Stratolink-hq/Stratolink/analysis/v1_1_release_20261012/uv_followup/README.md

# UV replacement decision for the three-board v1.1 pilot

2026-10-13. **Separate UVA and UVB measurements would materially improve the ozone experiment. AS7331 is the strongest compact integrated candidate identified, including after the expanded direct-LCSC search.** It requires a local PCB and firmware change. LCSC does list multiband UV parts, but the inspected AS7331 entries are unavailable; catalog existence and assembly inventory are different facts. An available detector with one combined UV output does not provide the missing second measurement.

My recommendation is **pursue AS7331 for the multiband pilot, with supplier allocation and a local ECO resolved before assembly release**. The observed DigiKey bare-chip arrival estimate is November 9, not a guaranteed delivery. No UV population change, DNP choice, or order has been made by this review. A successful electrical prototype does not require completed ozone-retrieval validation before fabrication; it does require raw data, characterized optics and honest experimental labeling. If obtaining the assembled boards immediately is the overriding requirement, the UV population/sourcing trade-off needs an explicit decision rather than silently omitting the sensor.

## What is actually available

Stock observations are from October 13, not reservations. Public distributor inventory does not establish JLC consignment acceptance or feeder allowance.

| Candidate | Measurement / current sourcing | Decision |
|---|---|---|
| LTR-390UV-01, C492374 | Present one UV channel plus separate visible ALS mode. JLC draft requires three and shows three short. | Retains the old capability only; does not meet the new multiband objective. |
| AS7331-AQFM / AQFT | Three separate UVA/B/C channels. Root's live JLC search: all seven entries have zero stock. Direct LCSC search: three listed bare-chip entries all zero; additional aliases below. DigiKey AQFM: zero, $9.16 at quantity one, 1,000 expected November 9; AQFT: zero, 4,949 expected November 9. Mouser AQFM: zero, 9,090 expected November 23. | Preferred compact **research** IC, not a presently allocated assembly part. Dates are estimates. |
| VEML6075 | UVA/UVB and compensation outputs, but Vishay terminated it in 2019. Root's live JLC C75329 and SB listings both zero. Canonical LCSC C75329 says Not available now. | A legacy comparison option if traceable old stock appears; weak basis for the next production batch. |
| ZOPT2202 | A third true integrated UVA/B part discovered in the broader search; Renesas marks it Obsolete. Direct LCSC exact-name search returns zero results; no authorized available bare stock found. | Interesting historical compact alternative, not a verified sourcing solution. |
| **GUVA-C22SD + GUVB-C21SD** | Smaller **2.4 × 1.8 mm** packages. Opened DigiKey pages show **2,717 / 5,863** respectively, **$4.13 / $4.64**, or **$8.77 per detector pair** at quantity one. | Practical stocked discrete ground-prototype alternative; add analog acquisition and cold qualification. LCSC's complete 39-part Genicom catalog shows zero stock. Not a same-footprint substitute. |
| GUVA-S12SD + GUVB-S11SD | Larger **3.5 × 2.8 mm** packages. Live DigiKey pages show **2,970 / 1,654** respectively, **$6.59 / $4.64**, or **$11.23 per detector pair**. | Retained comparison; the smaller C22SD/C21SD pair is preferable for initial space/cost evaluation. |

Evidence: [JLC AS7331 capture](../sourcing_followup/as7331-jlc-search.txt), [JLC VEML6075 capture](../sourcing_followup/veml6075-jlc-search.txt), [DigiKey AS7331 AQFM](https://www.digikey.com/en/products/detail/ams-osram-ag/AS7331-AQFM-OLGA16-LF-T-R/16983757), [AQFT](https://www.digikey.com/en/products/detail/ams-osram-ag/AS7331-T-OLGA16-LF-T-RDP/16983752), [Mouser AS7331](https://www.mouser.com/en/c/semiconductors/sensor-ics/ambient-light-sensors/?m=ams+OSRAM&series=AS7331), [Vishay termination notice](https://mm.digikey.com/Volume0/opasdata/d220001/medias/docus/320/PTN-OSI-01059-2019-Rev-0.pdf), [GUVA stock](https://www.digikey.com/en/products/detail/genicom-co-ltd/GUVA-S12SD/9960951), [GUVB stock](https://www.digikey.com/en/products/detail/genicom-co-ltd/GUVB-S11SD/9960952).

The smaller-pair stock, all 39 LCSC catalog entries, low-power amplifiers and signal calculations are documented in [the discrete-detector review](discrete-lcsc.md). JLC Global Sourcing and consignment are valid future routes, but require received inventory, exact MOQ/spare confirmation and separate procurement. No AS7331 allocation was obtained; current official overseas-consignment fee pages also conflict. [Procurement review](procurement.md).

The AS7331 manufacturer page still labels its orderables Pre-production, while DigiKey says Active. The page and v4-00 datasheet specify −40…85 °C; some distributor metadata says +105 °C. Use the primary −40…85 °C limit pending written exact-grade clarification. A listed 2025 substrate-supplier PCN is not an end-of-life notice. No sustainable-stock assurance was obtained. [Manufacturer product page](https://ams-osram.com/products/sensor-solutions/ambient-light-color-spectral-proximity-sensors/ams-as7331-spectral-uv-sensor), [manufacturer PCN](https://mm.digikey.com/Volume0/opasdata/d220001/medias/docus/6689/C_Prel-PCN_AO-PCN-2025-026-N_ext.pdf).

Root's live Browser resolved the conflicting public extraction for SparkFun SEN-23517: its actual product UI shows **$27.50, Backorder**, with the Backorder control disabled. Adafruit 6476 shows **$22.50, Out of stock**. Both corresponding DigiKey listings also show zero. These do not establish an immediately obtainable small reference board. [SparkFun live capture](../sourcing_followup/sparkfun-as7331-actual-ui.txt), [Adafruit live capture](../sourcing_followup/adafruit-as7331-actual-ui.txt), [SparkFun product](https://www.sparkfun.com/sparkfun-spectral-uv-sensor-as7331-qwiic.html), [DigiKey SEN-23517](https://www.digikey.com/en/products/detail/sparkfun-electronics/23517/22321024), [Adafruit product](https://www.adafruit.com/product/6476).

**One verified official bench-evaluation route exists:** DigiKey's AS7331 EVALKIT 0V2 page shows **three kits in stock, $321.07 each**. The manufacturer's EVK includes an optical adapter and USB interface. It can start optical/firmware research while bare devices are sourced; it does not supply three economical assembly parts and is not an ozone reference standard. The manual explicitly calls its supplied adapter a design example that is not fully UV-opaque; accurate angle control requires suitable opaque material, such as metal. Nothing was added to a cart. [DigiKey official EVK](https://www.digikey.com/en/products/detail/ams-osram-ag/AS7331-EVALKIT-0V2/16983753), [manufacturer EVK guide, §6](https://docs.rs-online.com/a3b1/A700000010106066.pdf).

## Expanded LCSC and supplier coverage

The following separates live Browser evidence supplied by the root agent from public-page extraction. Missing stock text is recorded as unknown, not zero. This is a bounded catalog review, not proof that every possible Chinese-market UV detector has been exhausted.

| Exact catalog evidence | Result on October 13 | Consequence |
|---|---|---|
| Direct LCSC AS7331 search; C17474749, C20484730, C20482877 | All three displayed entries zero; C17474749's own page explicitly Out of Stock. | Direct LCSC adds an alias missing from the original JLC search but no confirmed supply. |
| JLC AS7331 search; C5793699, C7529330, C22457702, C19189439, C20598550, C20482877, C20484730 | Seven entries, all zero in JLC/idle/my stock. | Do not conflate seven SKUs with seven different sensors. |
| LCSC VEML6075 C75329 | Canonical page Not available now; JLC C75329 and C19278419 VEML6075-SB zero. | A search result on `fat.lcsc.com` advertising 100 pieces was not accepted as production-site stock evidence. |
| LCSC Si1133-AA00-GMR C965911 / AA00-GM C3678545 | Root's direct pages explicitly Not available now. | Not an immediate fallback; spectral limitations below also apply. |
| LCSC Genicom photodiodes category | **All 39 results across both pages individually show zero stock**: 25 on page one, 14 on page two. | Covers the full displayed category, including several UVA and UVB packages. |
| Direct LCSC GUVA-S12SD C7200747; GUVB-S11SD C6954997; GUVB-C21SD C6565190; GUVB-S11SM-LA C5756514 | Each inspected public page Out of Stock. | The two analog responses exist in LCSC's catalog but were not available through these inspected listings. |
| Direct LCSC exact-name ZOPT2202 search | Zero results. | Confirms this query found no catalog entry; does not exclude every alias. |
| Indexed exact-name queries for sGlux and Hamamatsu S1226 | No confirmed appropriate available LCSC listing obtained. | Search absence is not a supplier-wide impossibility claim. |

Live captures: [LCSC AS7331 search](../sourcing_followup/lcsc-as7331-search.txt), [AS7331_M detail](../sourcing_followup/lcsc-as7331-C17474749.txt), [Si1133 GMR](../sourcing_followup/lcsc-si1133-C965911.txt), [Si1133 GM](../sourcing_followup/lcsc-si1133-C3678545.txt), [Genicom page one](../sourcing_followup/lcsc-genicom-page1.txt), [page two](../sourcing_followup/lcsc-genicom-page2.txt), [ZOPT2202 query](../sourcing_followup/lcsc-zopt2202-search.txt). Public pages: [VEML6075 C75329](https://www.lcsc.com/product-detail/C75329.html), [Genicom category](https://www.lcsc.com/brand/1263-13647.html), [GUVA-S12SD](https://www.lcsc.com/product-detail/C7200747.html), [GUVB-S11SD](https://www.lcsc.com/product-detail/C6954997.html), [GUVB-C21SD](https://www.lcsc.com/product-detail/C6565190.html), [GUVB-S11SM-LA](https://www.lcsc.com/product-detail/C5756514.html).

Additional bare-AS7331 coverage found Future Electronics global/factory/on-order inventories all zero (minimum reel 1,000, quoted 16 weeks). Avnet's indexed listing also showed zero; its fresh open failed. Arrow's indexed page said NRND and did not verify available stock; a fresh open failed. Rutronik's listing said on request/50 weeks. Farnell's distributor lifecycle label conflicts with ams' own page, so it is not treated as a manufacturer EOL declaration. These results do not justify trusting an unverified broker's large-stock claim. [Future Electronics](https://www.futureelectronics.com/p/semiconductors--analog--sensors--light/as7331-aqfm-ams-osram-3169993), [Avnet](https://www.avnet.com/americas/manufacturers/m/c/ams-osram/sensors-and-transducers-optical-sensors/), [Arrow](https://www.arrow.com/en/products/as7331-aqft/ams-osram.html), [Rutronik](https://www.rutronik24.com/pg/other-sensors/icinot/), [Farnell](https://de.farnell.com/ams-osram-group/as7331-aqfm/umgebungslicht-n-herungssensor/dp/4158736).

The SparkFun mini SEN-23518's public extraction has a conflicting stock-header/backorder presentation; DigiKey's opened mini page is zero. The standard SEN-23517 board's actual UI was separately resolved as backorder above. MikroE's own UV 5 Click page explicitly says it is no longer in stock. Micro Robotics' generic AS7331-MOD search result claimed local South African stock, but a stable detailed stock retrieval, chip provenance and US delivery were not established; it remains an unverified lead rather than the recommended supplier. [Mini DigiKey page](https://www.digikey.com/en/products/detail/sparkfun-electronics/23518/22321098), [MikroE](https://www.mikroe.com/uv-5-click), [generic-module lead](https://www.robotics.org.za/AS7331-MOD).

## Why the other integrated parts are not equivalent

**ZOPT2202** measures separate UVA/UVB with compensation channels. Its 1.7–3.6 V, −40…90 °C, 2.0 × 2.2 × 0.7 mm LGA6 is attractive electrically and mechanically, but it is obsolete and its pins differ from U6: 1 SCL, 2 SDA, 3 VDD, 4 INT, 5 GND, 6 NC. Its raw mode requires a specific initialization and application compensation; the datasheet calls for another application note for digital trimming. It would need a new footprint, wiring and driver, not just a BOM substitution. [Renesas product status](https://www.renesas.com/en/products/zopt2202), [datasheet §§3.3–3.4](https://www.renesas.com/en/document/dst/zopt2202-datasheet).

**VEML6075** has separate outputs, but the primary datasheet puts the nominal “UVB” peak at 330 nm, in UVA, with a short-wavelength tail. A channel label does not establish an optimal ozone-sensitive UVB response. Its 4-pad 2 × 1.25 mm land pattern also differs from U6. [Vishay datasheet](https://mm.digikey.com/Volume0/opasdata/d220001/medias/docus/1256/VEML6075.pdf).

**Si1133** actually measures UV, unlike a visible/IR-only UV-index estimate. Its ADC mux exposes UV and UV-Deep selections, but the inspected datasheet specifies one UV sensitivity point at 310 nm, not a characterized independent UVA/UVB pair; its dual ADCs also serve dark-reference cancellation. Establishing usable independent band responses would need spectral characterization rather than assuming “Deep” means a second desired band. The manufacturer-authored Rev 0.91 is marked Not Recommended for New Design. [Si1133 datasheet §§3.1–3.2, 7.2.1, 8](https://www.mouser.com/datasheet/2/368/Si1133-1397754.pdf).

**sGlux filtered UVA and UVB photodiodes** are a legitimate alternative family, but they are separate analog detectors requiring front-end circuitry and optical qualification. **Hamamatsu broad UV-enhanced photodiodes** need suitable filters and strong visible rejection to form a ratio instrument. Neither yields a verified in-stock, same-footprint LCSC digital substitute from this search. [sGlux primary catalog](https://sglux.de/en/product-category/sic-uv-photodiodes/).

## AS7331 integration scope

The native audit was rerun after the R4/U2 metadata promotion on canonical `hardware/pcb/stratolink.kicad_pcb`, SHA-256 `8e2f83797dd68195aa71b73fc252fe57e53ccd3683ef5f74739dc4d25d6ce8d5`. U6 is front-side at (69.098, 40.606) mm. Its six pins are +3.3 V, NC, GND, SCL, grounded INT, SDA, and still match the freshly exported schematic netlist. **The release has already corrected the old schematic/footprint identity mismatch.** The unused older `hardware/v1.1` tree is not the current release. [Promotion evidence](../sourcing_followup/promotion.json).

AS7331 uses a 2.60 × 3.65 × 1.09 mm OLGA16 body, 2.7–3.6 V supplies and I²C. At 3.3 V its specified active current is 1.42 mA typical / 2 mA maximum, standby 970 µA maximum, power-down 1 µA maximum at the electrical table's conditions. It needs a 3.3 MΩ ±1%, ≤50 ppm/K reference and local supply decoupling. The newly opened manufacturer-hosted PDF is the same v4-00 revision as the locally cached copy. [Manufacturer v4-00 datasheet](https://look.ams-osram.com/m/1856fd2c69c35605/original/AS7331-Spectral-UVA-B-C-Sensor.pdf).

Proposed net mapping for a future ECO:

| AS7331 pins | Proposed connection |
|---|---|
| 1, 2, 5, 6, 15, 16 VSSA; 11 VSSD | Ground; implement short analog/digital return connection near the chip |
| 3 VDDA; 10 VDDD | Existing 3.3 V, locally decoupled |
| 4 REXT | Specified reference to VSSA, same PCB side |
| 7 A1; 14 A0 | GND, selecting 0x74; existing MS5611 uses 0x76 |
| 12 SDA; 13 SCL | Existing I²C bus; verify combined pull-ups and rise time |
| 8 SYN; 9 READY | Optional test provisions; polled command mode needs no extra MCU pins. Give unused SYN a defined level; do not ground the READY output. |

The replacement needs all-new lands and escapes; the present six pads cannot be reused. The reviewed U7 routing immediately north of U6 includes a specific 0.128 mm passage next to U6 pad 6. Reopening this area requires a fresh U7 keepout, clearance, decoupling, placement, paste and optical-obstruction review; remove obsolete U6-specific rule exceptions if their geometry disappears. No replacement placement, routing or mass measurement has been done here. [Current local assembly review](../identities/README.md), [native audit](audit.json).

The modest measurement power is not the main obstacle. Calculated module-only costs are 6.6 mJ for one second at the table maximum, 110 µW measurement average at one second/minute, or 1.406 J for five minutes at typical active current. These exclude MCU, converter and bus overhead and do not select an exposure. Use explicit power-down after daylight windows; standby would consume 3.20 mW. Verify leakage and restart at the actual component temperature. A −40 °C rating does not establish operation in colder air or at low pressure.

Firmware requires a new driver and explicit hardware population selection, not an address change. Preserve bounded I²C timeouts, reset recovery, conversion-complete checks and the existing optical quiescence fault policy. AS7331 command mode can wake for one conversion and return to power-down. Log all raw channels, gain, integration time, divider, flags and die temperature with fresh UTC/position. Its shared exposure settings mean bright UVA and weak UVB may require bracketed exposures; retain simultaneous samples within each exposure.

The current telemetry only carries integer UVI and visible lux. **AS7331 does not replace visible ALS.** Mark legacy `ambient_lux` unavailable; do not manufacture lux from UV or leave stale values. Version the science payload and decoder to retain multiband counts and configuration. Search found no `ambient_lux` input to current firmware power decisions; power gating uses the ADC policy. The present LTR driver already treats a never-enabled absent sensor as quiescent, which supports a deliberate DNP build, but pilot firmware should explicitly select that population to avoid pointless retries. Sources: `firmware/src/sensor_ltr390.cpp`, `main.cpp`, `telemetry.cpp`, `include/telemetry.h`, `stratolink_pins.h`; hashes in the audit.

## What this adds to ozone measurement

A second UV band adds ozone-sensitive information. In a simplified calibrated direct-beam model,

`ln(B/A) = known spectral baseline − m × ozone_column × (effective_absorption_B − effective_absorption_A) + differential_nuisance`.

The ratio can cancel a common illumination factor. If differential cloud/aerosol transmission, angular filter shift, stray light or relative gain are unknown, ozone and those effects still cannot be separated from that ratio alone. Broad-band effective absorption also depends on the transmitted spectrum. This is a structural limitation, not something more ADC bits removes. A third UVC channel can be valuable diagnostically but may have very little solar signal below most of the ozone layer.

**Newly verified optical detail:** ams' design guide explicitly recommends detector incidence within ±10° because oblique rays shift/deform its interference filters. It places a diffuser **in front of angle-limiting optics**, not directly on the detector. The guide also confirms that gain/time settings are shared across channels and calls for dark, gain, temperature and spectral-response corrections. This resolves the older report's uncertainty about the incidence specification. [AS7331 Design Guidelines, §§2, 4, 7](https://look.ams-osram.com/m/45d5dfb4a22ecb04/original/AS7331_Design_Guidelines_PD001048_2-00.pdf).

An ozone prototype therefore needs an unobstructed, characterized optical collector; dark/linearity/saturation checks; angular and temperature sweeps; and a spectral forward model fitted and evaluated on independent data. Start fixed on the ground against a calibrated spectral reference, then add the real enclosure and motion. Published spectral double-ratio methods support that validation path, not a promised accuracy for this chip. [Egli et al., 2023](https://amt.copernicus.org/articles/16/2889/2023/).

The attainable product is initially raw/calibrated UV measurements and an experimental **ozone column above the balloon**. It is not local ozone concentration or automatically a vertical profile. The historical LTR390 note's numerical precision promises remain unsupported. Nothing here establishes a percentage ozone accuracy.

## Stocked analog alternative: useful, but a larger experiment

The practical discrete candidate is **GUVA-C22SD + GUVB-C21SD**, costing **$8.77 in detectors** at the observed single-unit prices, each in a 2.4 × 1.8 mm package. GUVA-C22SD responds over 240–370 nm; the DigiKey-linked 2018 GUVB-C21SD sheet gives 240–320 nm. These are overlapping responses, not isolated rectangular bands. Both are specified only to −30 °C. A newer GUVB sheet changes the stated responsivity and lower band edge, so the purchased lot needs a controlled specification and calibration. [GUVA-C22SD source](https://www.digikey.com/en/products/detail/genicom-co-ltd/GUVA-C22SD/9960950), [GUVB-C21SD source](https://www.digikey.com/en/products/detail/genicom-co-ltd/GUVB-C21SD/10474936), [detailed comparison](discrete-lcsc.md).

Each produces photocurrent, so add two low-leakage transimpedance paths, feedback/compensation components and ADC acquisition, or an I²C ADC on a reference daughterboard. Two LCSC-stocked TSU111ICT amplifiers add **$3.662**, bringing detectors/amplifiers to **$12.432** before passives, ADC, optics and assembly. Their calculated amplifier-only idle consumption is **5.94 µW typical**, or **9.77 µW maximum at the specified full-temperature conditions**, at 3.3 V. ADC/reference power and actual PCB leakage remain to be designed. This supports a concrete ground experiment without promising a ready replacement for U6. [AFE sources and reproducible model](discrete-lcsc.md).

The older **GUVA-S12SD + GUVB-S11SD** comparison costs **$11.23 for detectors alone** and uses larger 3.5 × 2.8 mm packages. It has similar overlapping broad UV responses and the same −30 °C operating limit. Its higher price is for a different package pair, not a second quote for the smaller candidate. [GUVA-S12SD datasheet](https://mm.digikey.com/Volume0/opasdata/d220001/medias/docus/6128/GUVA-S12SD%20%282%29.pdf), [GUVB-S11SD datasheet](https://mm.digikey.com/Volume0/opasdata/d220001/medias/docus/5786/GUVB-S11SD_Rev1.0_2018.pdf).

For scale only, GUVB's typical sunlight example gives 1.4 nA at UVI 1. A hypothetical 10 MΩ transimpedance gives 14 mV: about 17 counts on an ideal 12-bit, 3.3 V ADC. That illustrates why analog leakage, noise and offsets need attention; it is not a universal UVI conversion, selected amplifier design or ozone precision estimate. The detector itself needs no supply in photovoltaic mode. The amplifier budget above is only part of the complete acquisition budget.

ML8511A's one analog output is sensitive to both UVA and UVB together; replacing LTR390 with it would not produce a ratio. AS7341/AS7343/TCS3448 visible/NIR spectral parts similarly do not supply the needed short-UV channel. “Multispectral” alone is not the requirement. [ROHM ML8511A datasheet](https://www.rohm.com/documents/11303/4214223/FEDL8511A-02-e.pdf), [ams AS7343/TCS3448 product information](https://ams-osram.com/de/products/sensor-solutions/ambient-light-color-spectral-proximity-sensors/ams-as7343-spectral-sensor).

This review performed no CAD or firmware edits, supplier selections or purchases. Reproduce the pin and arithmetic evidence with KiCad's bundled Python and `audit.py`. Research used cached primary datasheets plus public web fallback explicitly authorized by the parent after this subagent's documented in-app Browser discovery returned no backends. Root supplied the live JLC and direct LCSC evidence. [Source ledger and retrieval limits](SOURCES.md).
