Stratolink-hq/Stratolink/analysis/v1_1_suspension_20261012/sources/README.md

# Source scope

Read 2026-10-12 in the Codex in-app browser.

- [JLCPCB capabilities](https://jlcpcb.com/capabilities/pcb-capabilities): current thin-board, dimensional, drilling, copper plating and mask capabilities. Saved visible table text accompanies this record. A 2 mm ordinary plated hole does not invoke the thicker-board requirement for plated board edges/castellations. The 18 µm barrel figure is an **average**, not a minimum or guaranteed mechanical reinforcement. Finished hole tolerance is +0.13/−0.08 mm; position ±0.075 mm; actual fabrication compensation is not measured here.
- [Shengyi S1141](https://www.syst.com.cn/en/product/info_122.aspx?itemid=1176): manufacturer typical material data. Reported flexural data use **1.6 mm specimens** and are not qualified allowables for the unknown laminate and 0.31 mm core in this payload. No strength safety factor or failure load is derived from them.

The strongest geometry evidence is the actual frozen KiCad board at `a9d6ed5`. The line topology comes from Teddy's description of stretchy string threaded through both holes and tied into a triangular suspension at the top. Diameter, material, friction, creep, knots, preload and apex height remain unmeasured.
