Stratolink-hq/Stratolink/analysis/v1_1_solar_attachments_20261012/qualification/sources/README.md

# Primary photo source

The in-app browser captured the first photo on [ZachTek SKU1044](https://www.zachtek.com/product-page/copy-of-solar-cell-for-pico-balloons-polymer-4-8v-50ma) on 2026-10-12. The photo contains a printed metric grid used for the panel dimension calibration. The source is preserved as `zachtek-metric-photo-browser.png`; its hash is recorded and verified by `../metrology/measure.py`.

The rendered product image's DOM supplied this [Wix-hosted image URL](https://static.wixstatic.com/media/859ef0_be8b73c86bbd4d29b8d6aa655b6c03f7~mv2.jpg/v1/fill/w_962,h_1102,al_c,q_85,usm_0.66_1.00_0.01,enc_avif,quality_auto/859ef0_be8b73c86bbd4d29b8d6aa655b6c03f7~mv2.jpg). It was viewed directly in the browser and captured there. Use pixel coordinates from the saved capture; its image region does not occupy the full 1280 × 1102 screenshot.

The product listing supplies nominal 4.8 V, 50 mA and 1.76 g but no mechanical drawing, prepared terminal thickness or joint strength. Existing vendor-text and assembly-guidance captures are in the parent study's `sources/` directory. Similar PowerFilm products were investigated but no positive manufacturer/part match was established, so none of their dimensions or material specifications are assigned to this panel.
