Stratolink-hq/Stratolink/web/ASSETS.md

# Assets

## Launch scene

The source is Teddy Warner's launch photograph, supplied as `/Users/twarn/Downloads/IMG_3466.jpeg` (2560 × 1440). The unchanged source photo is served locally as `public/assets/launch/source.jpg`.

| Asset | Dimensions | Use |
| --- | --- | --- |
| `public/assets/launch/source.jpg` | 2560 × 1440 | Source photograph for the layer compiler and placeholder |
| `public/assets/launch/sky.webp` | 2560 × 1440, RGB | Served sky plate: `sky.png`'s colour with the original photograph's detail in clear sky (`scripts/prepare-launch-sky.py`) |
| `public/assets/launch/social-card.jpg` | 1200 × 630 | Still link-preview card: graded crop of the original photograph with the wordmark; frame 0 of the loop |
| `public/assets/launch/social-card-loop.gif` | 1200 × 630, 223 frames | Link-preview image (`og:image`, `twitter:image`): the balloon rises out of frame, then the next rises from the clouds into place (8.9 s loop) |
| `public/assets/launch/social-card-loop.mp4` | 1200 × 630, H.264 | The same loop as `og:video`; iMessage autoplays it muted and looped |
| `public/assets/launch/sky.png` | 1672 × 941, RGB | Clear sky plate inpainted with the built-in image generator; fills behind the moving city, clouds and balloon |
| `public/assets/launch/city-clouds.png` | 1672 × 941, RGBA | Generated alpha mask for the original skyline, clouds and foreground palm |
| `public/assets/launch/balloon.png` | 1672 × 941, RGBA | Generated alpha mask for the original balloon, tether and payload |
| `public/assets/launch/city-desktop.webp` | 2560 × 1440, RGBA | Compiled desktop foreground |
| `public/assets/launch/city-mobile.webp` | 2560 × 1440, RGBA | Compiled mobile foreground with sky residue removed |
| `public/assets/launch/balloon-cutout.webp` | 205 × 403, RGBA | Compiled balloon, tether and payload |
| `public/assets/stratolink-wordmark.svg` | 7581 × 1510 viewBox | Lowercase Stratolink wordmark, Helvetica Regular converted to outlines; header and footer |

The original extraction files supply alpha only; their generated RGB pixels are not displayed. `scripts/prepare-launch-layers.mjs` compiles the original photograph through those masks using the same SVG filters. It writes `city-desktop.webp`, `city-mobile.webp` and the tightly cropped `balloon-cutout.webp`. The mobile version retains the alpha transfer that removes faint sky residue. The balloon keeps its dilated, feathered tether and restricted mask bounds. Runtime layers are transparent images, so phones do not need to rasterize the SVG filters. Regeneration requires `rsvg-convert` and `cwebp`; the compiled files are committed and deployment has no extra tool dependency.

The city layers retain the photograph's 2560 × 1440 framing. The balloon is a 205 × 403 crop at (1228, 432), positioned within that same frame. Encoding uses WebP quality 90 and alpha quality 100. The sky plate remains an inpainted approximation of the original clear-sky gradient, including areas originally hidden by foreground objects.

The served sky is rebuilt at the full 2560 × 1440 with `python3 scripts/prepare-launch-sky.py /path/to/IMG_3466.jpg` (numpy, Pillow, `cwebp`). The full-quality original is needed: `source.jpg` is a heavily compressed copy whose sky shows block artefacts when phones scale it up. The script keeps `sky.png`'s colour and gradient everywhere, adds the photograph's own grain where the sky is clear, and matching synthetic grain where the city, clouds and balloon hide it.

The homepage also carries a 32 × 18 blurred placeholder of `source.jpg` inlined as a base64 WebP in `index.html` (between the `home-placeholder` markers). It paints behind the hero while the full layers download. Regenerate it with `node scripts/prepare-launch-placeholder.mjs` (requires ImageMagick `magick`) after changing the source photograph.

Exact built-in image generation prompts, output provenance and known extraction limits are recorded in [reference/launch-layer-prompts.md](reference/launch-layer-prompts.md). Page text uses Helvetica with Arial as a fallback.

An unused white-cloud experiment is archived at `reference/experiments/footer-cloud.png`, outside the production build. Its exact prompts and native output provenance are recorded in [reference/footer-cloud-prompt.md](reference/footer-cloud-prompt.md).

## Inline payload

`public/assets/launch/payload-cutout.png` is a 384 × 256 transparent extraction generated from Teddy's `DSCF0471.JPG`. It appears inline in the homepage's fourth paragraph. The original photograph is unchanged. [Prompt and provenance](reference/payload-cutout-prompt.md) record the built-in imagegen edit and its limits.

## Dashboard

The dashboard's logo and TTN gateway files are unchanged copies from [`Stratolink-hq/Stratolink` at `b95c4f4`](https://github.com/Stratolink-hq/Stratolink/tree/b95c4f4dee684e73fbfdb2d5af2df13a3dd87949/web/public), imported October 5, 2026. Their original public paths are preserved.

| Runtime file | Bytes | Use |
| --- | ---: | --- |
| `public/stratolink-header-logo.png` | 109,433 | Dashboard header wordmark |
| `public/ttnmapper-gateways.json` | 577,506 | Gateway coordinates |
| `public/ttnmapper-coverage.json` | 788,268 | Inner coverage polygons |
| `public/ttnmapper-coverage-outer.json` | 490,552 | Outer coverage polygons |
| `public/assets/dashboard/fonts/*.woff2` | 285,052 total | 13 unchanged Inter and JetBrains Mono files served by the live site's Next font stylesheet |

Font faces, Unicode ranges and fallback metrics are preserved in `src/dashboard/fonts.css`. The telemetry theme retains its upstream Google Fonts import for Space Grotesk, Inter and JetBrains Mono. Mapbox supplies map styles, tiles and night-light imagery at runtime; these are not copied into the repository. Public telemetry and forecasts remain live data rather than bundled snapshots.

The imported dashboard assets total 2,250,811 bytes. [Dashboard import provenance](reference/dashboard-import.md) records their SHA-256 hashes, font source URLs and runtime dependencies.

## Archived Opal reference assets

The Opal visual assets and fonts were retrieved from [Opal Electronics](https://op.al/) on October 5, 2026 for the initial local reference recreation. They are preserved under `reference/opal-assets/`, outside `public/`, and are not shipped by the current page.

| Local file | Original source | Details |
| --- | --- | --- |
| `reference/opal-assets/DieGrotesk-C-Regular.woff2` | [Regular font](https://op.al/fonts/DieGrotesk-C-Regular.woff2) | Die Grotesk C, weight 400 |
| `reference/opal-assets/DieGrotesk-C-Bold.woff2` | [Bold font](https://op.al/fonts/DieGrotesk-C-Bold.woff2) | Die Grotesk C, weight 700 |
| `reference/opal-assets/desktop-first-frame-long-may6.avif` | [Desktop poster](https://op.al/images/desktop-first-frame-long-may6.avif) | 2160 × 3840, original desktop first frame |
| `reference/opal-assets/mobile-first-frame-may6.avif` | [Mobile poster](https://op.al/images/mobile-first-frame-may6.avif) | 1440 × 7300, original mobile first frame |
| `reference/opal-assets/noise.avif` | [Noise texture](https://op.al/images/noise.avif) | 400 × 400, original grain tile |
| `reference/opal-assets/footer-canvas-logo.svg` | [Footer logo](https://op.al/svg/footer-canvas-logo.svg) | 1561 × 743 viewBox, canvas dot mask |
| `reference/opal-assets/opal-electronics.svg` | [Homepage](https://op.al/) | Header SVG extracted from the public HTML, 130 × 40 viewBox |
| `reference/opal-assets/share-1200x630.jpg` | [Share image](https://op.al/images/share-1200x630.jpg) | Original social preview image |
| `reference/opal-assets/table-desktop.mp4` | [Desktop video stream](https://stream.mux.com/YB6EvIvPQIBZ02XNCo4FyikxpaamDsTp4OSgtSxVJlIM.m3u8) | 2160 × 3840, 118.3 seconds; H.264 CRF 24, original resolution, fast start |
| `reference/opal-assets/table-mobile.mp4` | [Mobile video stream](https://stream.mux.com/i00IsRNG1QFKYPOWSEDqo4eTloV2E2heEd2wzXMMbNgo.m3u8) | 758 × 3840, 49.43 seconds; original H.264 stream remuxed with fast start |

The reference footage, fonts, logos and copy remain their respective owners' work. `reference/opal-essay.html` preserves the original page reference. Original media has been moved, not deleted.

- `public/assets/icons/`: Font Awesome Free 7.3.1 solid chevron, bars, and close icons from the installed package. Icons by Fonticons, Inc., licensed under [CC BY 4.0](https://fontawesome.com/license/free).

## Globe favicon

`public/assets/favicon/` and `public/favicon.ico` are generated by `python3 scripts/favicon.py` (Pillow required). The orthographic globe uses the footer map's pale land and blue-gray ocean palette, with 96 small rotation frames. The geometry is Natural Earth land data from [world-atlas 2.0.2](https://cdn.jsdelivr.net/npm/world-atlas@2.0.2/land-110m.json). Source data and the world-atlas ISC license are preserved in `reference/favicon/`. These icons are locally rendered, not Mapbox tile captures.
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
