Stratolink-hq/Stratolink/analysis/v1_1_resubmit_20261108/REPRODUCING.md

# Reproducing the November 8 review

Run from the repository root. Use KiCad 10.0.0 CLI and its bundled Python (`pcbnew`, `wx`), plus a separate Python environment with Shapely 2.1.2. The recorded analysis environment is `analysis/.venv/bin/python`. Matplotlib 3.10.9 is needed only for the optional comparison plots. Existing helpers under the October analysis directories are tracked dependencies; no CAD snapshots or browser/email records need to be committed again.

## Restore captured inputs without overwriting files

This restores only local analysis inputs, never canonical hardware. The original PCB, schematic, rules/tables and footprint libraries come from `46264ef`. The captured project file comes from `320fc08`, which includes the preserved editor settings. The R1 pre-substitution source also comes from `320fc08`.

Every Git blob must match the recorded SHA-256. Existing files must already match; the script refuses to overwrite a differing file. New files use exclusive creation.

```sh
python3 - <<'PY'
from pathlib import Path
import hashlib, json, subprocess
root = Path(subprocess.check_output(['git', 'rev-parse', '--show-toplevel'], text=True).strip())
review = root / 'analysis/v1_1_resubmit_20261108'
def restore(commit, name, destination, expected):
    data = subprocess.check_output(['git', 'show', f'{commit}:hardware/pcb/{name}'], cwd=root)
    assert hashlib.sha256(data).hexdigest() == expected, (commit, name, 'Git blob mismatch')
    if destination.exists():
        assert destination.read_bytes() == data, (destination, 'existing file differs; left untouched')
    else:
        destination.parent.mkdir(parents=True, exist_ok=True)
        with destination.open('xb') as handle:
            handle.write(data)
    print('verified', destination.relative_to(root))
for name, digest in json.loads((review / 'layout/input-hashes.json').read_text()).items():
    commit = '320fc08' if name == 'stratolink.kicad_pro' else '46264ef'
    restore(commit, name, review / 'layout/before' / name, digest)
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
