Stratolink-hq/Stratolink/analysis/v1_1_bare_finish_20261012/canonical-open.png

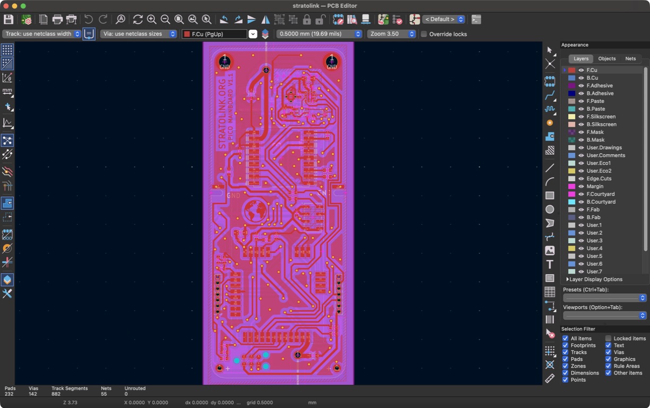
analysis/v1_1_bare_finish_20261012/canonical-open.png
