Stratolink-hq/Stratolink/analysis/v1_1_bare_finish_20261012/mask/native-bare-back.png

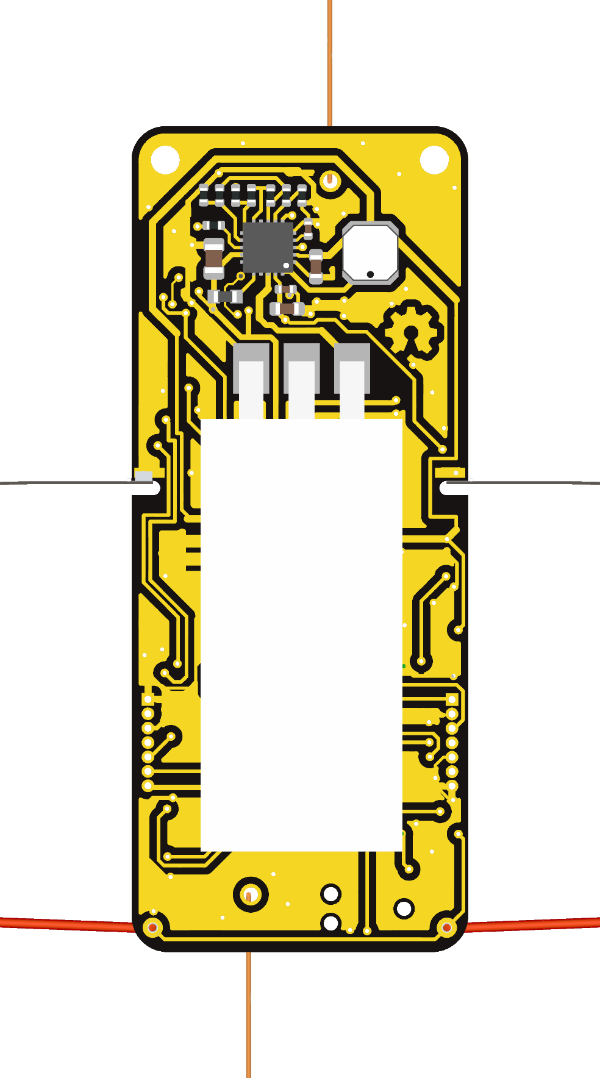
analysis/v1_1_bare_finish_20261012/mask/native-bare-back.png
