Stratolink-hq/Stratolink/analysis/v1_1_edges_20261012/review/remote-refill-corner-r1.png

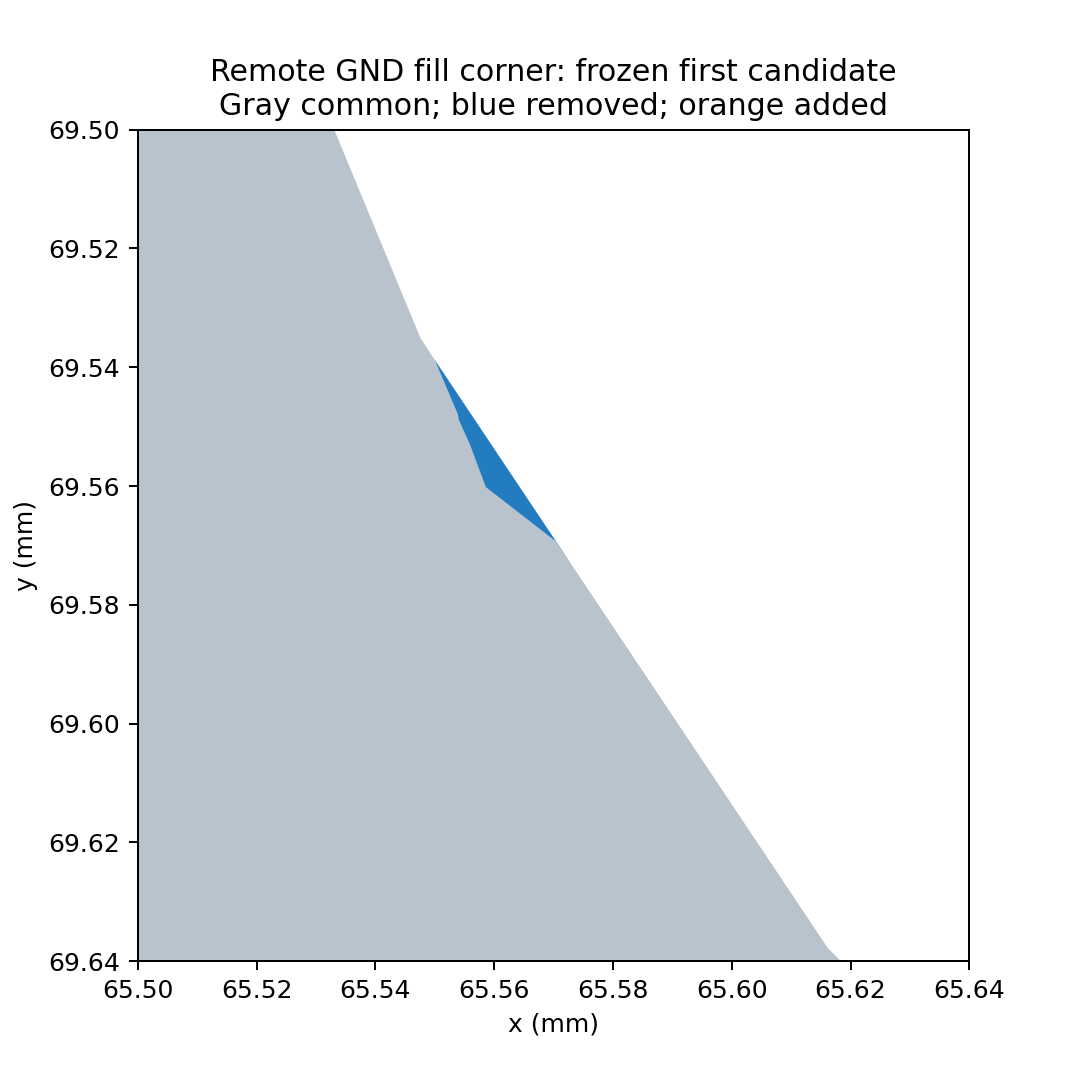
analysis/v1_1_edges_20261012/review/remote-refill-corner-r1.png
