Stratolink-hq/Stratolink/analysis/v1_1_engineer_review_20261015/rf-power/rf-launch.png

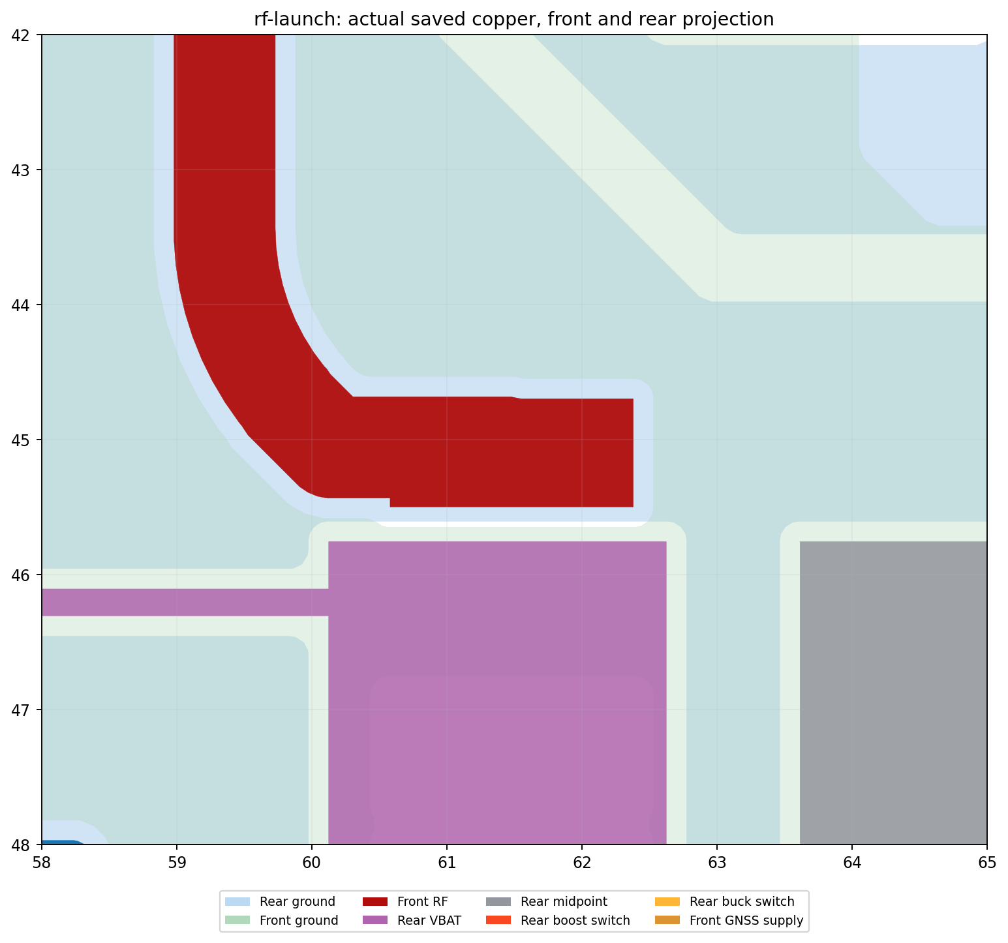
analysis/v1_1_engineer_review_20261015/rf-power/rf-launch.png
