Stratolink-hq/Stratolink/analysis/v1_1_engineer_review_20261015/rf-power/upper.png

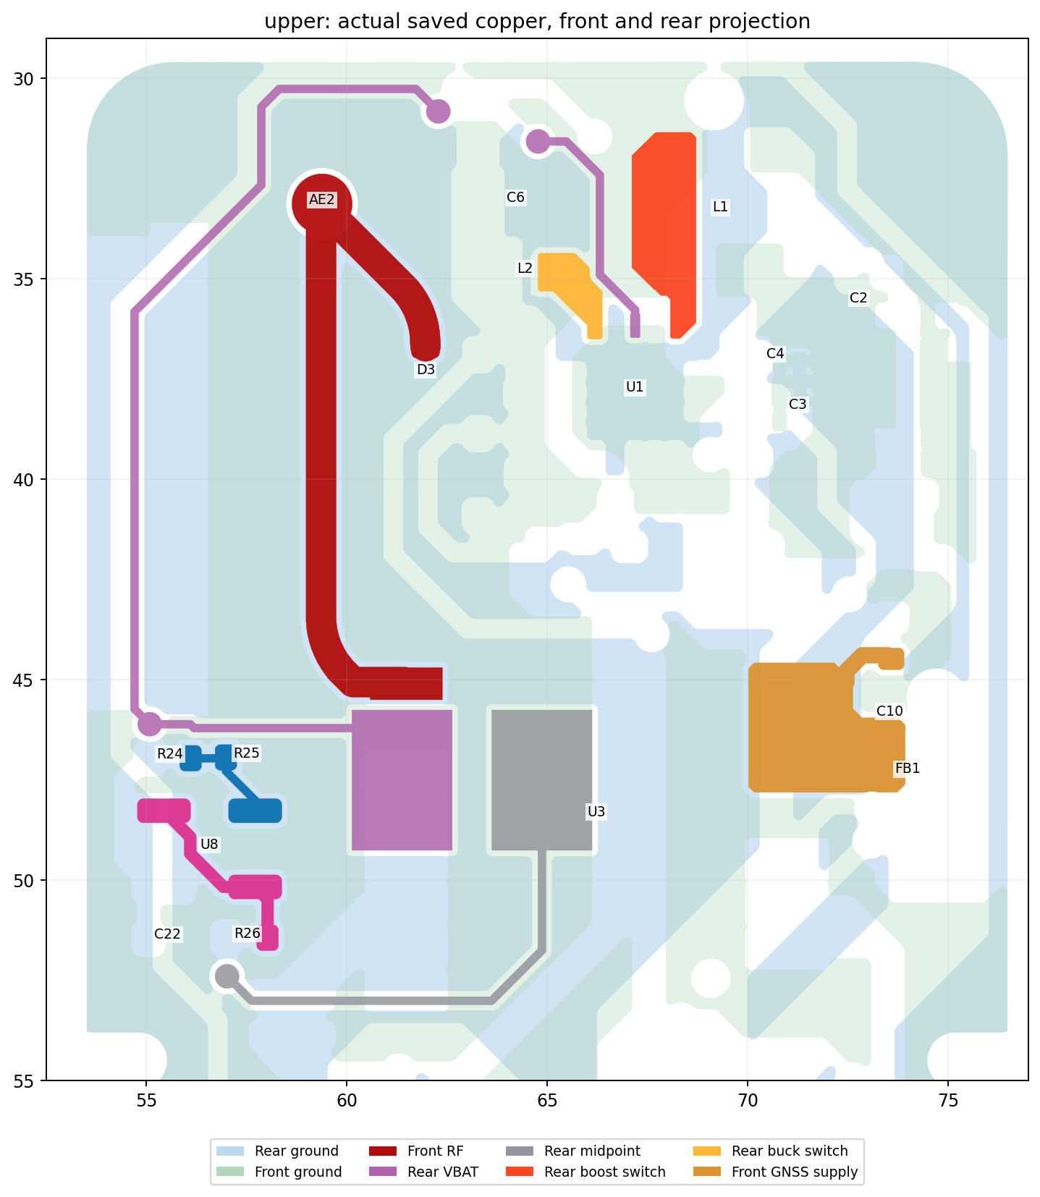
analysis/v1_1_engineer_review_20261015/rf-power/upper.png
