Stratolink-hq/Stratolink/analysis/v1_1_final_sweep_20261016/jlc/placement-bottom-final.png

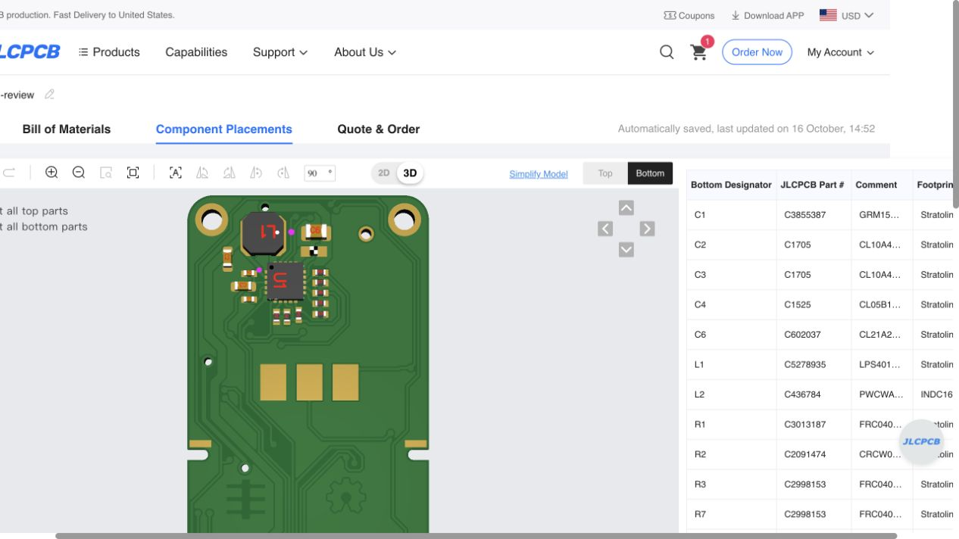
analysis/v1_1_final_sweep_20261016/jlc/placement-bottom-final.png
