Stratolink-hq/Stratolink/analysis/v1_1_final_sweep_20261016/mechanical/visual/bottom.png

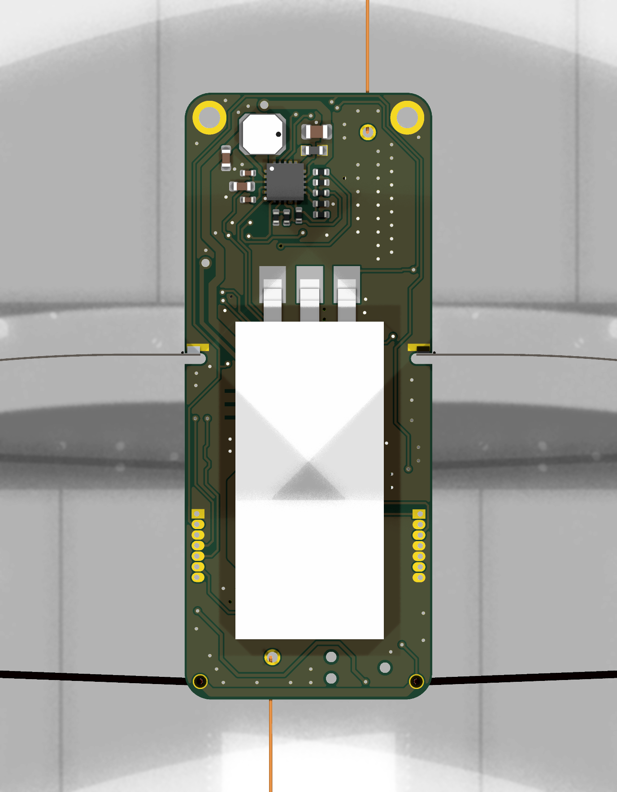
analysis/v1_1_final_sweep_20261016/mechanical/visual/bottom.png
