Stratolink-hq/Stratolink/analysis/v1_1_peer_review_20261014/digital/sources/max-m10s-mechanical.png

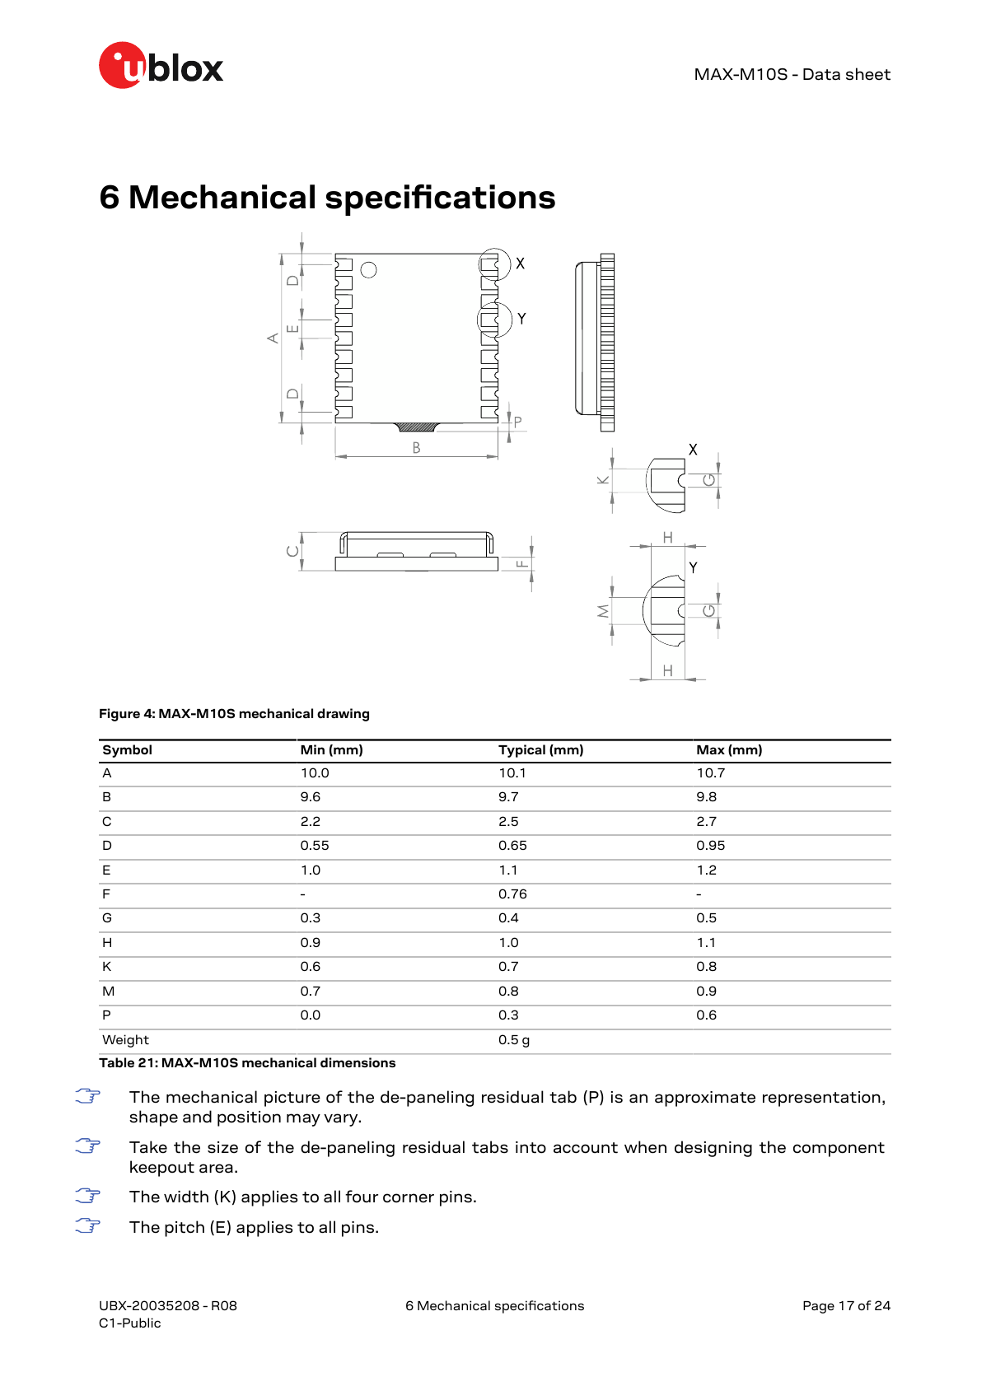
analysis/v1_1_peer_review_20261014/digital/sources/max-m10s-mechanical.png
