Stratolink-hq/Stratolink/analysis/v1_1_peer_review_20261014/rf/route-grid.png

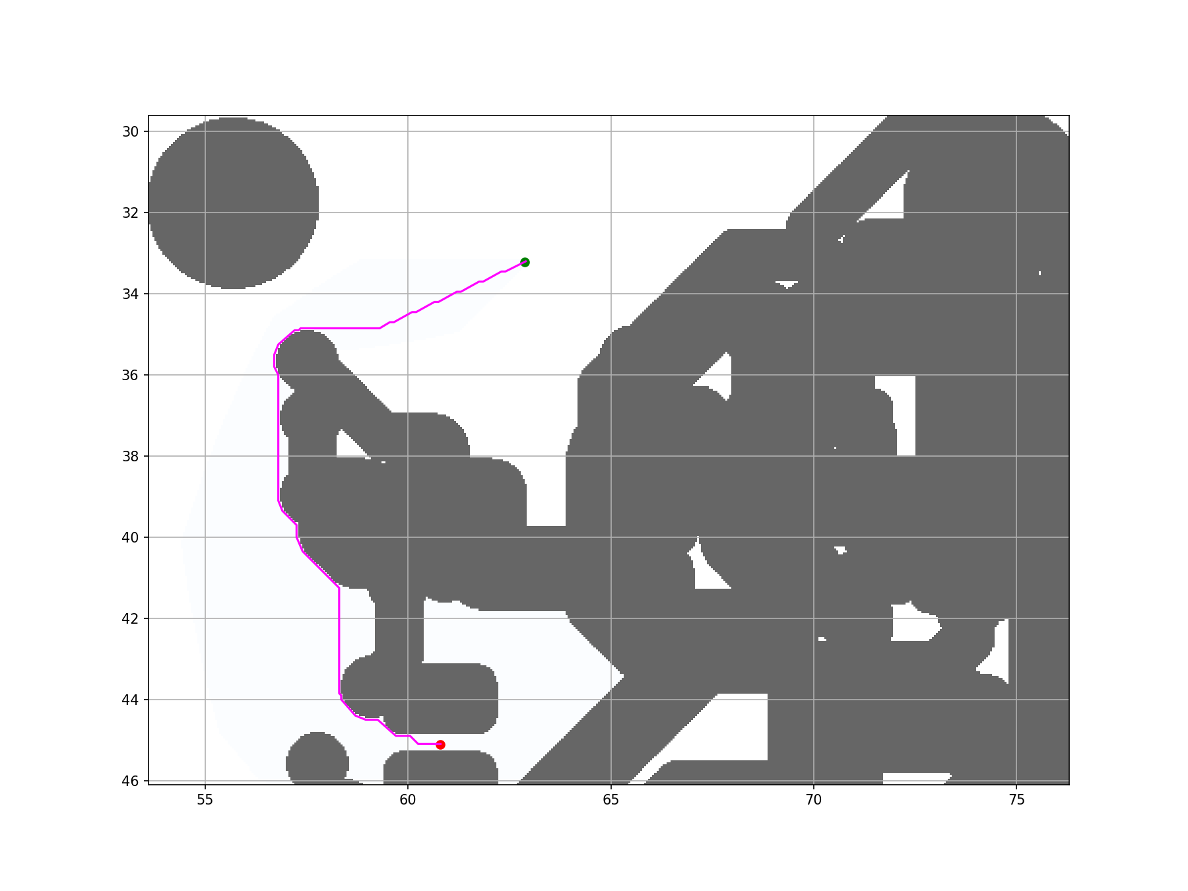
analysis/v1_1_peer_review_20261014/rf/route-grid.png
