Stratolink-hq/Stratolink/analysis/v1_1_release_20261012/as7331/cad/blocked-powergood-back-east1.png

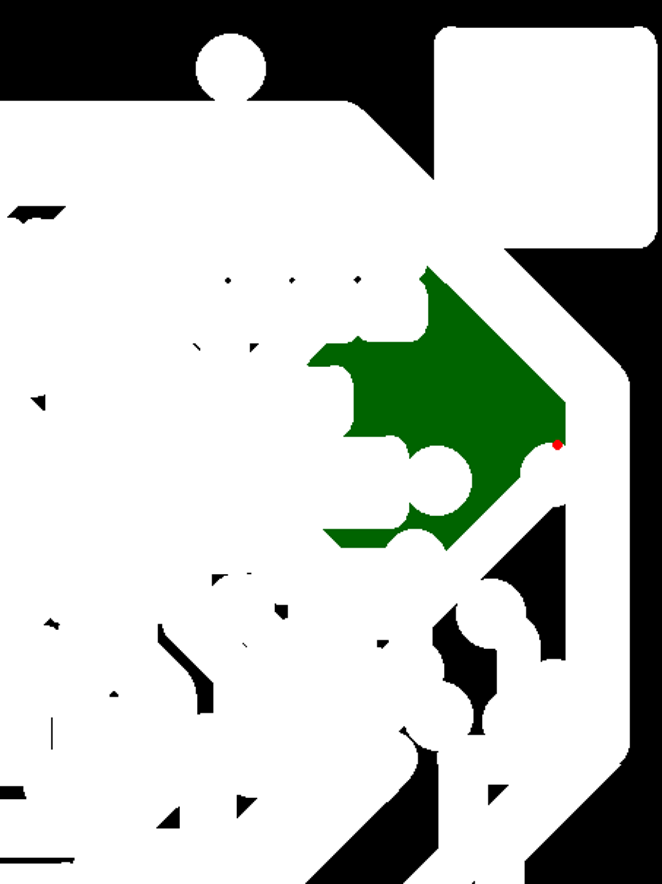
analysis/v1_1_release_20261012/as7331/cad/blocked-powergood-back-east1.png
