Stratolink-hq/Stratolink/analysis/v1_1_release_20261012/as7331/cad/blocked-vstor-detour0.png

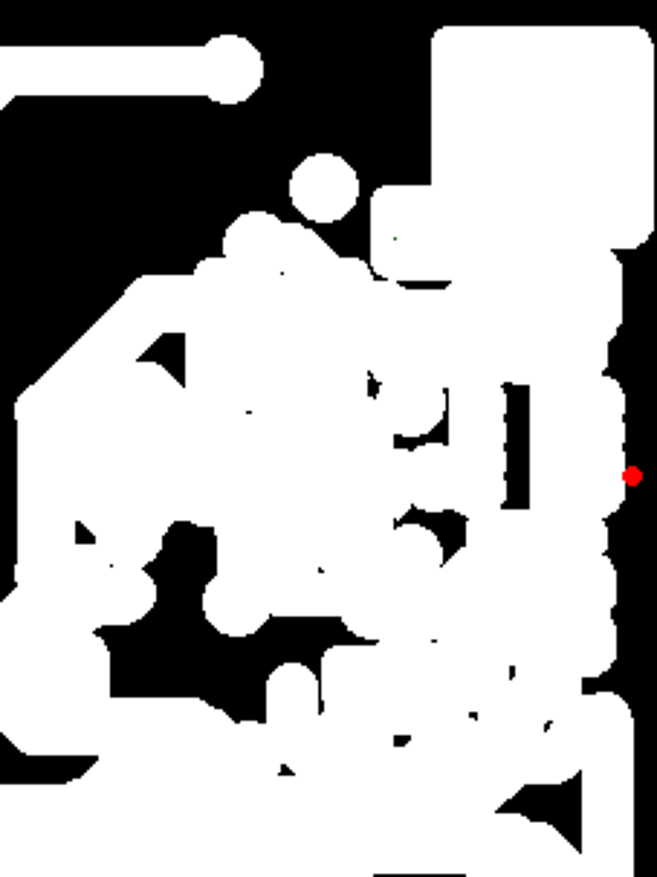
analysis/v1_1_release_20261012/as7331/cad/blocked-vstor-detour0.png
