Stratolink-hq/Stratolink/analysis/v1_1_release_20261012/as7331/jlc/placement-bottom.png

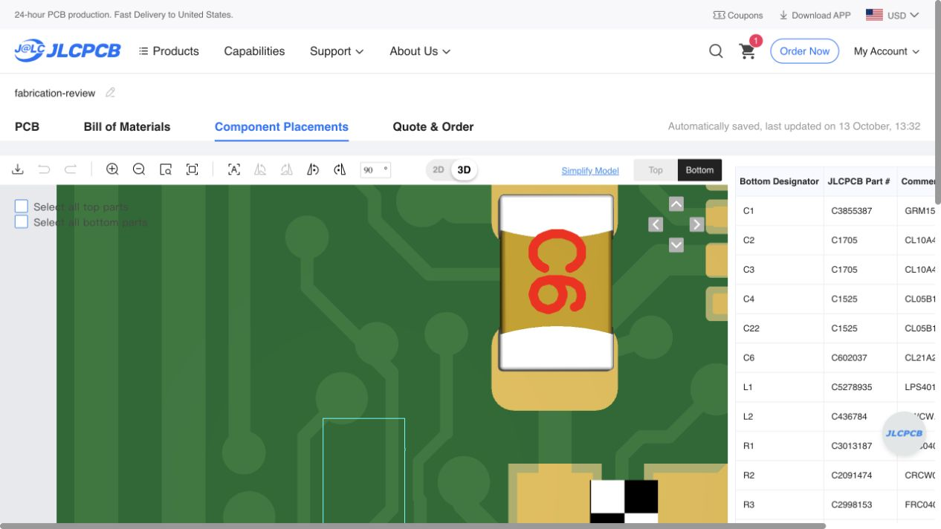
analysis/v1_1_release_20261012/as7331/jlc/placement-bottom.png
