Stratolink-hq/Stratolink/analysis/v1_1_release_20261012/as7331/review/candidate-uv-schematic.png

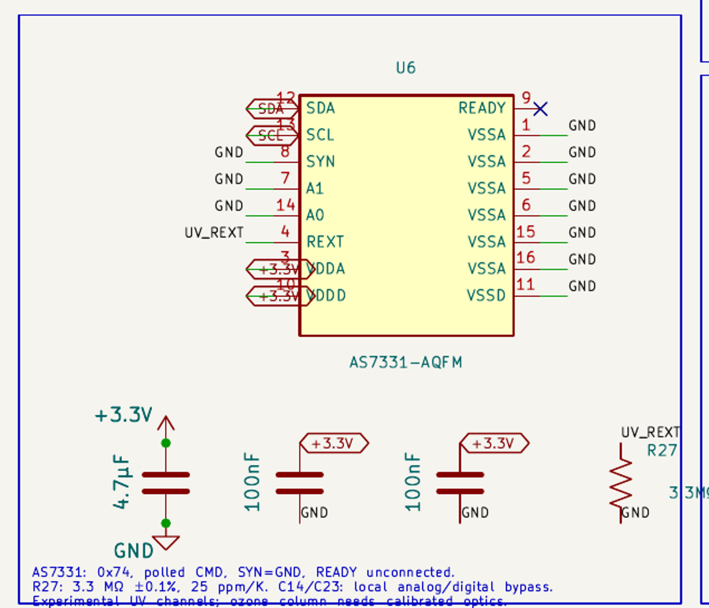
analysis/v1_1_release_20261012/as7331/review/candidate-uv-schematic.png
