Stratolink-hq/Stratolink/analysis/v1_1_release_20261012/canonical-native-3d.jpg

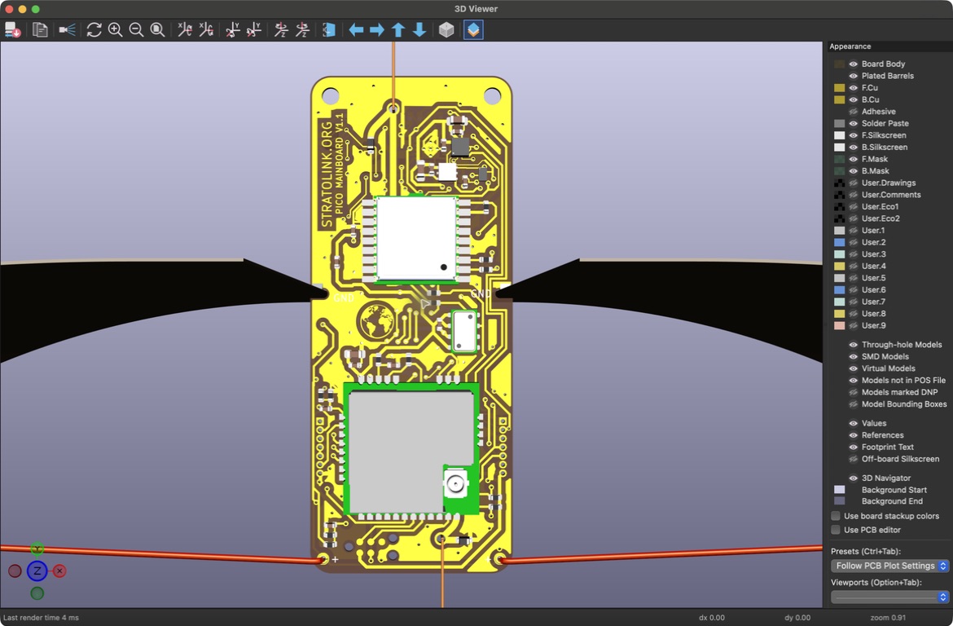
analysis/v1_1_release_20261012/canonical-native-3d.jpg
