Stratolink-hq/Stratolink/analysis/v1_1_release_20261012/headers/header-back-before-after.png

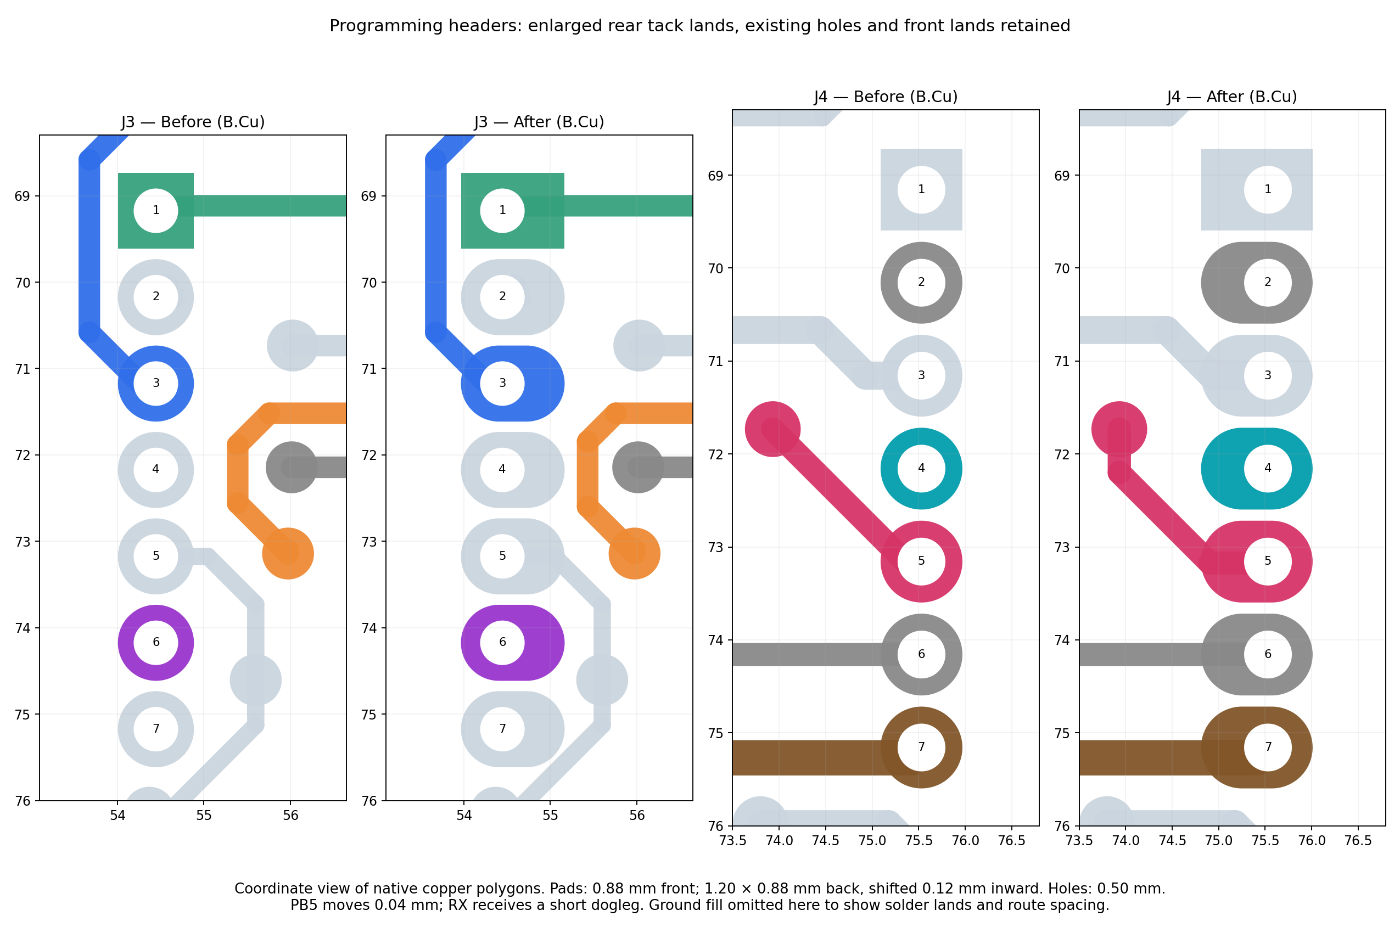
analysis/v1_1_release_20261012/headers/header-back-before-after.png
