Stratolink-hq/Stratolink/analysis/v1_1_release_20261012/identities/balance-placement-model-review.png

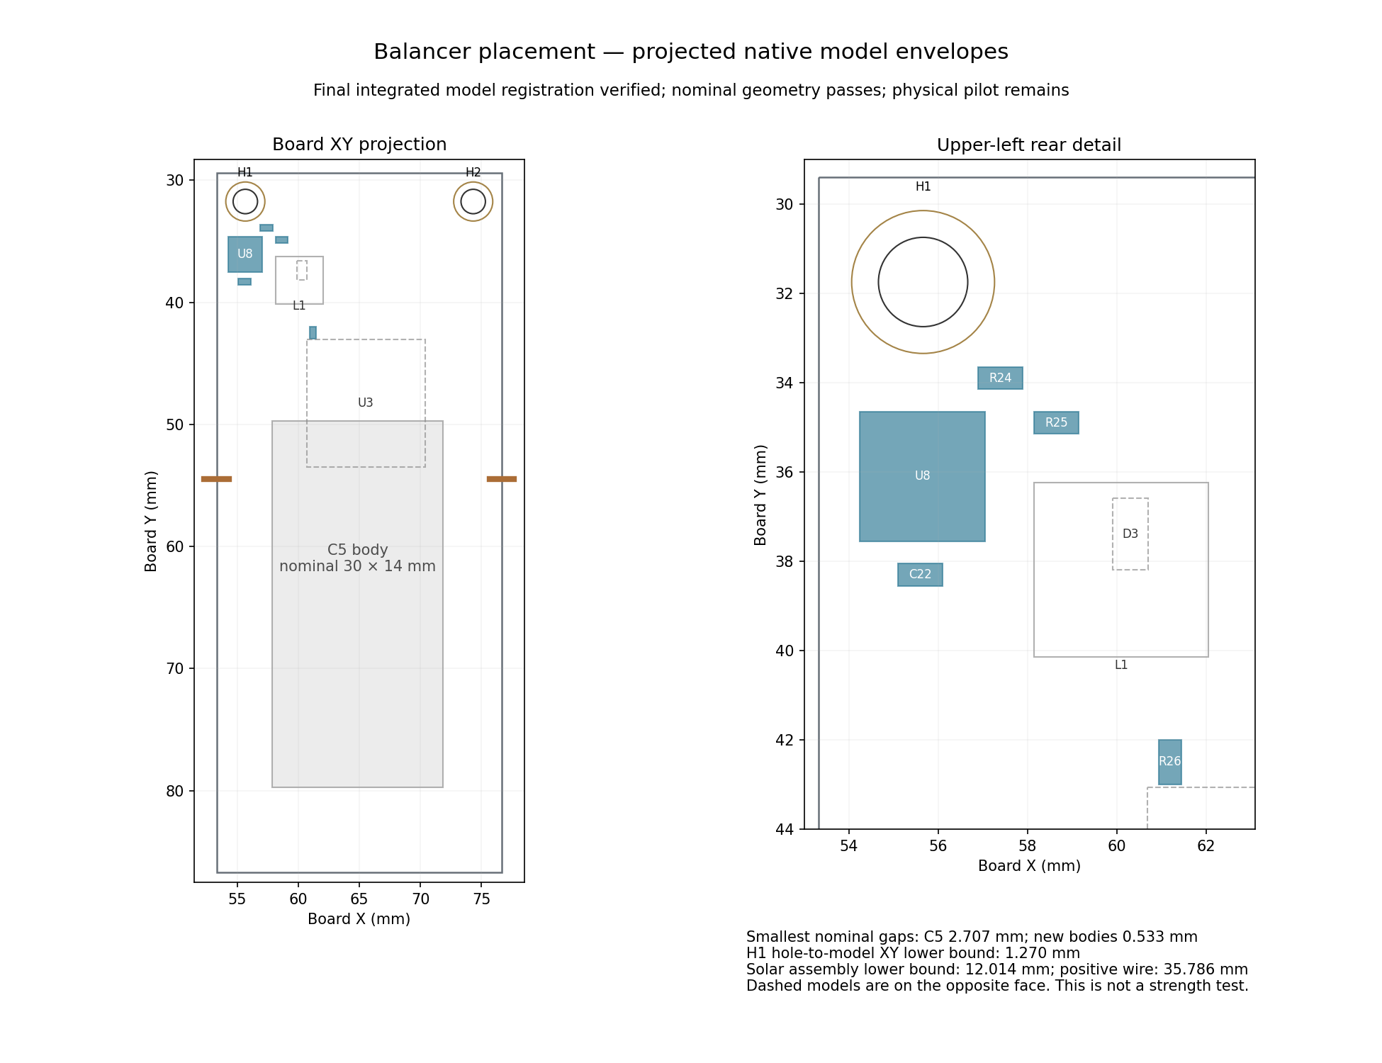
analysis/v1_1_release_20261012/identities/balance-placement-model-review.png
