Stratolink-hq/Stratolink/analysis/v1_1_release_20261012/identities/u7-before-after.png

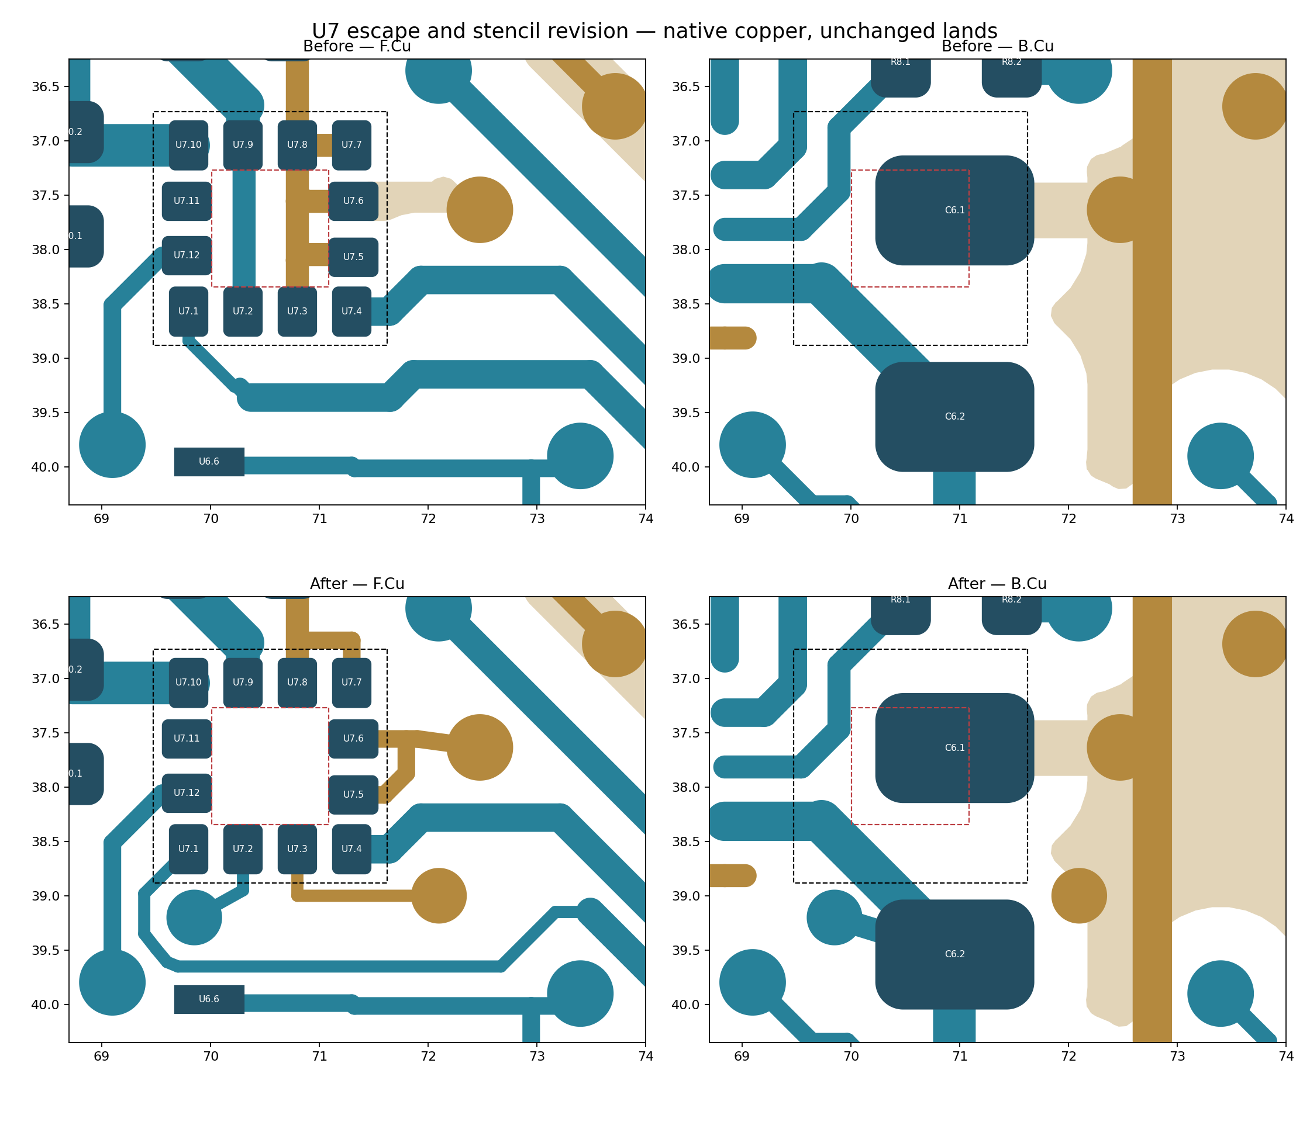
analysis/v1_1_release_20261012/identities/u7-before-after.png
