Stratolink-hq/Stratolink/analysis/v1_1_release_20261012/jlc/final-u3-180-full.png

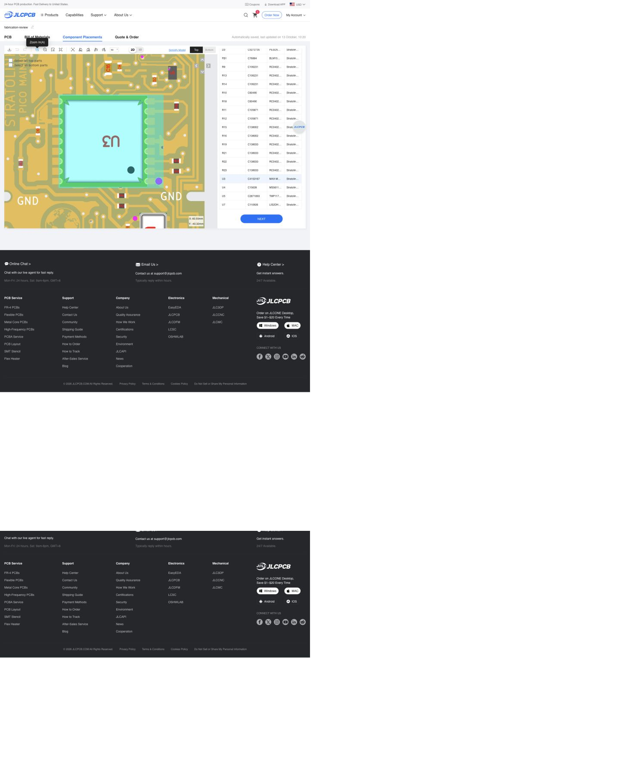
analysis/v1_1_release_20261012/jlc/final-u3-180-full.png
