Stratolink-hq/Stratolink/analysis/v1_1_release_20261012/jlc/placement-u1-crop.png

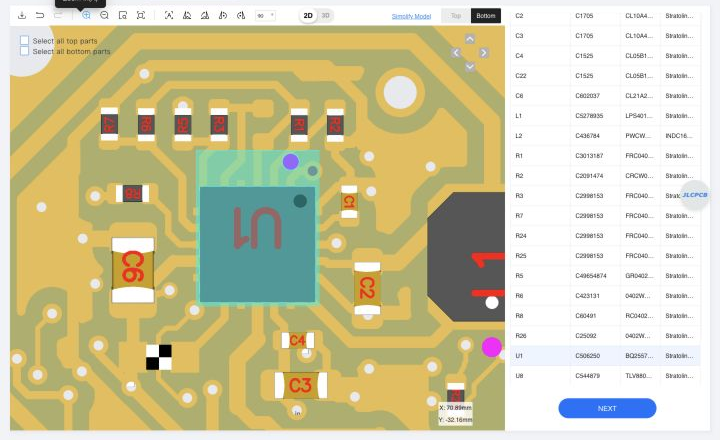
analysis/v1_1_release_20261012/jlc/placement-u1-crop.png
