Stratolink-hq/Stratolink/analysis/v1_1_release_20261012/jlc/placement-u7.png

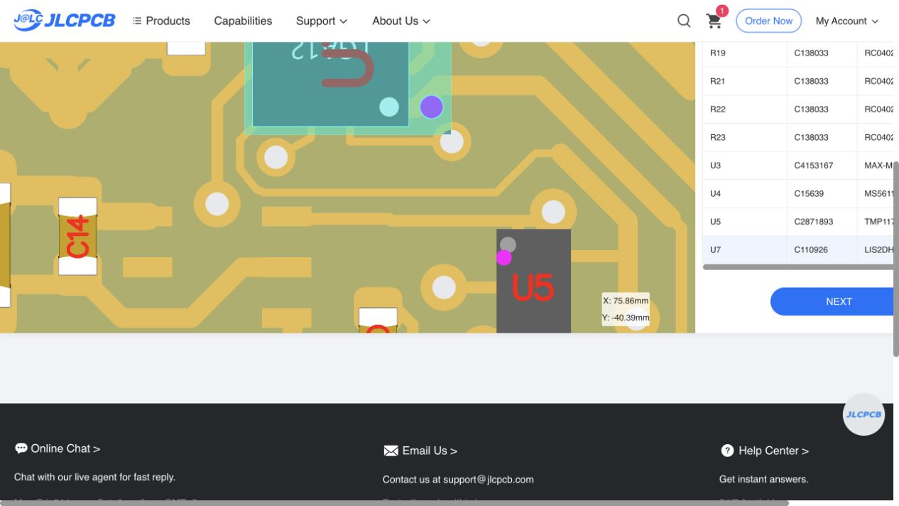
analysis/v1_1_release_20261012/jlc/placement-u7.png
