Stratolink-hq/Stratolink/analysis/v1_1_release_20261012/jlc/probe-u8-90-crop.png

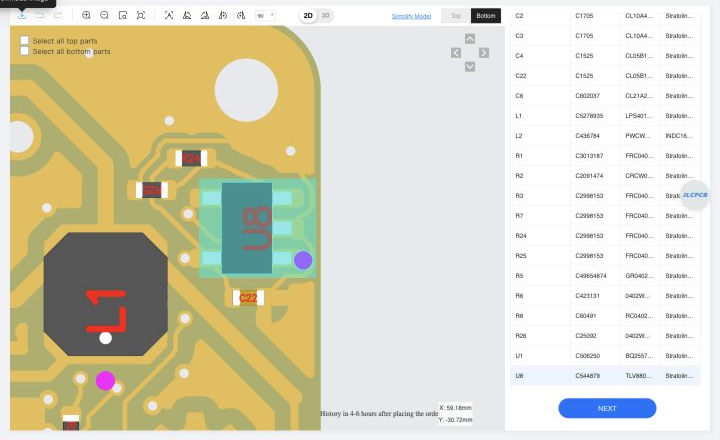
analysis/v1_1_release_20261012/jlc/probe-u8-90-crop.png
