Stratolink-hq/Stratolink/analysis/v1_1_resubmit_20261108/layout/r11-before-after.png

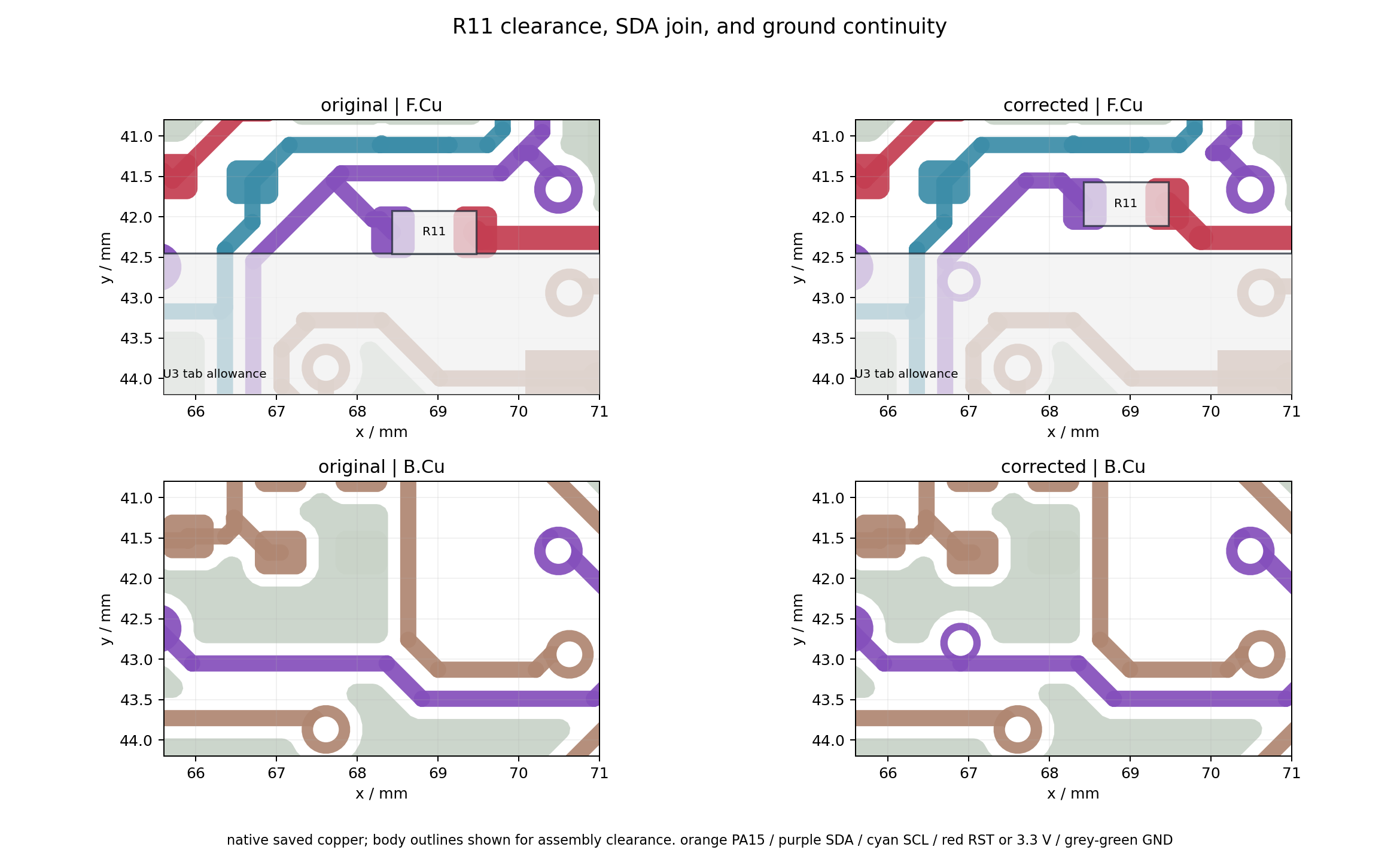
analysis/v1_1_resubmit_20261108/layout/r11-before-after.png
