Stratolink-hq/Stratolink/analysis/v1_1_resubmit_20261108/layout/u2-before-after.png

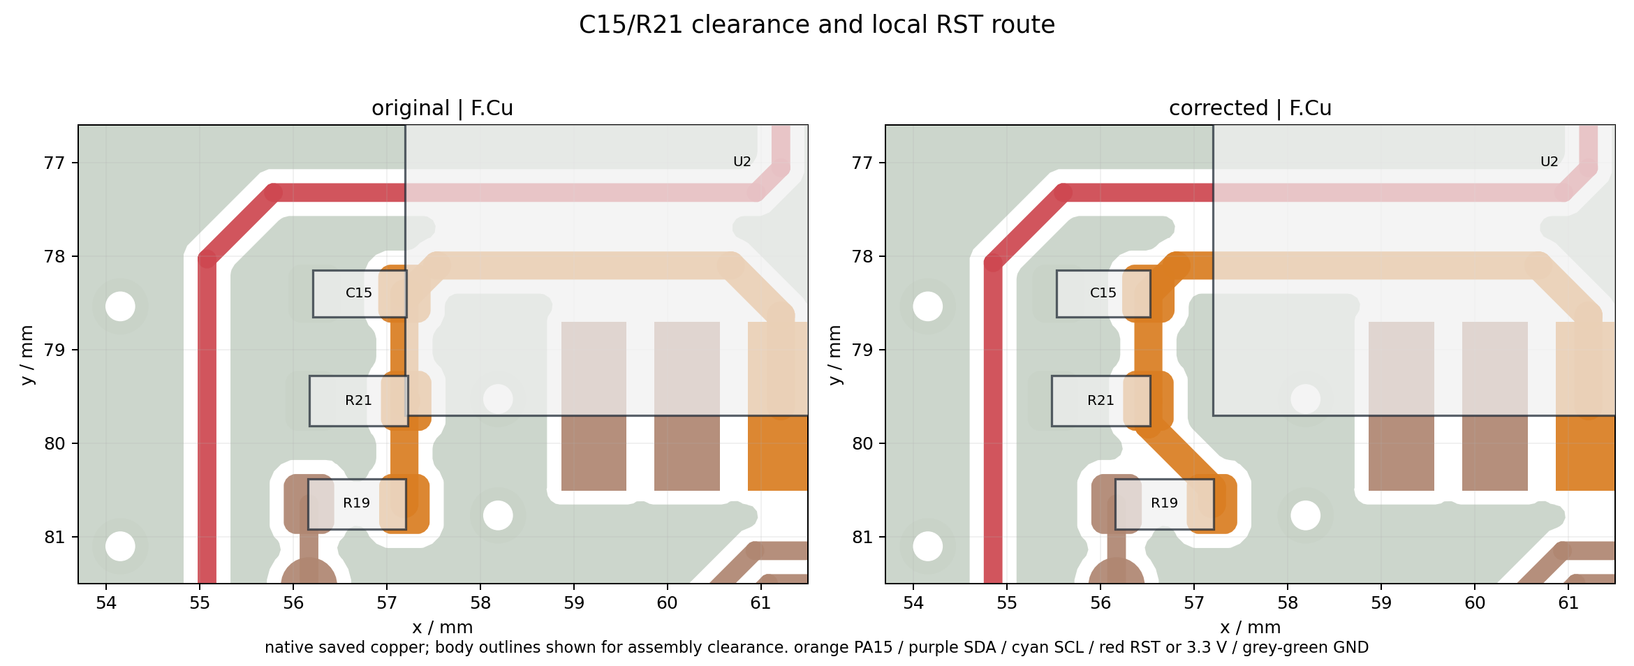
analysis/v1_1_resubmit_20261108/layout/u2-before-after.png
