Stratolink-hq/Stratolink/analysis/v1_1_solar_attachments_20261012/front-3d.png

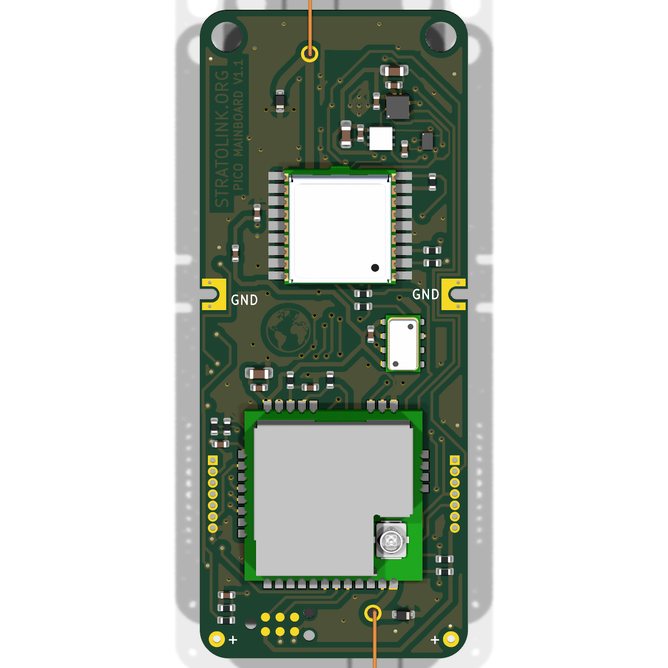
analysis/v1_1_solar_attachments_20261012/front-3d.png
