Stratolink-hq/Stratolink/analysis/v1_1_solar_attachments_20261012/layout/candidate_layout.png

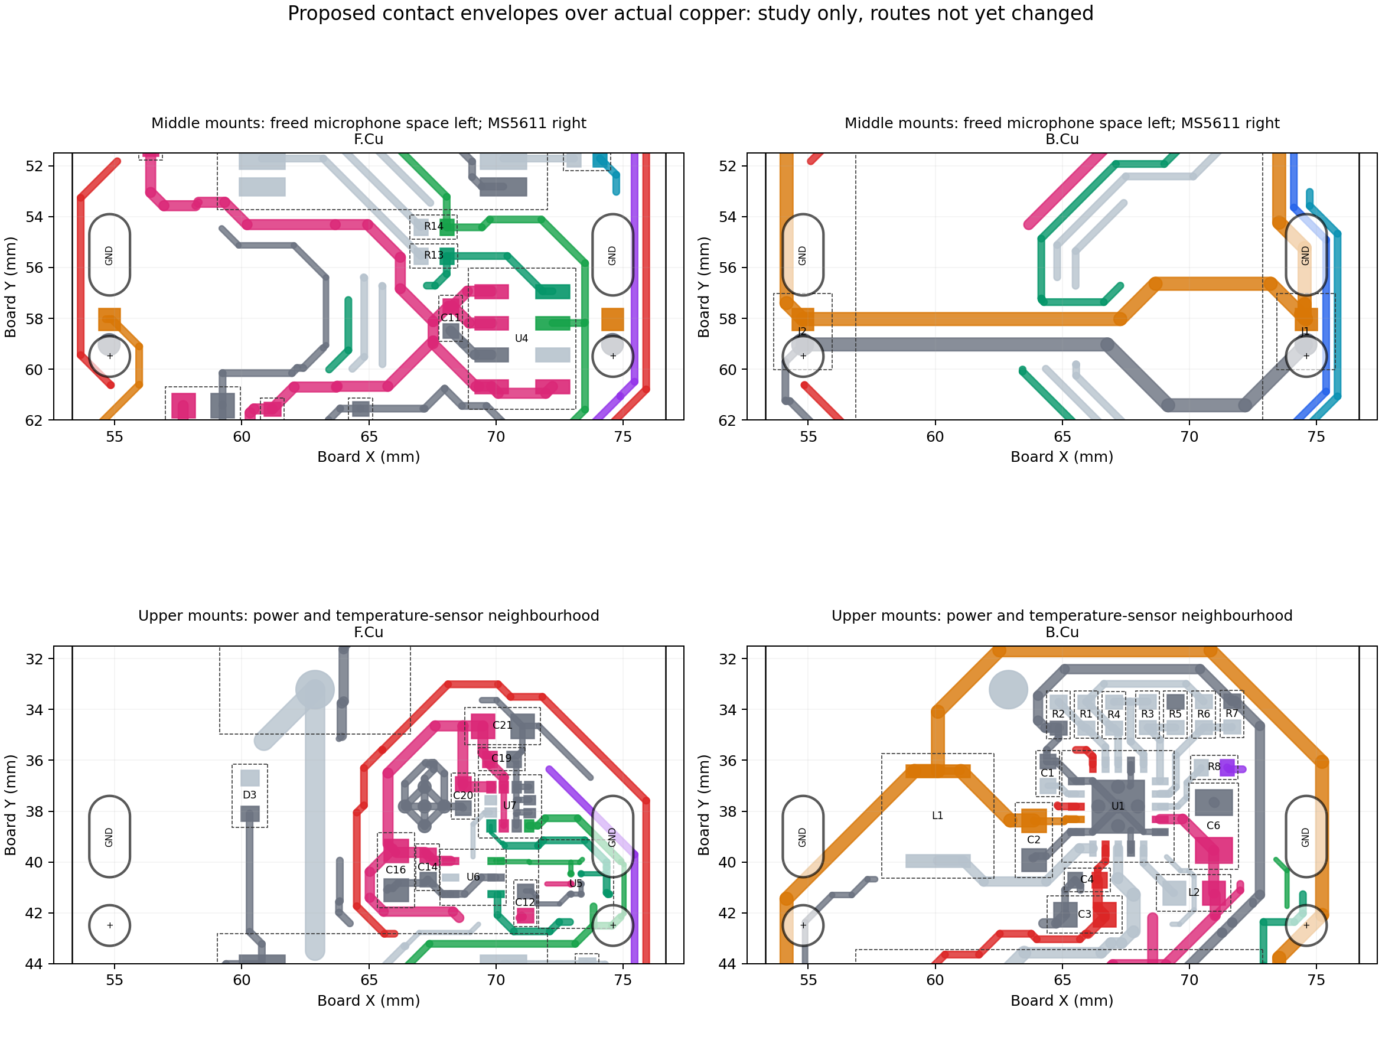
analysis/v1_1_solar_attachments_20261012/layout/candidate_layout.png
