Stratolink-hq/Stratolink/analysis/v1_1_solar_attachments_20261012/layout/open_notch_layout.png

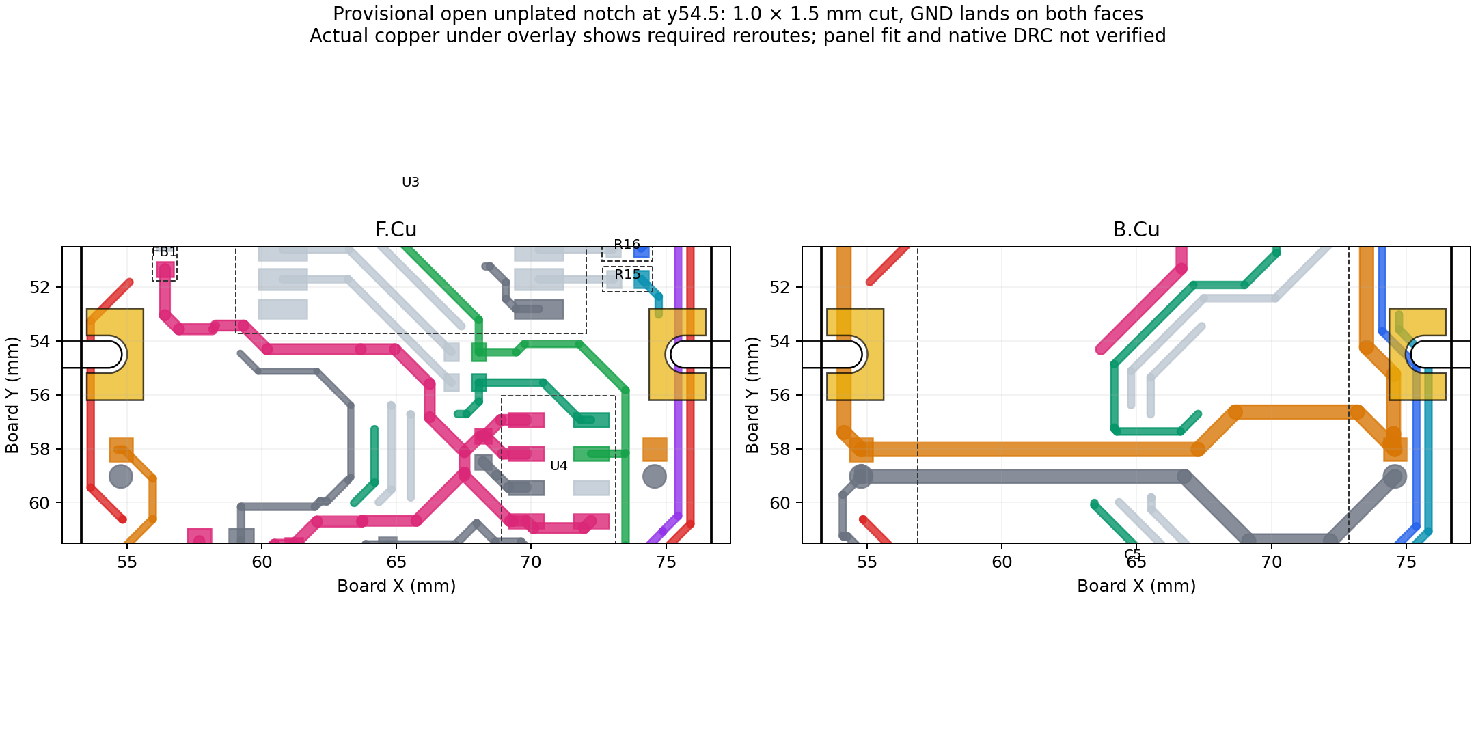
analysis/v1_1_solar_attachments_20261012/layout/open_notch_layout.png
