Stratolink-hq/Stratolink/analysis/v1_1_solar_attachments_20261012/qualification/layout/deeper_notches.png

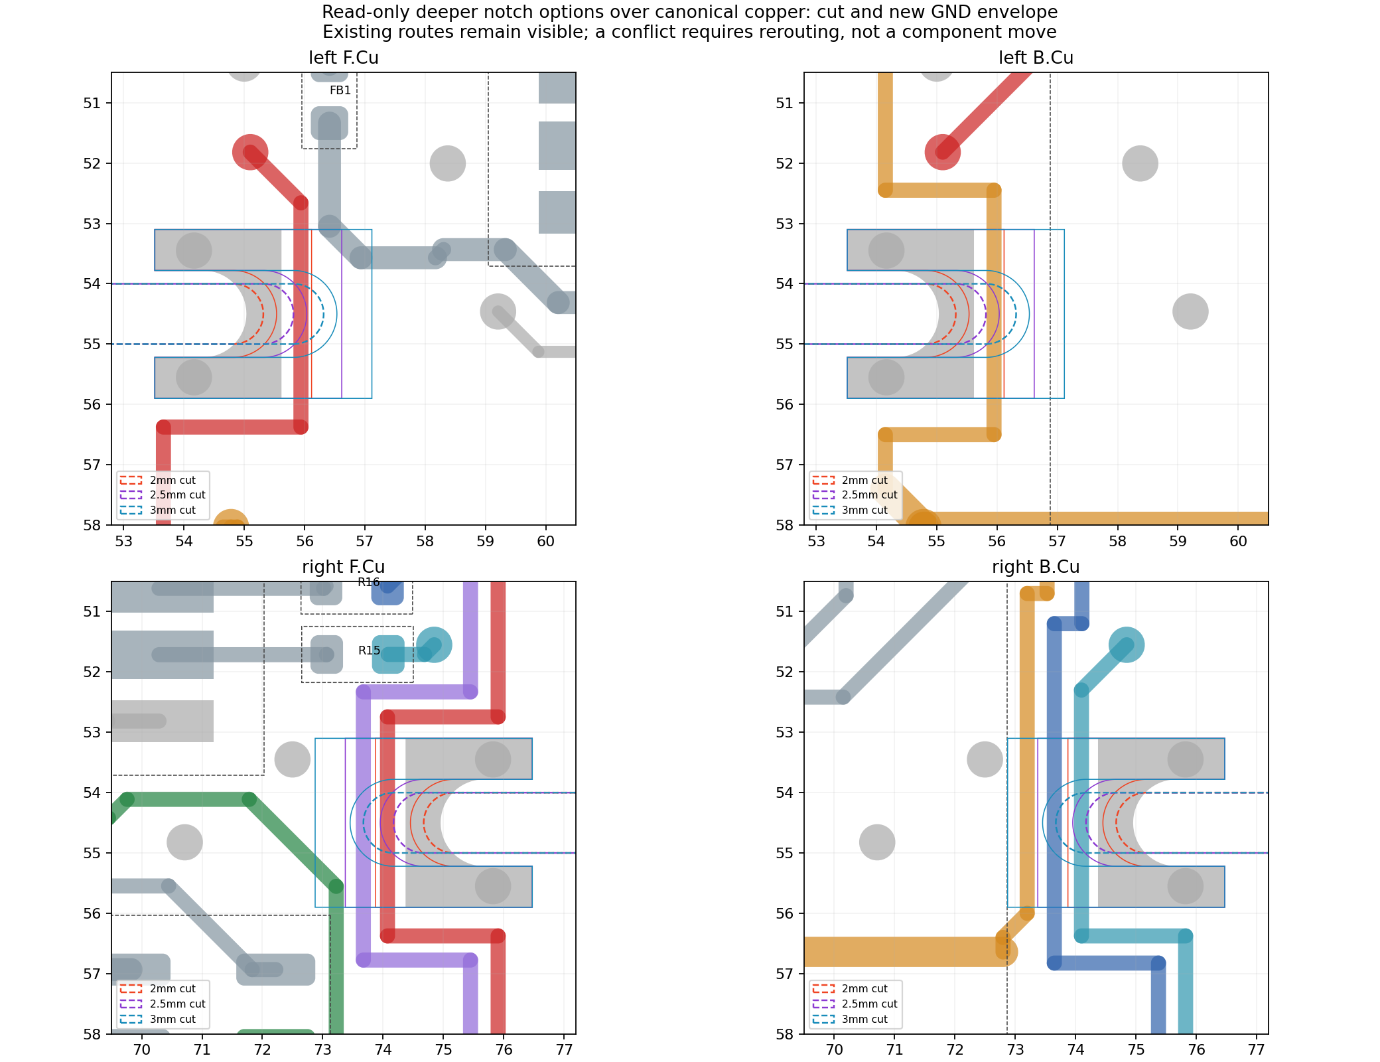
analysis/v1_1_solar_attachments_20261012/qualification/layout/deeper_notches.png
