Stratolink-hq/Stratolink/analysis/v1_1_solar_attachments_20261012/qualification/metrology/bottom_detail.png

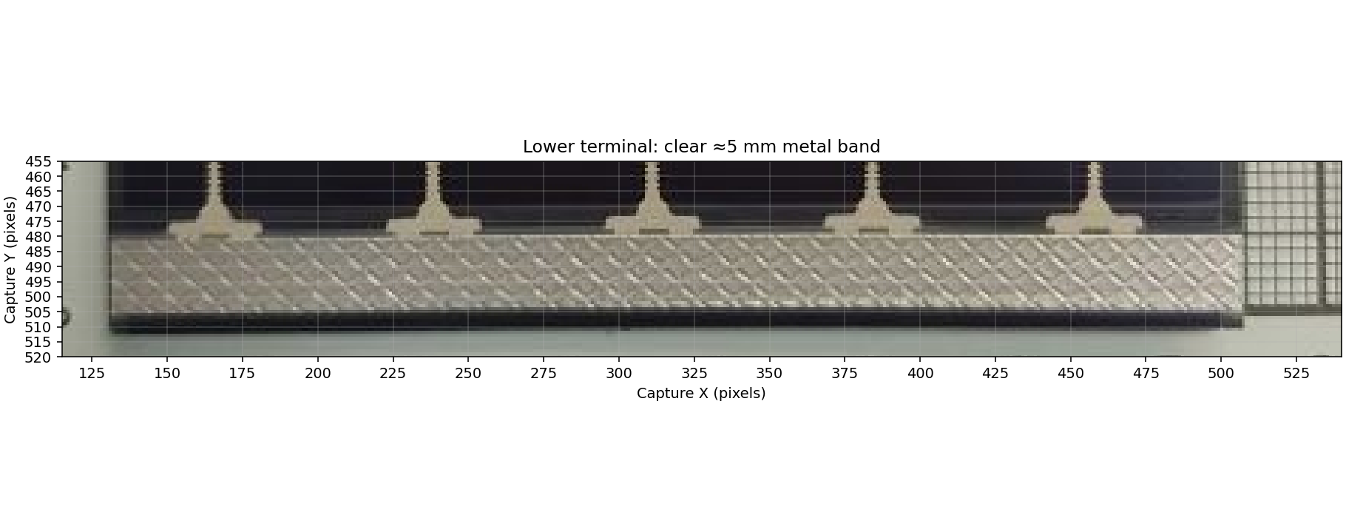
analysis/v1_1_solar_attachments_20261012/qualification/metrology/bottom_detail.png
