Stratolink-hq/Stratolink/analysis/v1_1_solar_attachments_20261012/qualification/sources/zachtek-metric-photo-browser.png

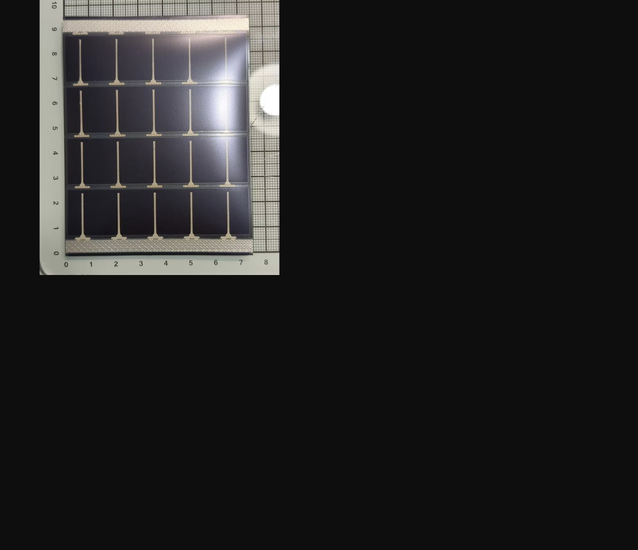
analysis/v1_1_solar_attachments_20261012/qualification/sources/zachtek-metric-photo-browser.png
