Stratolink-hq/Stratolink/analysis/v1_1_solar_attachments_20261012/qualification/views/ground-joint-detail.png

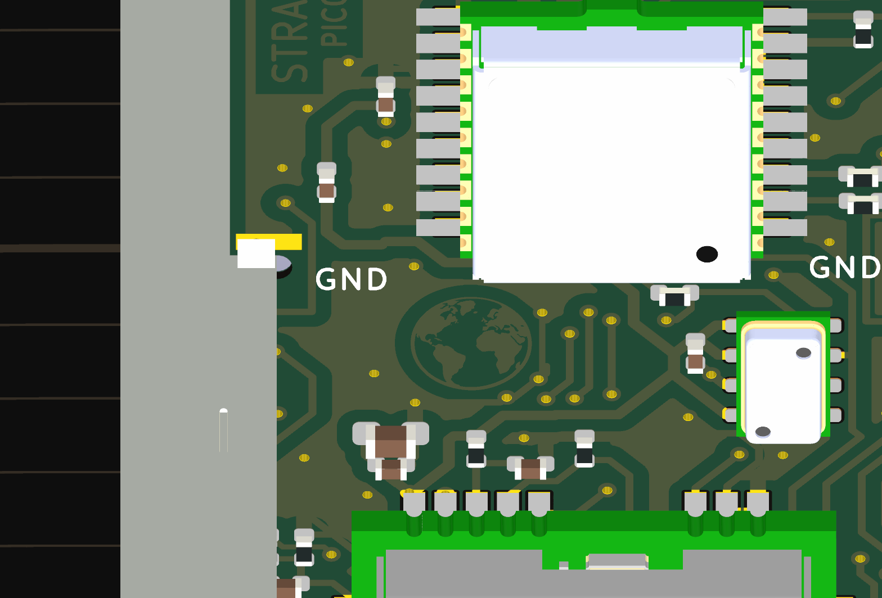
analysis/v1_1_solar_attachments_20261012/qualification/views/ground-joint-detail.png
