Stratolink-hq/Stratolink/analysis/v1_1_release_20261012/as7331/sourcing/README.md

# AS7331 circuit sourcing — 2026-10-13

U6 is AS7331-AQFM, catalog C20482877 (vendor title `AS7331-AQFM OLGA16 LF T&R`). The [live LCSC listing](https://www.lcsc.com/product-detail/C20482877.html) remained out of stock; its $13.3535 one-piece price is a reference, not an available allocation. The primary sensor datasheet's −40…85 °C operating range supersedes the listing's inconsistent +105 °C metadata. Prior direct LCSC/JLC alias coverage is recorded in [the UV review](../../uv_followup/README.md).

R27 is **Vishay MCU0805MD3304BP500, C4313228**: 3.3 MΩ, ±0.1%, ±25 ppm/K, 0805 thin film. [LCSC global](https://www.lcsc.com/product-detail/C4313228.html) showed **30 in stock**, $0.5135 at one and $0.3987 at ten. [LCSC China](https://item.szlcsc.com/4883673.html) independently showed 30 and a link labeled 95 JLC inventory. The actual JLC component-search dialog independently confirmed **95 units** of exact C4313228, with $0.3964 at ten; this is search stock, not a reserved allocation. [JLC exact part](https://jlcpcb.com/partdetail/VishayIntertech-MCU0805MD3304BP500/C4313228). [DigiKey](https://www.digikey.com/en/products/detail/vishay/MCU0805MD3304BP500/15792276) showed 8,311 in stock and $0.31 at one. These are observed stocks/prices, not reserved parts or delivery promises.

The independent reviewer checked [Vishay doc 28952](https://www.vishay.com/docs/28952/mcr0201at-mca1206at.pdf), Rev. 28-May-2026: the order code explicitly decodes D=25 ppm/K, B=0.1%, 3304=3.3 MΩ, and the MCU0805 precision range extends to 7.5 MΩ. A 0603 substitution is not justified by this table (2 MΩ limit). The primary dimensions-and-mass table lists **4.6 mg** for the MCU0805 body (solder excluded), so this reference adds about 0.0046 g before its solder and routing. No inspected primary AS7331 package mass is available; do not present a total new-circuit mass as measured. This meets AS7331's 3.3 MΩ ±1%, at most 50 ppm/K requirement. An ordinary 100 ppm/K thick-film substitution does not. Captures and primary review are retained alongside this file and under `../review/`.

C14 and new C23 use the existing **Samsung CL05B104KO5NNNC C1525**, 100 nF, X7R, 16 V, 0402. Supply qualification and local bypass geometry are part of the circuit review.

User decision: keep the complete AS7331 circuit in canonical CAD. For the initial pilot, intentionally omit **U6 only** if still unavailable, populate its support resistor and bypass capacitors if available, and use firmware environment `stratolink_v1_1_uv_dnp`. That pilot produces no UV or ozone measurements. Later fitting U6 requires its own validated driver, power-down behavior, optical calibration and reviewed assembly orientation. No component purchase was performed during this sourcing pass.
