Stratolink-hq/Stratolink/analysis/v1_1_uv_sourcing_20261016/jlc-inquiry-draft.md

# Draft JLC sourcing inquiry

Not sent. No purchase or shipment authorization is included.

Subject: AS7331 sourcing and assembly quote for three boards

We would like to fit one ams OSRAM AS7331 UV sensor on each of three boards using your Standard PCBA service. Our PCB already has the OLGA16 footprint and supporting circuit. The current draft omits U6 while we resolve sourcing.

Preferred part: AS7331-AQFM, manufacturer ordering code Q65114A3064. AS7331-AQFT, Q65114A3065, is an acceptable alternative subject to confirming the exact orderable and assembly identity. Both use the manufacturer's OLGA16 package. We need genuine bare ICs in suitable tape and moisture-sensitive packaging, not evaluation boards.

On October 16, DigiKey listed both parts with zero stock and expected replenishment on November 9, 2026:

- https://www.digikey.com/en/products/detail/ams-osram-ag/AS7331-AQFM-OLGA16-LF-T-R/16983757
- https://www.digikey.com/en/products/detail/ams-osram-ag/AS7331-T-OLGA16-LF-T-RDP/16983752

Your Global Sourcing portal returned no exact bare-part offer for either code. Could you quote procurement through an authorized supplier and confirm:

1. Quantity required for three placements, including attrition, minimum assembly quantity and purchasing minimum. Five pieces is our initial budgeting example; please specify if more are needed.
2. Component subtotal, sourcing/import/handling fees, any deposits, inbound freight and incremental PCBA charges. Please distinguish refundable deposits from final costs.
3. Actual availability and estimated arrival at JLC, including whether the November 9 distributor replenishment can be allocated. Please identify the supplier and exact part number.
4. Accepted cut-tape or reel format, any leader requirement, moisture handling and optical-package assembly requirements. AS7331 is MSL3; its datasheet specifies a 50°C, 12-hour rebake if required.
5. If direct Global Sourcing is unavailable, the approved consignment procedure and applicable fees. Your overseas guide lists 2% handling with a $10 minimum, while the consignment terms list $70 plus $15. Which schedule applies to one AS7331 part type shipped from outside mainland China?

We will provide an updated populated BOM, placement file and stencil package after sourcing is confirmed. Please treat this as a quotation request only, with no order, payment or shipment authorized.
