Stratolink-hq/Stratolink/analysis/v1_1_final_sweep_20261016/jlc/bom-saved-cart.txt

24
SMT
24-hour PCB production. Fast Delivery to United States.
 Coupons
 Download APP
USD 
JLCPCB
Products
Capabilities
Support 
About Us 
1
Order Now
My Account 
SHOPPING CART
All (1)
JLCPCB (1)
JLC3DP (0)
JLCCNC (0)
JLCMC (0)
Flex Heater (0)
Item
Qty
Build Time
Price
JLCPCB (PCB/PCBA/Stencil)
fabrication-review_Y25
PCB prototype:Y25-2680969A
Green, 0.4 Thickness, ENIG
Customer #: 
Product Details  Edit Order
5
24 hours

$70.63
 
fabrication-review_Y25
Standard PCBA: SMT026101663307-2680969A
Assemble Both Sides
Customer #: 
Product Details  
3

3 - 4 days

$262.00
Recommended Deals For You
Refresh
Hex Socket Screw - Full/Partial Thread, Standard Type (DIN 912/GB/T 70.1)
From $0.0103
Order Now
Split Aluminum Box - Flange, W190 x H72 x L150mm
From $8.3875
Order Now
SMT Stencil Printer
Order Now
SUMMARY
Merchandise Total
$0.00
Shipping Estimated
--
Subtotal
$0.00
Est. shipping date 
--
Order won't be shipped until all items are ready.
Weight
0kg
Order on JLCONE Desktop: Save $1–$20 Per Order
Secure Checkout
Add new item
Payment method may vary by country.
SSL ENCRYPTED PAYMENT
Online Chat >
Chat with our live agent for fast reply.
Mon-Fri: 24 hours, Sat: 9am-6pm, GMT+8
Email Us >
Contact us at supportjlcpcb.com
Typically reply within hours.
Help Center >
Get instant answers.
24/7 Available.
PCB Service
FR-4 PCBs
Flexible PCBs
Metal Core PCBs
High-Frequency PCBs
PCBA Service
PCB Layout
SMT Stencil
Flex Heater
Support
Help Center
Contact Us
Community
Shipping Guide
Payment Methods
How to Order
How to Track
After-Sales Service
Blog
Company
About Us
Quality Assurance
How We Work
Certifications
Security
Environment
JLCAPI
News
Cooperation
Electronics
EasyEDA
JLCPCB
JLCDFM
LCSC
OSHWLAB
Mechanical
JLC3DP
JLCCNC
JLCMC
Order on JLCONE Desktop, Save $1–$20 Every Time
Windows
MAC
Android
IOS
CONNECT WITH US
© 2026 JLCPCB.COM All Rights Reserved.
Privacy Policy
Terms & Conditions
Cookies Policy
Do Not Sell or Share My Personal Information
Product Detail
PCBA Parameters
Bill of Material
Part Placement
Selected Parts(30 items) 
Download Selected Parts List
Part Detail	Selected by	Top Designator	Bottom Designator	Qty	Source	Ext. Price

RC0402FR-07100KL
Extended C60491
	System	
	
R8
	20	
JLCPCB
$0.0460 

RAK3172-8-SM-NI
Extended C5452091
	System	
U2
	
	3	
JLCPCB
$23.7372

BLM15AG601SN1D
Extended C76884
	System	
FB1
	
	20	
JLCPCB
$0.1800 

RC0402FR-073M65L
Extended C477700
	System	
	
R4
	20	
JLCPCB
$0.0440 

PESD5V0U1BB
Extended C5272735
	System	
D3,D1,D3,D1
	
	10	
JLCPCB
$0.4120

LPS4018-223MRC
Extended C5278935
	System	
	
L1
	3	
JLCPCB
$3.5826

PWCWAQ1608F-100KTT
Extended C436784
	System	
	
L2
	7	
JLCPCB
$0.3920

RC0402FR-0710KL
Extended C60490
	System	
R18,R10,R18,R10
	
	20	
JLCPCB
$0.0460 

RC0402FR-0733RL
Extended C138002
	System	
R16,R15,R16,R15
	
	20	
JLCPCB
$0.0680 

GRM1555C1E103JE01D
Extended C3855387
	System	
	
C1
	7	
JLCPCB
$0.5383

CL21A226MAYNNNE
Extended C602037
	System	
	
C6
	20	
JLCPCB
$3.1260 

CL10A106KP8NNNC
Basic C19702
	System	
C8,C21,C8,C21
	
	20	
JLCPCB
$0.5680 

FRC0402F7504TS
Extended C3013187
	System	
	
R1
	20	
JLCPCB
$0.0200 

TLV8801DBVT
Extended C544879
	System	
U8
	
	3	
JLCPCB
$1.0524

LIS2DH12TR
Extended C110926
	System	
U7
	
	3	
JLCPCB
$2.7900

CRCW04024M22FKED
Extended C2091474
	System	
	
R2
	20	
JLCPCB
$0.5000 

0402WGF8254TCE
Extended C423131
	System	
	
R6
	20	
JLCPCB
$0.0120 

RC0402FR-074K7L
Extended C105871
	System	
R11,R12,R11,R12
	
	20	
JLCPCB
$0.0580 

CL10A475KP8NNNC
Extended C1705
	System	
C16
	
C3,C2,C3,C2
	40	
JLCPCB
$0.2640 

MS561101BA03-50
Extended C15639
	System	
U4
	
	3	
JLCPCB
$20.1840

TMP117AIYBGR
Extended C2871893
	System	
U5
	
	3	
JLCPCB
$6.9795

CL05B104KO5NNNC
Basic C1525
	System	
C11,C7,C19,C15,...
	
C4
	66	
JLCPCB
$0.0780 

RC0402FR-071ML
Extended C138033
	System	
R19,R23,R21,R22...
	
	22	
JLCPCB
$0.0660

BQ25570RGRR
Extended C506250
	System	
	
U1
	3	
JLCPCB
$17.5068

0402WGF220JTCE
Basic C25092
	System	
R26
	
	20	
JLCPCB
$0.0300 

FRC0402F4754TS
Extended C2998153
	System	
R24,R25,R24,R25
	
R7,R3,R7,R3
	40	
JLCPCB
$0.0320 

MAX-M10S-00B
Extended C4153167
	System	
U3
	
	3	
JLCPCB
$32.5275

MCU0805MD3304BP500
Extended C4313228
	System	
R27
	
	5	
JLCPCB
$2.5535

GR0402F4M42TAG00
Extended C49654874
	System	
	
R5
	20	
JLCPCB
$0.0180 

RC0402FR-070RL
Extended C106231
	System	
R9,R13,R14,R9,R...
	
	20	
JLCPCB
$0.0360 

Show Less 
Unselected Parts
Designator	Comment	Footprint	Reason	Qty
No data
