Stratolink-hq/Stratolink/analysis/v1_1_release_20261012/as7331/jlc/matched-parts-selection.txt

- text: 
- banner:
  - generic: 24-hour PCB production. Fast Delivery to United States.
  - link " Coupons":
    - /url: https://jlcpcb.com/coupon-center
    - generic: 
    - text: Coupons
  - link " Download APP":
    - /url: https://jlcone.com/download
    - generic: 
    - text: Download APP
  - text:     
  - text: USD
  - generic: 
- navigation:
  - text: 
  - link "JLCPCB logo":
    - /url: https://jlcpcb.com
    - generic: 
    - generic: JLCPCB
  - text: 
  - generic: 
  - text: Products
  - link "Capabilities":
    - /url: https://jlcpcb.com/capabilities/pcb-capabilities
  - text:   
  - text: Support
  - generic: 
  - text: About Us
  - generic: 
  - generic: 
  - link "":
    - /url: https://cart.jlcpcb.com/shopcart/cart
    - generic: 
  - superscript: "1"
  - link "Order Now":
    - /url: https://cart.jlcpcb.com/quote?spm=Jlcpcb.Homepage.1006&spm=Jlcpcb.Homepage.1006
  - text: 
  - text: My Account
  - generic: 
  - text: 
- main:
  - generic: fabrication-review
  - generic: Automatically saved, last updated on 13 October, 13:20
  - tablist:
    - tab "PCB":
      - generic: PCB
    - tab "Bill of Materials" [selected]:
      - generic: Bill of Materials
    - tab "Component Placements":
      - generic: Component Placements
    - tab "Quote & Order":
      - generic: Quote & Order
  - tabpanel "Bill of Materials":
    - navigation:
      - heading "Both Sides" [level=3]
      - list:
        - text: Total
        - generic: "57"
        - text: parts detected
        - generic: "57"
        - text: Parts confirmed
    - text: Complete File
    - generic: 
    - button "Upload BOM/CPL":
      - text: Upload BOM/CPL
    - text: 
    - table:
      - rowgroup:
        - row "Uploaded BOM Data Review Matched Parts":
          - columnheader "Uploaded BOM Data":
            - generic: Uploaded BOM Data
          - columnheader "Review Matched Parts":
            - generic: Review Matched Parts
          - columnheader
        - row "Top Designator Bottom Designator Comment Footprint Matched Part Detail Qty Source Lib Type Total Cost Select ":
          - columnheader "Top Designator":
            - generic: Top Designator
          - columnheader "Bottom Designator":
            - generic: Bottom Designator
          - columnheader "Comment":
            - generic: Comment
          - columnheader "Footprint":
            - generic: Footprint
          - columnheader "Matched Part Detail":
            - generic: Matched Part Detail
          - columnheader "Qty":
            - generic: Qty
          - columnheader "Source":
            - generic: Source
          - columnheader "Lib Type":
            - generic: Lib Type
          - columnheader "Total Cost":
            - generic: Total Cost
          - columnheader "Select ":
            - checkbox [checked] [active]
            - text: Select
            - generic: 
          - columnheader
    - table:
      - rowgroup:
        - row "C1 GRM1555C1E103JE01D Stratolink_v1p1_C1_C_0402_1005Metric GRM1555C1E103JE01D C3855387 10nF 25V C0G ±5% 0402 Multilayer Ceramic Capacitors MLCC - SMD/SMT ROHS 7  JLCPCB Extended $0.5747":
          - cell
          - cell "C1":
            - generic: C1
          - cell "GRM1555C1E103JE01D":
            - generic: GRM1555C1E103JE01D
          - cell "Stratolink_v1p1_C1_C_0402_1005Metric":
            - generic: Stratolink_v1p1_C1_C_0402_1005Metric
          - cell "GRM1555C1E103JE01D C3855387 10nF 25V C0G ±5% 0402 Multilayer Ceramic Capacitors MLCC - SMD/SMT ROHS":
            - generic: GRM1555C1E103JE01D
            - generic: C3855387
            - generic: 10nF 25V C0G ±5% 0402 Multilayer Ceramic Capacitors MLCC - SMD/SMT ROHS
          - cell "7 ":
            - generic: "7"
            - generic: 
          - cell "JLCPCB":
            - generic: JLCPCB
          - cell "Extended":
            - generic: Extended
          - cell "$0.5747":
            - generic: $0.5747
          - cell:
            - checkbox [checked]
        - row "C2 CL10A475KP8NNNC Stratolink_v1p1_C2_C_0603_1608Metric CL10A475KP8NNNC C1705 10V 4.7uF X5R ±10% 0603 Multilayer Ceramic Capacitors MLCC - SMD/SMT ROHS 40  JLCPCB Extended $0.5240 ":
          - cell
          - cell "C2":
            - generic: C2
          - cell "CL10A475KP8NNNC":
            - generic: CL10A475KP8NNNC
          - cell "Stratolink_v1p1_C2_C_0603_1608Metric":
            - generic: Stratolink_v1p1_C2_C_0603_1608Metric
          - cell "CL10A475KP8NNNC C1705 10V 4.7uF X5R ±10% 0603 Multilayer Ceramic Capacitors MLCC - SMD/SMT ROHS":
            - generic: CL10A475KP8NNNC
            - generic: C1705
            - generic: 10V 4.7uF X5R ±10% 0603 Multilayer Ceramic Capacitors MLCC - SMD/SMT ROHS
          - cell "40 ":
            - generic: "40"
            - generic: 
          - cell "JLCPCB":
            - generic: JLCPCB
          - cell "Extended":
            - generic: Extended
          - cell "$0.5240":
            - generic: $0.5240
          - cell "":
            - checkbox [checked]
            - generic: 
        - row "C3 CL10A475KP8NNNC Stratolink_v1p1_C3_C_0603_1608Metric CL10A475KP8NNNC C1705 10V 4.7uF X5R ±10% 0603 Multilayer Ceramic Capacitors MLCC - SMD/SMT ROHS ":
          - cell
          - cell "C3":
            - generic: C3
          - cell "CL10A475KP8NNNC":
            - generic: CL10A475KP8NNNC
          - cell "Stratolink_v1p1_C3_C_0603_1608Metric":
            - generic: Stratolink_v1p1_C3_C_0603_1608Metric
          - cell "CL10A475KP8NNNC C1705 10V 4.7uF X5R ±10% 0603 Multilayer Ceramic Capacitors MLCC - SMD/SMT ROHS":
            - generic: CL10A475KP8NNNC
            - generic: C1705
            - generic: 10V 4.7uF X5R ±10% 0603 Multilayer Ceramic Capacitors MLCC - SMD/SMT ROHS
          - cell "":
            - checkbox [checked]
            - generic: 
        - row "C16 CL10A475KP8NNNC Stratolink_v1p1_C16_C_0603_1608Metric CL10A475KP8NNNC C1705 10V 4.7uF X5R ±10% 0603 Multilayer Ceramic Capacitors MLCC - SMD/SMT ROHS ":
          - cell "C16":
            - generic: C16
          - cell
          - cell "CL10A475KP8NNNC":
            - generic: CL10A475KP8NNNC
          - cell "Stratolink_v1p1_C16_C_0603_1608Metric":
            - generic: Stratolink_v1p1_C16_C_0603_1608Metric
          - cell "CL10A475KP8NNNC C1705 10V 4.7uF X5R ±10% 0603 Multilayer Ceramic Capacitors MLCC - SMD/SMT ROHS":
            - generic: CL10A475KP8NNNC
            - generic: C1705
            - generic: 10V 4.7uF X5R ±10% 0603 Multilayer Ceramic Capacitors MLCC - SMD/SMT ROHS
          - cell "":
            - checkbox [checked]
            - generic: 
        - row "C4 CL05B104KO5NNNC Stratolink_v1p1_C4_C_0402_1005Metric CL05B104KO5NNNC C1525 100nF 16V X7R ±10% 0402 Multilayer Ceramic Capacitors MLCC - SMD/SMT ROHS 63  JLCPCB Basic $0.2898 ":
          - cell
          - cell "C4":
            - generic: C4
          - cell "CL05B104KO5NNNC":
            - generic: CL05B104KO5NNNC
          - cell "Stratolink_v1p1_C4_C_0402_1005Metric":
            - generic: Stratolink_v1p1_C4_C_0402_1005Metric
          - cell "CL05B104KO5NNNC C1525 100nF 16V X7R ±10% 0402 Multilayer Ceramic Capacitors MLCC - SMD/SMT ROHS":
            - generic: CL05B104KO5NNNC
            - generic: C1525
            - generic: 100nF 16V X7R ±10% 0402 Multilayer Ceramic Capacitors MLCC - SMD/SMT ROHS
          - cell "63 ":
            - generic: "63"
            - generic: 
          - cell "JLCPCB":
            - generic: JLCPCB
          - cell "Basic":
            - generic: Basic
          - cell "$0.2898":
            - generic: $0.2898
          - cell "":
            - checkbox [checked]
            - generic: 
        - row "C7 CL05B104KO5NNNC Stratolink_v1p1_C7_C_0402_1005Metric CL05B104KO5NNNC C1525 100nF 16V X7R ±10% 0402 Multilayer Ceramic Capacitors MLCC - SMD/SMT ROHS ":
          - cell "C7":
            - generic: C7
          - cell
          - cell "CL05B104KO5NNNC":
            - generic: CL05B104KO5NNNC
          - cell "Stratolink_v1p1_C7_C_0402_1005Metric":
            - generic: Stratolink_v1p1_C7_C_0402_1005Metric
          - cell "CL05B104KO5NNNC C1525 100nF 16V X7R ±10% 0402 Multilayer Ceramic Capacitors MLCC - SMD/SMT ROHS":
            - generic: CL05B104KO5NNNC
            - generic: C1525
            - generic: 100nF 16V X7R ±10% 0402 Multilayer Ceramic Capacitors MLCC - SMD/SMT ROHS
          - cell "":
            - checkbox [checked]
            - generic: 
        - row "C9 CL05B104KO5NNNC Stratolink_v1p1_C9_C_0402_1005Metric CL05B104KO5NNNC C1525 100nF 16V X7R ±10% 0402 Multilayer Ceramic Capacitors MLCC - SMD/SMT ROHS ":
          - cell "C9":
            - generic: C9
          - cell
          - cell "CL05B104KO5NNNC":
            - generic: CL05B104KO5NNNC
          - cell "Stratolink_v1p1_C9_C_0402_1005Metric":
            - generic: Stratolink_v1p1_C9_C_0402_1005Metric
          - cell "CL05B104KO5NNNC C1525 100nF 16V X7R ±10% 0402 Multilayer Ceramic Capacitors MLCC - SMD/SMT ROHS":
            - generic: CL05B104KO5NNNC
            - generic: C1525
            - generic: 100nF 16V X7R ±10% 0402 Multilayer Ceramic Capacitors MLCC - SMD/SMT ROHS
          - cell "":
            - checkbox [checked]
            - generic: 
        - row "C10 CL05B104KO5NNNC Stratolink_v1p1_C10_C_0402_1005Metric CL05B104KO5NNNC C1525 100nF 16V X7R ±10% 0402 Multilayer Ceramic Capacitors MLCC - SMD/SMT ROHS ":
          - cell "C10":
            - generic: C10
          - cell
          - cell "CL05B104KO5NNNC":
            - generic: CL05B104KO5NNNC
          - cell "Stratolink_v1p1_C10_C_0402_1005Metric":
            - generic: Stratolink_v1p1_C10_C_0402_1005Metric
          - cell "CL05B104KO5NNNC C1525 100nF 16V X7R ±10% 0402 Multilayer Ceramic Capacitors MLCC - SMD/SMT ROHS":
            - generic: CL05B104KO5NNNC
            - generic: C1525
            - generic: 100nF 16V X7R ±10% 0402 Multilayer Ceramic Capacitors MLCC - SMD/SMT ROHS
          - cell "":
            - checkbox [checked]
            - generic: 
        - row "C11 CL05B104KO5NNNC Stratolink_v1p1_C11_C_0402_1005Metric CL05B104KO5NNNC C1525 100nF 16V X7R ±10% 0402 Multilayer Ceramic Capacitors MLCC - SMD/SMT ROHS ":
          - cell "C11":
            - generic: C11
          - cell
          - cell "CL05B104KO5NNNC":
            - generic: CL05B104KO5NNNC
          - cell "Stratolink_v1p1_C11_C_0402_1005Metric":
            - generic: Stratolink_v1p1_C11_C_0402_1005Metric
          - cell "CL05B104KO5NNNC C1525 100nF 16V X7R ±10% 0402 Multilayer Ceramic Capacitors MLCC - SMD/SMT ROHS":
            - generic: CL05B104KO5NNNC
            - generic: C1525
            - generic: 100nF 16V X7R ±10% 0402 Multilayer Ceramic Capacitors MLCC - SMD/SMT ROHS
          - cell "":
            - checkbox [checked]
            - generic: 
        - row "C12 CL05B104KO5NNNC Stratolink_v1p1_C12_C_0402_1005Metric CL05B104KO5NNNC C1525 100nF 16V X7R ±10% 0402 Multilayer Ceramic Capacitors MLCC - SMD/SMT ROHS ":
          - cell "C12":
            - generic: C12
          - cell
          - cell "CL05B104KO5NNNC":
            - generic: CL05B104KO5NNNC
          - cell "Stratolink_v1p1_C12_C_0402_1005Metric":
            - generic: Stratolink_v1p1_C12_C_0402_1005Metric
          - cell "CL05B104KO5NNNC C1525 100nF 16V X7R ±10% 0402 Multilayer Ceramic Capacitors MLCC - SMD/SMT ROHS":
            - generic: CL05B104KO5NNNC
            - generic: C1525
            - generic: 100nF 16V X7R ±10% 0402 Multilayer Ceramic Capacitors MLCC - SMD/SMT ROHS
          - cell "":
            - checkbox [checked]
            - generic: 
        - row "C14 CL05B104KO5NNNC Stratolink_v1p1_C14_C_0402_1005Metric CL05B104KO5NNNC C1525 100nF 16V X7R ±10% 0402 Multilayer Ceramic Capacitors MLCC - SMD/SMT ROHS ":
          - cell "C14":
            - generic: C14
          - cell
          - cell "CL05B104KO5NNNC":
            - generic: CL05B104KO5NNNC
          - cell "Stratolink_v1p1_C14_C_0402_1005Metric":
            - generic: Stratolink_v1p1_C14_C_0402_1005Metric
          - cell "CL05B104KO5NNNC C1525 100nF 16V X7R ±10% 0402 Multilayer Ceramic Capacitors MLCC - SMD/SMT ROHS":
            - generic: CL05B104KO5NNNC
            - generic: C1525
            - generic: 100nF 16V X7R ±10% 0402 Multilayer Ceramic Capacitors MLCC - SMD/SMT ROHS
          - cell "":
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
