Stratolink-hq/Stratolink/analysis/v1_1_release_20261012/as7331/review/vishay-range-ordering-03.png

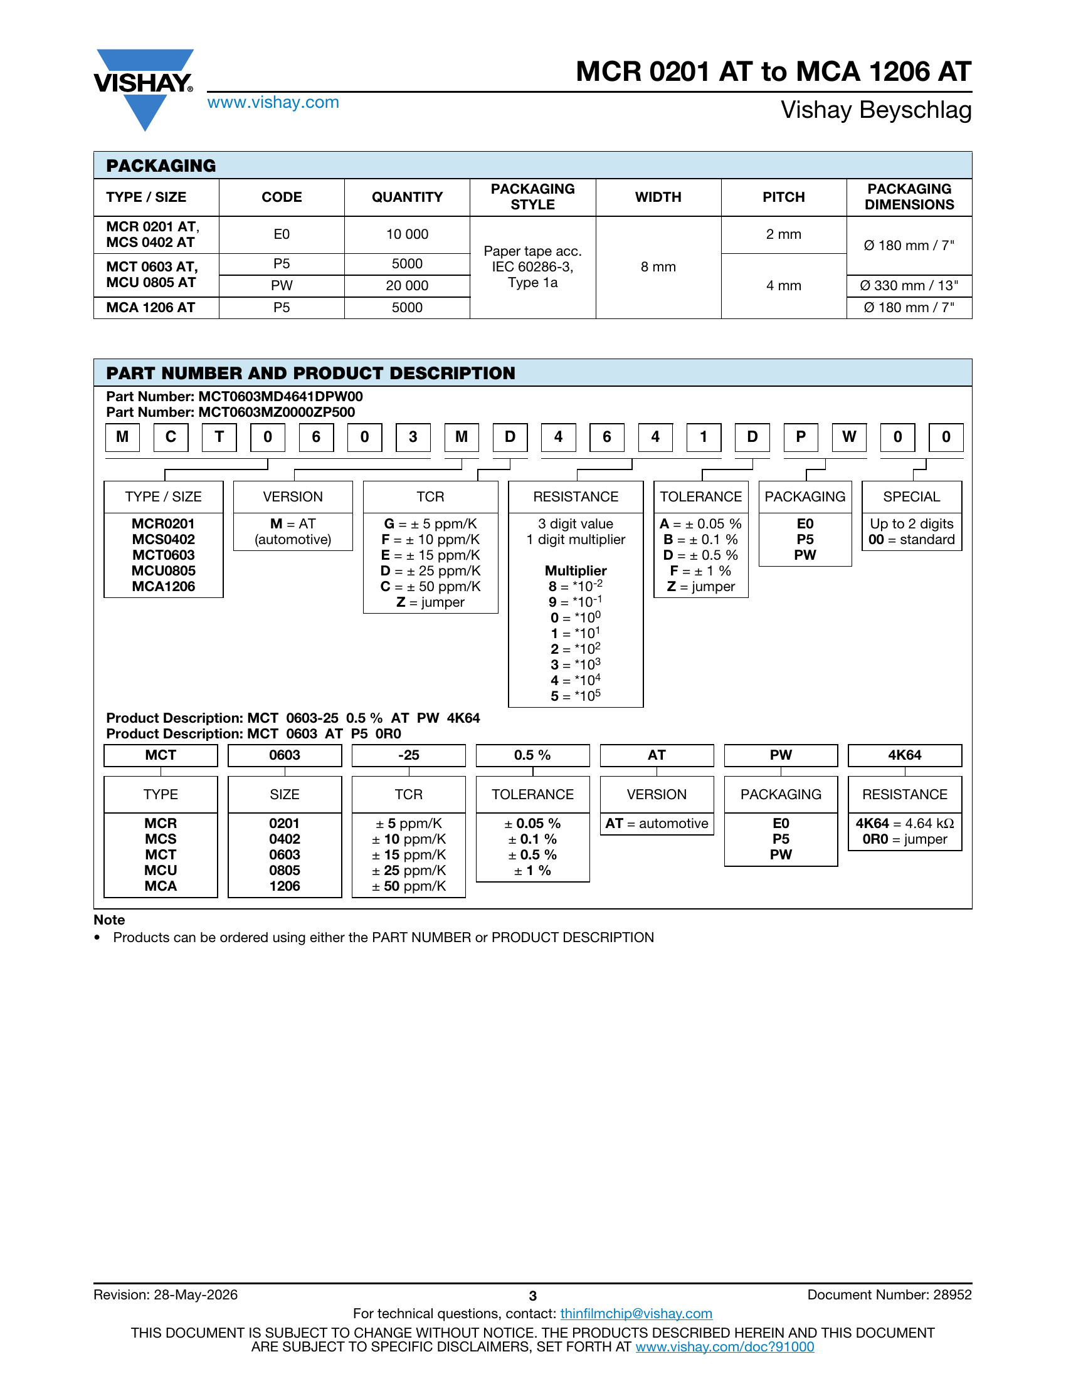
analysis/v1_1_release_20261012/as7331/review/vishay-range-ordering-03.png
