Stratolink-hq/Stratolink/analysis/v1_1_release_20261012/identities/supplier-placement-required.png

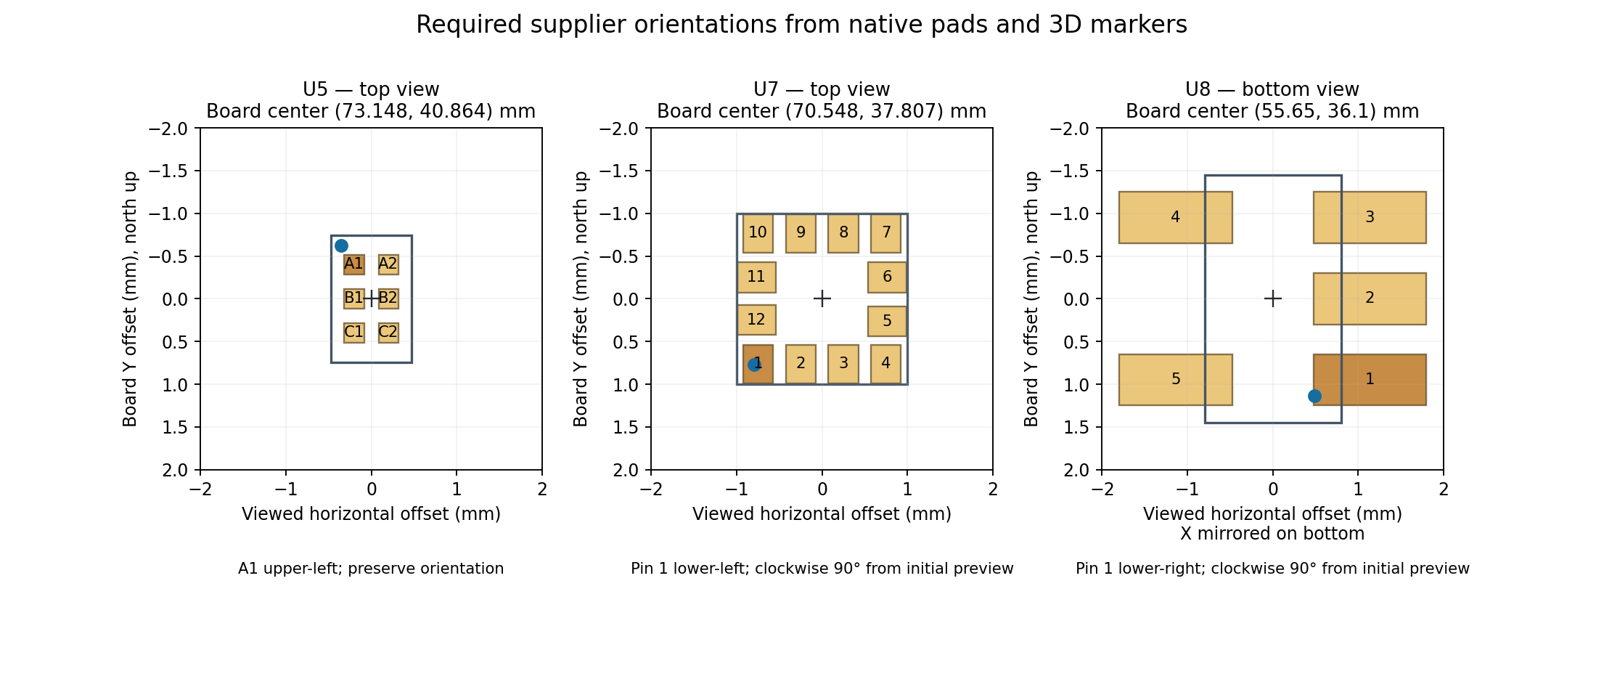
analysis/v1_1_release_20261012/identities/supplier-placement-required.png
