Stratolink-hq/Stratolink/analysis/v1_1_release_20261012/sourcing_followup/u2-placement-cpl90-full.png

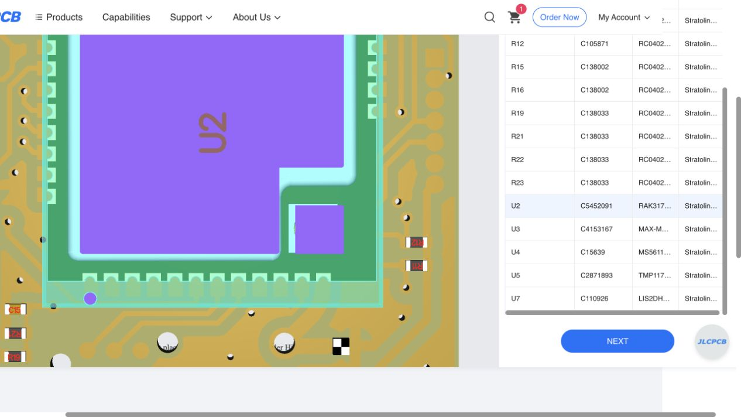
analysis/v1_1_release_20261012/sourcing_followup/u2-placement-cpl90-full.png
