Stratolink-hq/Stratolink/analysis/v1_1_supplier_review_20261016/cart-final.png

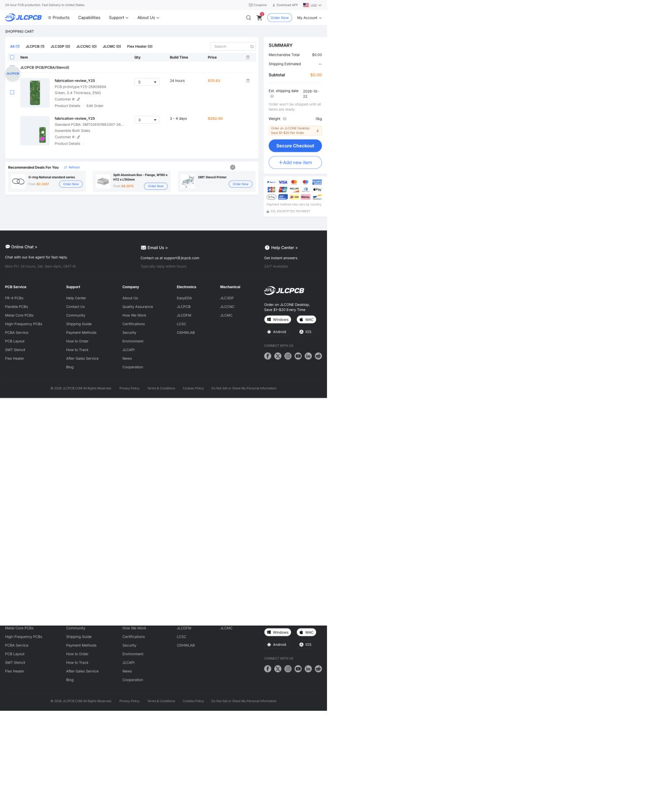
analysis/v1_1_supplier_review_20261016/cart-final.png
