Stratolink-hq/Stratolink/analysis/v1_1_supplier_review_20261016/cart-placement-top.png

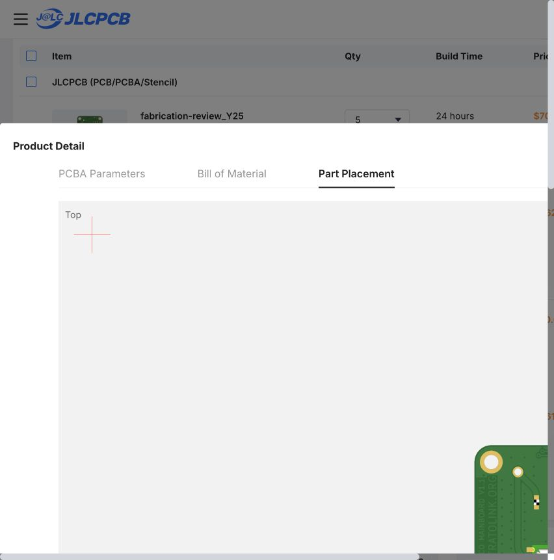
analysis/v1_1_supplier_review_20261016/cart-placement-top.png
