Stratolink-hq/Stratolink/analysis/v1_1_supplier_review_20261016/u4-top-close.png

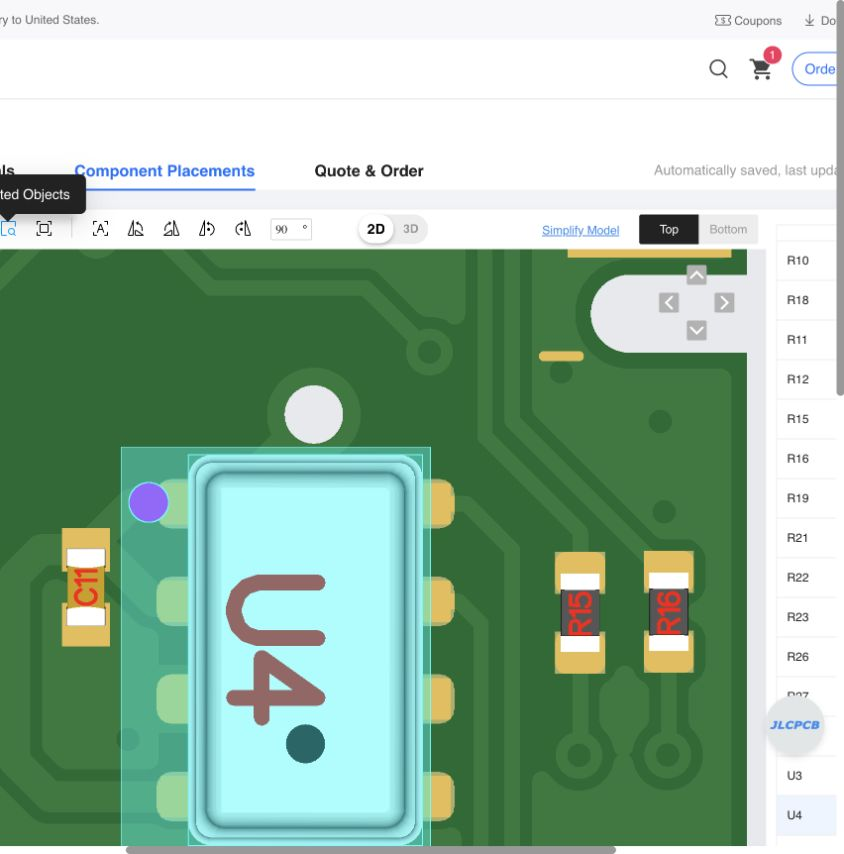
analysis/v1_1_supplier_review_20261016/u4-top-close.png
