Stratolink-hq/Stratolink/analysis/v1_1_supplier_review_20261016/u8-before-close.png

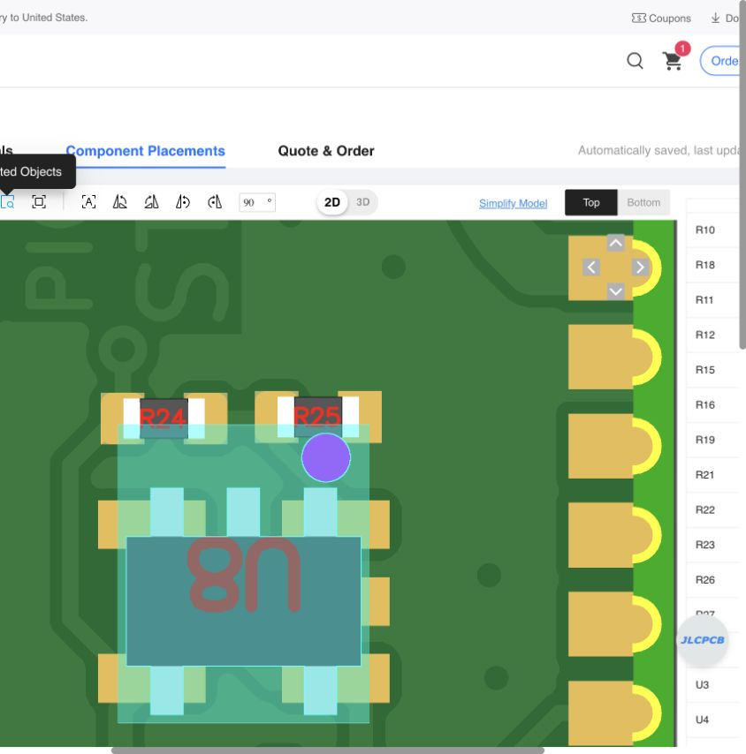
analysis/v1_1_supplier_review_20261016/u8-before-close.png
