Stratolink-hq/Stratolink/analysis/v1_1_final_sweep_20261016/jlc/assembly-final.txt

24
SMT
24-hour PCB production. Fast Delivery to United States.
 Coupons
 Download APP
USD 
JLCPCB
Products
Capabilities
Support 
About Us 
1
Order Now
My Account 
SHOPPING CART
All (1)
JLCPCB (1)
JLC3DP (0)
JLCCNC (0)
JLCMC (0)
Flex Heater (0)
Item
Qty
Build Time
Price
JLCPCB (PCB/PCBA/Stencil)
fabrication-review_Y26
PCB prototype:Y26-2680969A
Green, 0.4 Thickness, ENIG
Customer #: 
Product Details  Edit Order
5
24 hours

$70.63
 
fabrication-review_Y26
Standard PCBA: SMT026101664930-2680969A
Assemble Both Sides
Customer #: 
Product Details  
3

3 - 4 days

$262.00
Recommended Deals For You
Refresh
O-ring National standard series
From $0.017
Order Now
Split Aluminum Box - Flange, W190 x H72 x L150mm
From $8.3875
Order Now
SMT Stencil Printer
Order Now
SUMMARY
2 items>
Merchandise Total
$332.63
Shipping Estimated
$31.59
Coupons
-$9.00 
Subtotal
$355.22
Est. shipping date 
2026-10-20
Order won't be shipped until all items are ready.
Weight
0.35kg
Order on JLCONE Desktop: Save $1–$20 Per Order
Secure Checkout
Add new item
Payment method may vary by country.
SSL ENCRYPTED PAYMENT
Online Chat >
Chat with our live agent for fast reply.
Mon-Fri: 24 hours, Sat: 9am-6pm, GMT+8
Email Us >
Contact us at supportjlcpcb.com
Typically reply within hours.
Help Center >
Get instant answers.
24/7 Available.
PCB Service
FR-4 PCBs
Flexible PCBs
Metal Core PCBs
High-Frequency PCBs
PCBA Service
PCB Layout
SMT Stencil
Flex Heater
Support
Help Center
Contact Us
Community
Shipping Guide
Payment Methods
How to Order
How to Track
After-Sales Service
Blog
Company
About Us
Quality Assurance
How We Work
Certifications
Security
Environment
JLCAPI
News
Cooperation
Electronics
EasyEDA
JLCPCB
JLCDFM
LCSC
OSHWLAB
Mechanical
JLC3DP
JLCCNC
JLCMC
Order on JLCONE Desktop, Save $1–$20 Every Time
Windows
MAC
Android
IOS
CONNECT WITH US
© 2026 JLCPCB.COM All Rights Reserved.
Privacy Policy
Terms & Conditions
Cookies Policy
Do Not Sell or Share My Personal Information
Product Detail
PCBA Parameters
Bill of Material
Part Placement
PCBA Type	Standard
Assembly Side	Both Sides
PCBA Qty	3
Edge Rails/Fiducials	Added by JLCPCB
Confirm Parts Placement	Yes
Bake Components	No
Photo Confirmation	No
Board Cleaning	No
Conformal Coating (cleaning included)	No
Packaging	Antistatic bubble film
Special stencil	No
Depanel boards & edge rail before delivery	No
Solder Paste	High temp.
Flying Probe Test	No
Nitrogen reflow soldering	No
Function test	No
Assembly remark	Yes
Remark: v1.1 PCB25b201eb, 3 assembled pilots. U6 AS7331 DNP only; fit C14/C23/R27. Use supplied pilot paste: no paste on 16 U6 lands. C5, antennas and solar parts are hand-fitted after reflow. Preserve via tenting. Review 100um stencil for TMP117/U7; do not apply a second global paste reduction. U1 rotated; U8 now FRONT. Confirm all pin-1 orientations against current CPL. Manual placement approval, no automatic changes. Keep rails/tabs clear of solar banks and suspension holes.

File provided as	Single Piece, pls help me repeat the data
Panel Format	1 * 1
Build Time	3 - 4 days
Stencil Storage	No
Fixture Storage	No
Gross Weight	0.03 kg
Product Description	jlcpcb_missing_text/jlcpcb_missing_text
