Stratolink-hq/Stratolink/analysis/v1_1_final_sweep_20261016/population/l2-manufacturer-source.md

# L2 manufacturer rating source

Checked October 16, 2026. The in-app browser opened LCSC C436784 and exposed its datasheet iframe URL. The embedded PDF remained blank, so read-only PDF text extraction was used for that exact document.

[PROD Technology PWCWAQ1608F series, VER 1.0, December 22, 2016](https://datasheet.lcsc.com/datasheet/pdf/4d87d3ae1cd70236e03c0382f2a5b4cb.pdf?productCode=C436784), one page.

For PWCWAQ1608F-100KTT, the manufacturer lists 10 µH ±10%, a 7.9 MHz test condition, maximum DCR 2.405 Ω, typical Isat 280 mA and typical Irms 280 mA. Electrical specifications are at 25 °C. Operating and storage temperature are −40 to +125 °C. The text does not specify the inductance-drop criterion or a guaranteed minimum saturation current across temperature.

The fresh [LCSC listing](https://www.lcsc.com/product-detail/C436784.html) agrees on the numeric current/DCR values but does not preserve the manufacturer's typical-versus-maximum distinction in its summary. Use the manufacturer distinctions for review. This is a rating screen, not a measured converter-efficiency or cold-performance result.
