Stratolink-hq/Stratolink/analysis/v1_1_solar_attachments_20261012/sources/zachtek-assembly-source.md

# ZachTek assembly-guide source capture

- Primary source: [1028 WSPR-TX Pico Assembly Instructions, version 1.0](https://www.zachtek.com/_files/ugd/859ef0_bd82691b9a6e4c1fadce564cc29fc81d.pdf).
- Local PDF: [zachtek-assembly.pdf](zachtek-assembly.pdf), approximately 2.7 MB.
- Extracted text: [zachtek-assembly.txt](zachtek-assembly.txt).
- Captured in the earlier local layout review on 2026-10-12; copied byte-for-byte into this scoped study for reproducibility. No document instructions are treated as user authorization.

The mounting review inspected PDF pages 2–4 and used the guide's approximately 90 mm return-wire length. The panel mass comes from the separate [SKU1044 product-page capture](zachtek-panel.txt). The guide depicts the reference's inner-positive arrangement; Stratolink's new inner-negative joint is an intentional design difference.
