Stratolink-hq/Stratolink/analysis/v1_1_engineer_review_20261015/fabrication/electrical-wedges.csv

ID | Layer | Nets | X_mm | Y_mm | Gap_angle_deg | Minimum_adjacent_support_mm | Width_at_0.10mm_depth_mm | Width_at_0.125mm_depth_mm | Empty_region_area_mm2 | Reaches_board_edge
1 | F.Cu | Net-(AE2-A) | 59.730001 | 34.069329 | 44.99990892882312 | 2.011318570037571 | 0.08284271247467838 | 0.10355339059335127 | 6.126322106663009 | False
2 | F.Cu | /SC_HALF_REF | 57.528578 | 47.97 | 45.0 | 0.3310780000000051 | 0.08284271247462033 | 0.10355339059327608 | 290.90104273551117 | True
3 | F.Cu | RST | 61.437132 | 63.905 | 45.0 | 0.12786799999999943 | 0.08284271247462033 | 0.8680703521855127 | 290.90104273551117 | True
4 | F.Cu | SDA | 67.861422 | 41.56 | 45.05687240296959 | 0.4953686053082012 | 0.08284290354731542 | 0.10355362943414614 | 290.90104273551117 | True
5 | F.Cu | +3.3V | 67.1 | 59.394213 | 44.99999999999986 | 0.8357869999999963 | 0.08284271247462033 | 0.10355339059326951 | 290.90104273551117 | True
6 | F.Cu | BOOT0 | 62.387132 | 63.905 | 45.077242776272755 | 0.1778669999999991 | 0.08284275657418314 | 0.10355344571772496 | 290.90104273551117 | True
7 | F.Cu | +3.3V | 72.7 | 34.382132 | 45.0 | 0.36912000000000234 | 0.08284271247462033 | 0.10355339059326951 | 290.90104273551117 | True
8 | F.Cu | /UV_REXT | 73.404632 | 40.13 | 47.21171947433143 | 0.08952992579577976 | 0.09300194306814179 | 0.12321866369327379 | 290.90104273551117 | True
9 | B.Cu | VSTOR | 62.478422 | 29.797 | 45.00000000000051 | 0.27304786934161945 | 0.08284271247461976 | 0.10355339059327608 | 239.8742785881625 | True
10 | B.Cu | SDA | 65.8296 | 63.976795 | 45.00000000000051 | 0.5672636872848439 | 0.08284271247462303 | 0.10355339059326951 | 239.8742785881625 | True
11 | B.Cu | +SOLAR | 71.525 | 34.108008 | 44.999999999999716 | 0.6069920000000053 | 0.08284271247462033 | 0.10355339059326951 | 239.8742785881625 | True
12 | B.Cu | +SOLAR | 70.617868 | 35.27 | 45.04530134435609 | 0.5478680000000082 | 0.08284272764304584 | 0.10355340955381245 | 239.8742785881625 | True
