Stratolink-hq/Stratolink/analysis/v1_1_engineer_review_20261015/fabrication/electrical-wedge-closeups.png

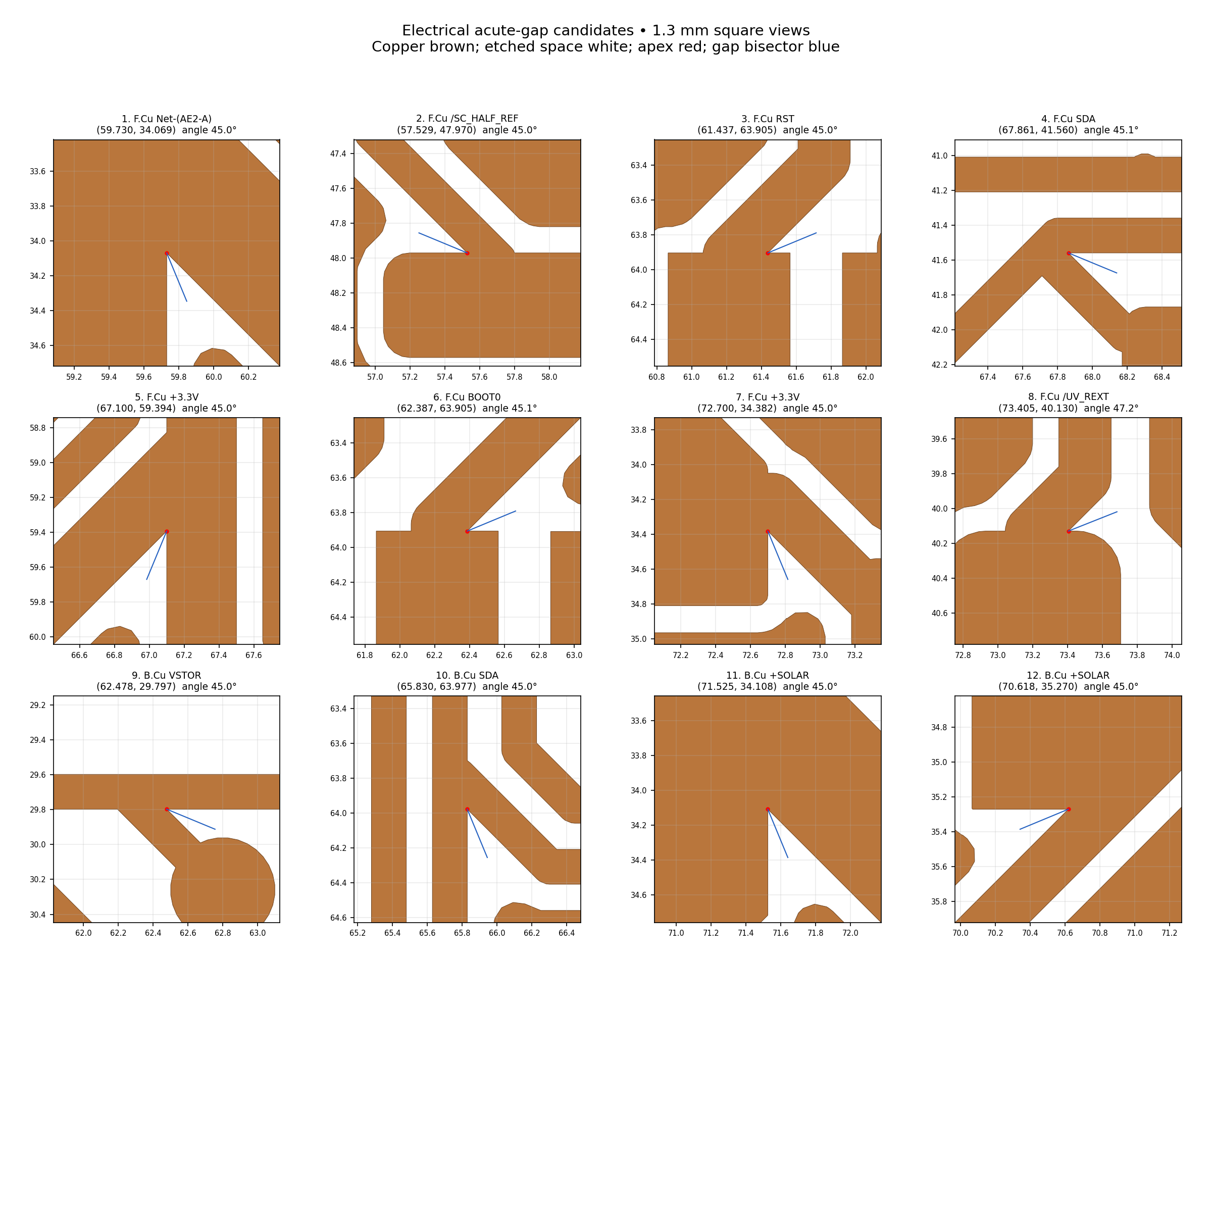
analysis/v1_1_engineer_review_20261015/fabrication/electrical-wedge-closeups.png
