Stratolink-hq/Stratolink/analysis/v1_1_engineer_review_20261015/mechanics/visual/assembly.png

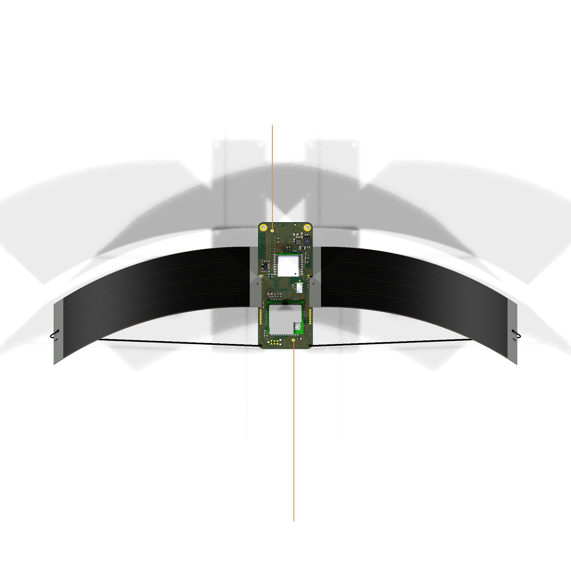
analysis/v1_1_engineer_review_20261015/mechanics/visual/assembly.png
