Stratolink-hq/Stratolink/analysis/v1_1_peer_review_20261014/fabrication/geometry-details.png

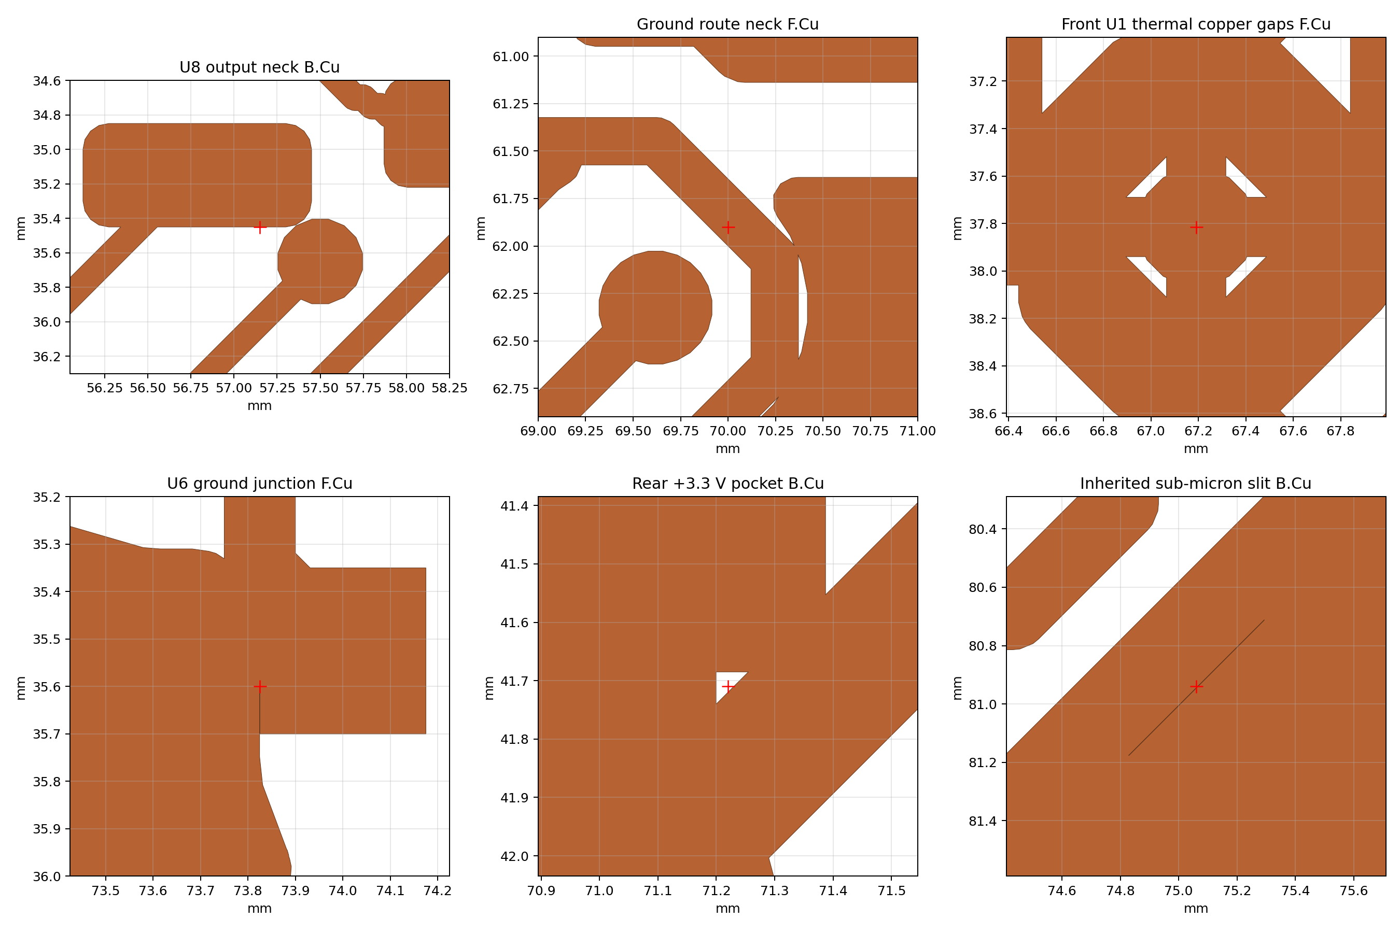
analysis/v1_1_peer_review_20261014/fabrication/geometry-details.png
