Stratolink-hq/Stratolink/analysis/v1_1_release_20261012/as7331/review/design-guide-reference-schematic.png

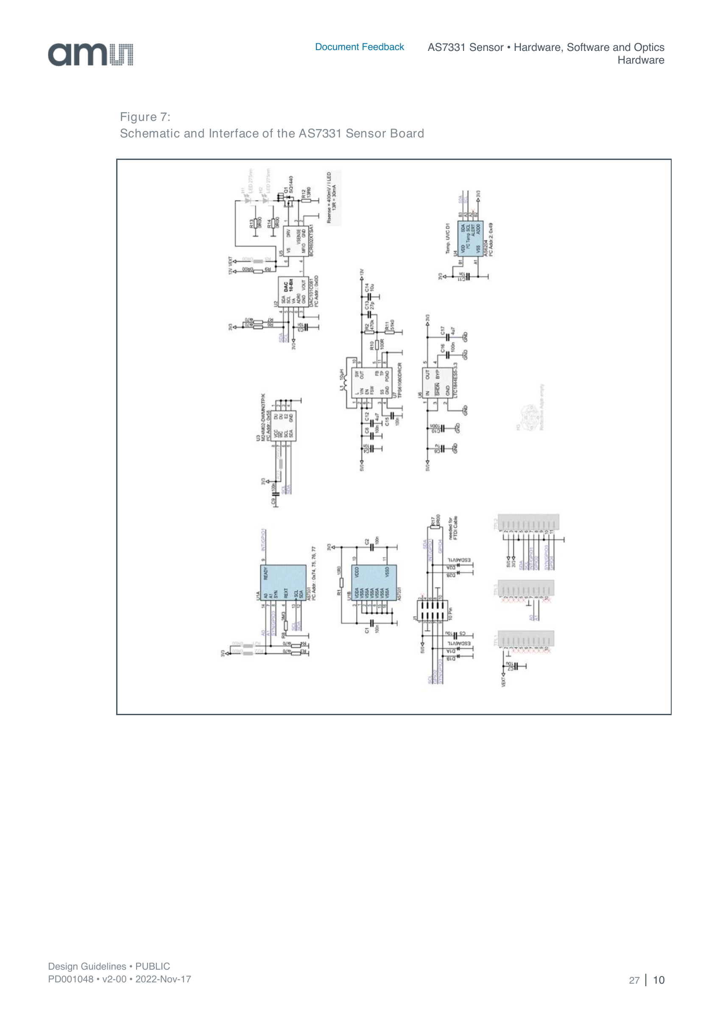
analysis/v1_1_release_20261012/as7331/review/design-guide-reference-schematic.png
