Stratolink-hq/Stratolink/analysis/v1_1_resubmit_20261108/assembly-review/max-m10s-footprint.png

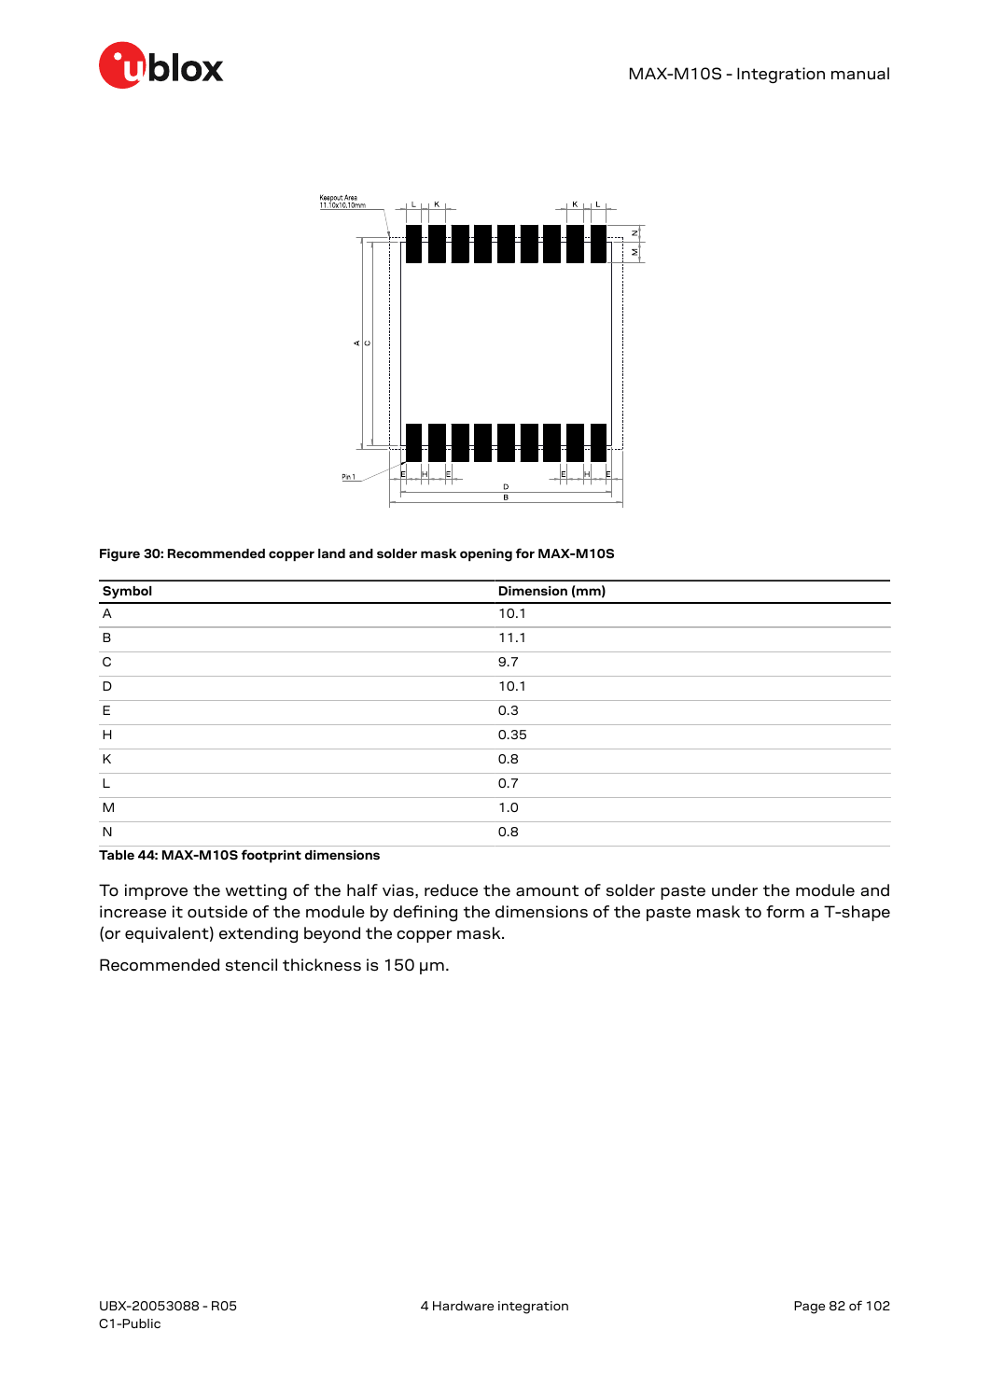
analysis/v1_1_resubmit_20261108/assembly-review/max-m10s-footprint.png
