Stratolink-hq/Stratolink/analysis/v1_1_resubmit_20261108/assembly-review/ms5611-dimensions.png

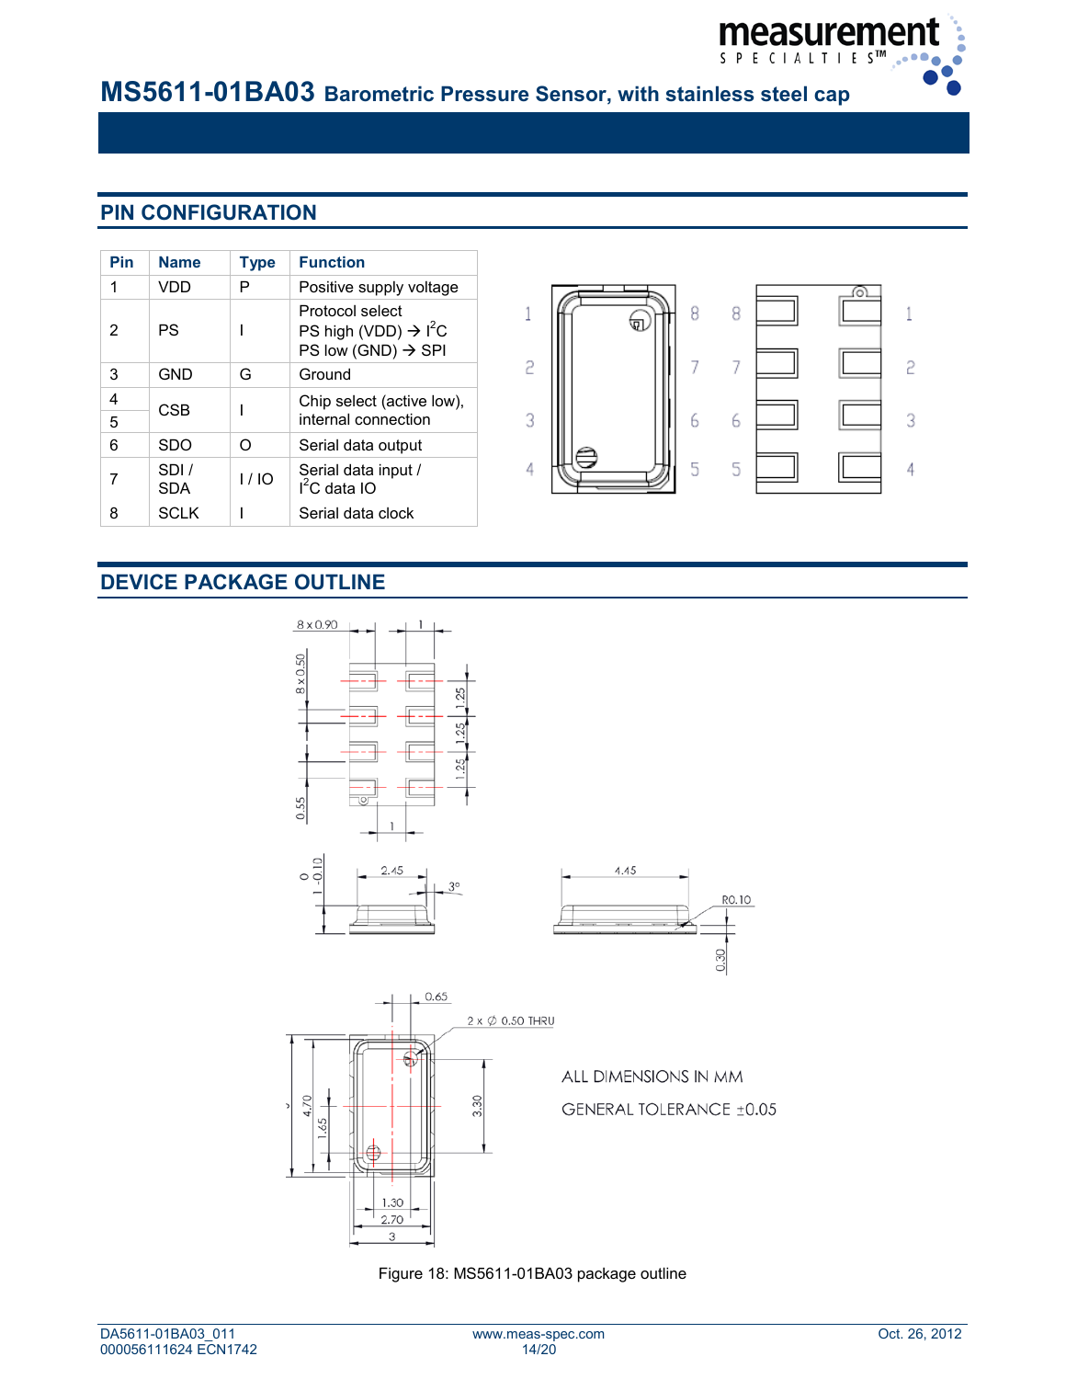
analysis/v1_1_resubmit_20261108/assembly-review/ms5611-dimensions.png
