Stratolink-hq/Stratolink/analysis/v1_1_solar_attachments_20261012/assembly/assembled-rear.png

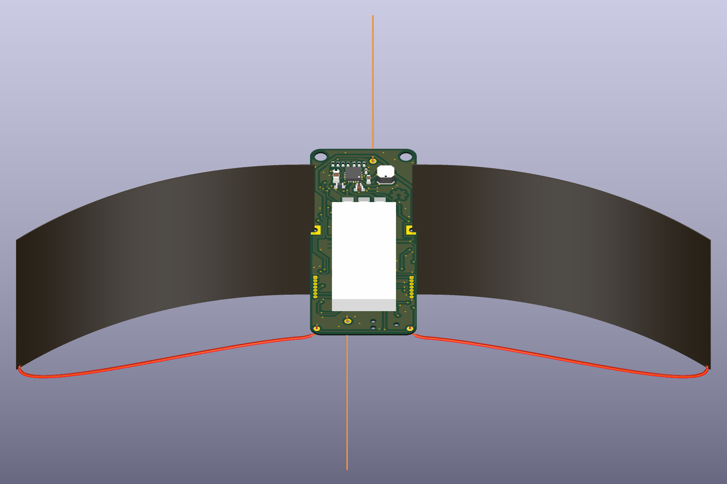
analysis/v1_1_solar_attachments_20261012/assembly/assembled-rear.png
