Stratolink-hq/Stratolink/analysis/v1_1_solar_attachments_20261012/qualification/views/assembled-rear.png

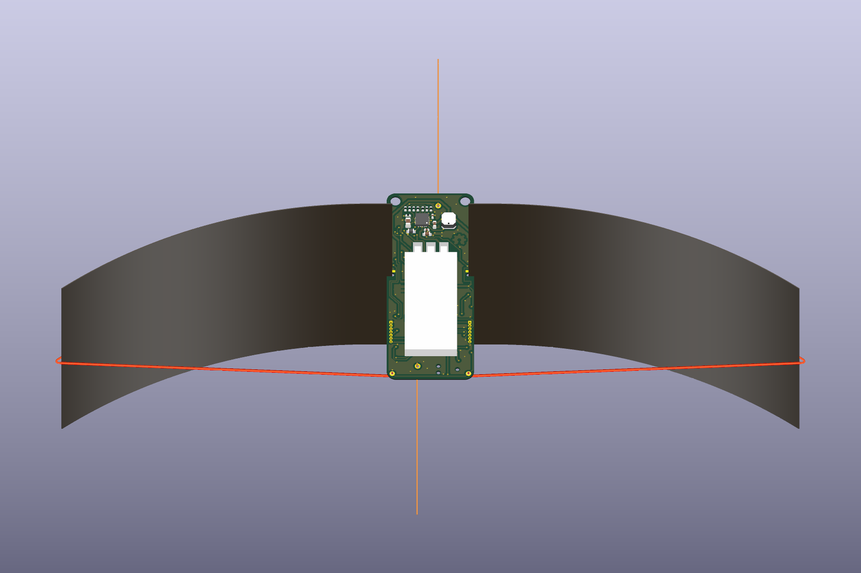
analysis/v1_1_solar_attachments_20261012/qualification/views/assembled-rear.png
