Stratolink-hq/Stratolink/analysis/v1_1_top_gnss_20261014/mechanics/assembly-projection.png

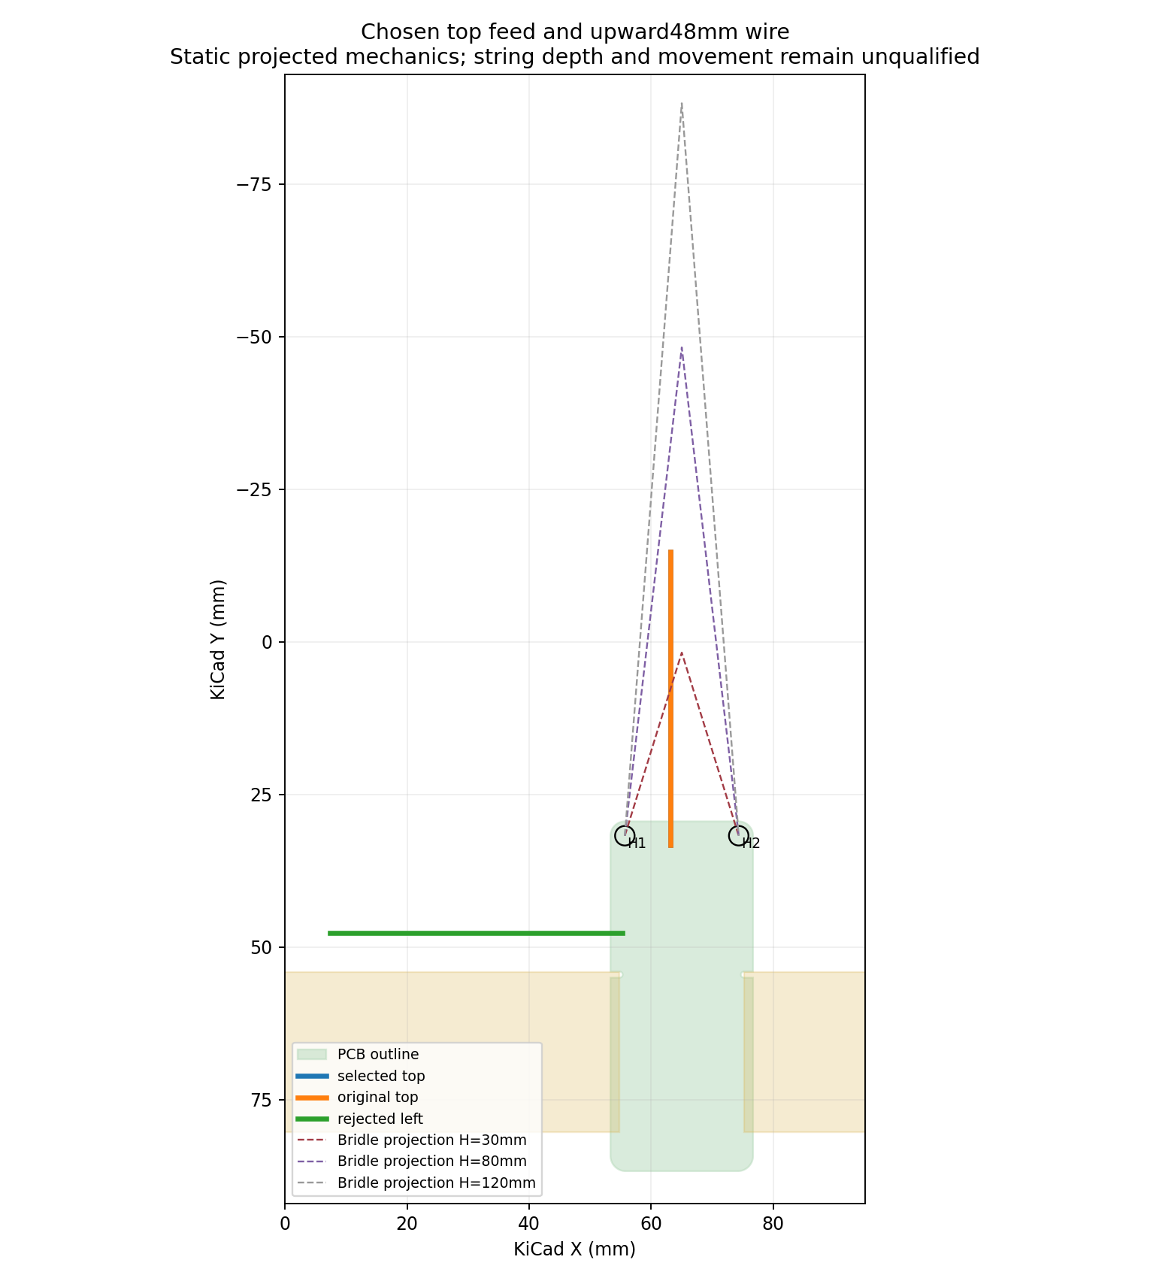
analysis/v1_1_top_gnss_20261014/mechanics/assembly-projection.png
