Stratolink-hq/Stratolink/analysis/v1_1_suspension_20261012/fem/results.csv

substrate_bore_radius_mm | spacing_mm | cut_y_mm | apex_height_mm | contact_half_angle_deg | nodes | triangles | retained_other_drills | mesh_area_error_fraction | load_total_vertical_N | each_hole_inward_N | compliance_mm_per_N | strain_energy_Nmm | max_displacement_um | band_area_mm2 | band_average_von_mises_MPa | free_residual_N | moment_residual_Nmm | variant
1.35050694185554 | 0.22 | 42 | 20 | 60.0 | 6614 | 12282 | 35 | 1.2292000274550757e-15 | 1 | 0.7850151794549677 | 0.0007396106063455907 | 0.0003698053031727946 | 0.5020049100541784 | 14.040926367336416 | 0.7539526952384958 | 4.5196872286691234e-15 | -1.4282701372542592e-13 | current
1.018 | 0.22 | 42 | 20 | 60.0 | 6726 | 12506 | 35 | 1.4089849013849833e-15 | 1 | 0.7850151794549677 | 0.0006879723678175474 | 0.00034398618390877624 | 0.41888771838519734 | 11.446599999999883 | 0.764184514979698 | 4.850103907118733e-15 | -3.7420471220506316e-14 | selected
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
