Stratolink-hq/Stratolink/hardware/pcb/TODO.md

# Stratolink v1.1 and v2 checklist

Updated 8 November 2026 for the [corrected replacement pilots](../../analysis/v1_1_resubmit_20261108/README.md). C15/R21 spacing, the GNSS module allowance and R1 procurement identity are corrected and reviewed. The replacement cart is saved and verified for five PCBs and three Standard assemblies on both sides. No replacement order has been submitted or paid, and manufacturing has not been approved. Cancellation of **Y27-2680969A / SMT026110264457_Y27** is requested but unconfirmed. The November 6 approval applies only to the earlier order; the replacement cart preview has been reviewed, while its later factory production files still require review.

## Earlier pilot preparation retained as baseline

- [x] Compare the schematic, exported netlist and all physical pad assignments against the previous v1.1. No circuit changes.
- [x] Preserve the rerouted layout. Correct two signal-to-ground shorts, reconnect two ground sections, adjust local mask openings and remove two trapped copper gaps.
- [x] Move only C5, 1.30 mm downward, to restore rear ground beneath the GNSS input. Preserve the upward 48 mm antenna and the engineer's signal route.
- [x] Retain the improved C10 bypass placement. It is now 2.87 mm from U3 VCC. Measure rail behavior and FB1 voltage drop on pilots.
- [x] Run strict native DRC/ERC, schematic parity, independent filled-copper connectivity, mask, mechanical and 3D/library checks. See current evidence for exact source hashes and limitations.
- [x] Retain the green mask/no-silkscreen finish, 0.40 mm ENIG construction, solar notches, reinforced suspension holes, larger rear programming lands, corrected TMP117, microphone omission and flat rear capacitor.
- [x] Retain the full AS7331 circuit. Initial pilot omits only U6; C14/C23/R27 remain fitted. Use the explicit UV-DNP firmware target.
- [x] Regenerate and verify matching manufacturing and downloadable KiCad/library bundles from the final source.
- [x] Import and review both faces in JLC. On November 2, all 57 selected references matched the then-current MPN/LCSC/footprint/side data. All seven populated IC orientations agreed with those previews; U8 used supplier CPL 90 degrees. These were the original Y27 files and selections. The later U1 factory-image correction and replacement reviews are recorded below.
- [x] Restore the missing working-copy VSTOR voltage-sense segment and strict mask checks; preserve schematic cosmetics and all reviewed footprint poses.
- [x] Prepare both UV-omitted and populated exports from the same current source. Verify U6 is the only population difference and sixteen U6 paste apertures are the only stencil difference.
- [x] Send JLC the sourcing inquiry with the current draft reference, total added cost, earliest dispatch and optical-package handling questions. Reply is expected in the personal email thread.

## Original pilot ordering decision

- [x] JLC canceled quote XOB2026101800470 on October 26 because its supplier could not supply three sensors. On November 2, both AQFM and AQFT remain unavailable at JLC and LCSC. Teddy chose three UV-omitted pilots. No sourcing reply remains a prerequisite for this order.
- [x] Refresh and save the original Y27 cart with the reviewed package, corrected source identifiers in the remarks, 57 selected placements and manual production/placement approval. Its November 2 estimate was $326.85 for PCB/assembly and $347.71 with displayed shipping and coupon. These are historical figures, not the replacement quote.

## Factory work after the ordering decision

These are checks of files JLC generates for the order, not unfinished native design work.

- [x] Review JLC's actual PCB production package, panel/tab positions, copper connectivity, mask and drills. November 6: 59 nets, 183 board holes and source outline preserved; six breakaway tabs clear pads/tracks/vias. Factory compensations are documented in the [CAM review](../../analysis/v1_1_cam_review_20261106/README.md). Included ODB paste still omits U6 and retains C14/C23/R27.
- [x] Confirm the reviewed PCB production file on JLC. November 6: submitted with Teddy's explicit authorization; JLC displayed “Submit success” and “Production file Confirmed”.
- [x] Review JLC's November 7 final assembly images. Found U1 pin-1 index opposite the released board and C15/R21 absent from the depiction. The U2 body-clearance issue was not caught by prior copper DRC; its footprint lacks a body/courtyard outline. See [assembly review](../../analysis/v1_1_assembly_review_20261107/README.md).
- [x] Review corrected U1 orientation. November 8 updated supplier image has the index upper-left beside C4, matching released pad 1. Other IC indices remain consistent; C15/R21 are still absent. See [follow-up review](../../analysis/v1_1_assembly_followup_20261108/README.md).
- [x] Choose the C15/R21 disposition. November 8: Teddy chose a corrected PCB and cancellation/resubmission instead of local rework. Both parts must remain factory-fitted. Cancellation of Y27-2680969A / SMT026110264457_Y27 was requested by email; the earlier hand-rework proposal is superseded.
- [ ] Receive JLC's cancellation confirmation and refund/credit breakdown, including whether purchased components can transfer. Do not treat the request as completed cancellation.
- [x] Correct C15/R21 spacing, move R11 upward 0.35 mm for GNSS residual-tab allowance, and add U2 body/courtyard geometry. November 8: DRC has no active findings, all 59 copper nets remain connected, and all 940 same-face pairs of 57 fitted SMT parts clear the 0.2 mm package-envelope screen. Circuit and net assignments are unchanged. See the [replacement review](../../analysis/v1_1_resubmit_20261108/README.md).
- [x] Qualify **UNI-ROYAL 0402WGF7504TCE / C423135** for R1 and update its procurement fields in the PCB and schematic. Resistance remains 7.50 MΩ ±1%; no footprint, placement or routing change. JLC showed 10,002 available on November 8, compared with 17 of the prior part against 20 required. This is an availability observation, not a reservation. The regenerated BOM and all-57 clearance audit use the new identity. [Source and compatibility review](../../analysis/v1_1_resubmit_20261108/r1-sourcing.md).
- [x] Regenerate and verify the dated replacement manufacturing and download bundles, bound to PCB `406a3a…` and schematic `c63bf8…`. The retained fabrication upload is physically equivalent to the regenerated ZIP; the amended R1 BOM is uploaded and the CPL is unchanged by the procurement substitution.
- [x] Save and verify replacement PCB cart **Y28-2680969A** and PCBA **SMT026110862453-2680969A**. All 57 MPN/LCSC identities, sides and selection checkboxes match, including C15/R21. All seven fitted IC pin-1 indices match the intended physical orientations in the new preview. Merchandise is $326.63 plus estimated shipping of $26.60, for an estimated $353.23 subtotal. The site estimates shipment on November 14, 2026; this is not guaranteed.
- [ ] Submit/pay for the replacement after Teddy's review. New factory CAM and placement files require review before manufacturing approval. No replacement submission, payment or production approval has been made.
- [x] Manual production-file and placement confirmation were enabled for the original Y27 order; automatic production approval was disabled. Preserve these settings for the replacement and compare any supplier substitution or geometry change to the reviewed files.

Previous implementation decisions and their original evidence remain under [the v1.1 release record](../../analysis/v1_1_release_20261012/), [digital review](../../analysis/v1_1_peer_review_20261014/digital/README.md) and [power review](../../analysis/v1_1_peer_review_20261014/power/README.md). Retain both 10 uF capacitors, the 4.7 kohm I2C pull-ups and the established RAK SWD mapping. UART observation requires avoiding transmitter contention. These electrical decisions survive the reroute; old coordinates, mask results and supplier previews do not.

## Physical acceptance after the assembled pilots arrive

These require actual hardware and do not block ordering development samples. They remain required before calling the revision flight-qualified or ordering the larger batch. Follow the [pilot acceptance procedure](../../analysis/v1_1_release_20261012/pilot-acceptance.md), recording conditions, measured values and pass/fail evidence. None of these is completed by DRC or a model.

- [ ] **Inspect before power.** Verify green mask, exposed soldering lands, absent silkscreen, handling, fine-pitch joints/shorts, exact identities, orientation and connectivity. Confirm the chosen U6 population and C14/C23/R27 fitted. Hand-fit the flat capacitor after cleaning and check all three terminals.
- [ ] **Establish solar and storage bounds.** Measure cold panel Voc/I–V and BQ25570 input voltage/power. Measure charge plateau, both cells, midpoint startup/stability, cold ESR/leakage and load transients. Resolve charging faults and large steps before accepting the balancing circuit.
- [ ] **Verify dark endurance and sunrise recovery.** Use actual temperature and final assembly without debugger power. Measure residual GNSS current, brownout/reset and data recovery; nominal capacitor energy is not an all-night reserve.
- [ ] **Verify sensors and the pilot firmware.** Prove direct TMP117 ACK/ID/readings at 0x48 against a temperature reference. Confirm pressure, IMU, GNSS and unavailable UV/lux/acoustic reporting. Pressure fallback does not establish TMP117 operation. DNP firmware must issue no optical probes; a populated U6 needs its compatible driver and bring-up.
- [ ] **Qualify mounts and bridle.** Measure panel terminal thickness/wettable area, wire gauge, string material/diameter, apex height and total mass. Compare flex, rim wear and security with v1 under measured loads and cold/handling cycles; use sacrificial samples for uneven/out-of-plane loading.
- [ ] **Compare installed RF and GNSS behavior.** Record regional wire cut, exit and whole-payload geometry; compare orientation-dependent links, C/N₀, fix recovery and LoRa interference against v1. The new UV circuit warrants a matched full-assembly comparison even on DNP pilots. VNA match alone is insufficient. Follow the [matched whole-payload GNSS comparison](../../analysis/v1_1_top_gnss_20261014/reception-test.md); a top wire and higher satellite count do not by themselves prove better accuracy.
- [ ] **Accept the three pilots before a larger batch.** Review failures, rework, measured margins and sustainable component supply before ordering approximately fifteen.

## Follow-on experiments and supply work

- [ ] **Bring up AS7331 if populated later.** Native hardware and both export options are complete. The November pilots omit U6; sourcing is follow-on work. Validate bounded command-mode acquisition, verified power-down and raw multiband telemetry on the fitted part. Do not reuse DNP firmware after fitting U6; AS7331 provides no visible ALS.
- [ ] **Characterize the UV experiment.** Measure dark offsets, gain/exposure, saturation, temperature, angular response and sunlight VIS/NIR leakage. Design an appropriate opaque angle-limiting collector and blocking filter as needed, then compare against calibrated spectra. Broad-band ratio alone is not accepted ozone metrology. [Requirements](../../analysis/v1_1_release_20261012/as7331/review/requirements.md).
- [ ] **Find a sustainable flat-capacitor replacement.** Preserve the current 30 × 14 × 3.7 mm rear envelope unless measurements justify a change. Compare price/stock, terminals, mass, tolerance, cold ESR/leakage and dark/recovery performance. Smaller 470 mF and wider HW203F candidates are tradeoffs, not equivalents. Local notes: `analysis/v1_1_layout_20261012/flat_storage/README.md`.
- [ ] **Resolve IMU idle current.** Verify LIS2DH12 SA0 pull-up control (`CTRL_REG0.SDO_PU_DISC`) in the selected firmware. The remaining grounded-strap ERC disposition does not establish minimum sleep current. The old LTR390 interrupt configuration no longer applies to this PCB.
- [ ] **Evaluate GNSS upgrades against measured benefit.** Keep MAX-M10S as baseline. Recheck exact MAX-M11N availability/firmware, pins 16/17 and true power isolation before raw-carrier work. Compare MAX-M10N navigation/coexistence with matched antennas and local radio activity. PPS/reset does not isolate power. Local notes: `analysis/v1_1_layout_20261012/gnss_uv/README.md`.
- [ ] **Qualify one-radio regional, wildlife and Meshtastic operation.** Measure the exact front end, antenna and compatible channel/preset windows. Regional labels do not prove 433 MHz sensitivity, and a wire change cannot bypass internal matching. One receiver cannot listen on all channels simultaneously. Local notes: `analysis/redesign_20261010/radio_mechanics/README.md`.

## v2 investigations

- [ ] **Repack a shorter, possibly thicker board.** Existing modeling adds about 0.50 g at 0.6 mm for the same outline. Equal mass needs about 40.9 mm length at current width under proportional copper scaling; retained envelopes span over 52 mm. Produce an actual fit before claiming parity; compare upper mounts, center of mass and RF. [Materials model](../../analysis/v1_1_solar_attachments_20261012/materials/README.md).
- [ ] **Improve ambient-air temperature measurement.** Test shielding, thermal isolation or a lightweight remote probe against references; separate chip accuracy from solar/conduction/low-pressure error.
- [ ] **Specify an identifiable atmospheric GNSS experiment.** Choose raw satellite observations or a separate coherent payload-to-ground instrument, with appropriate antennas, logging, clocks and references. Accurate position plus LoRa timestamps does not separately identify path temperature, pressure and humidity. Local notes: `analysis/redesign_20261010/metrology/README.md`.
- [ ] **Develop ozone optics from reference data.** Compare broad bands against narrower simultaneous absorption/reference bands or a spectrometer, including out-of-band leakage, pointing, clouds and aerosols. Validate column above the balloon, not local concentration.
- [ ] **Revise RF/power architecture only for measured needs.** A second receiver needs a demonstrated service benefit with acceptable mass/power/cost. Add true GNSS isolation, logging and qualified solar/storage when experiments define requirements.

Historical analysis retains intermediate states. Local working notes may sit outside the scoped release checkpoint; the final manufacturing package must remain reproducible from its own manifest.
