Stratolink-hq/Stratolink/analysis/v1_1_release_20261012/as7331/docs-draft/manual-review-changes.md

# v1.1 manual KiCad review — changes from flown v1

**DRAFT — final AS7331 promotion/review is {{FINAL_PROMOTION_STATUS}} / {{FINAL_REVIEW_STATUS}}.** Review `hardware/pcb/stratolink.kicad_pro` on `alpha/hardware-v1.1`. Final PCB: `{{FINAL_PCB_SHA256}}`; schematic: `{{FINAL_SCHEMATIC_SHA256}}`; checkpoint: `{{FINAL_COMMIT}}`. Flown comparison `f0fe2a0` has the same PCB bytes as `9bdd19ec`. Final DRC/ERC: **{{FINAL_DRC_RESULT}} / {{FINAL_ERC_RESULT}}**.

- **Fix temperature sensor U5:** correct TMP117AIYBGR C2871893 ball map and local routing. **A1 SDA, A2 SCL, B1 3.3 V, B2/C1 GND, C2 grounded unused ALERT**; address 0x48. U5/C12 placement stays fixed. Verify this directly on the pilots; pressure fallback is not proof of the fix.
- **Remove microphone:** delete **MK1/R20/C13**, dedicated routes and acoustic hole. PB3/PB4 become unused; a supply bridge preserves the shared FB1/GNSS path.
- **Replace UV sensor:** U6 becomes **AS7331-AQFM C20482877**, separate UVA/UVB/UVC, 16-pad footprint, address **0x74**. Move U6/C14 to **{{FINAL_UV_LOCATION}}**; add **C23 100 nF** and **R27 3.3 MΩ, ±0.1%, ±25 ppm/K 0805**. READY is NC; SYN/address pins are grounded. Final bus/interrupt routing and copper-label scope: **{{FINAL_UV_ROUTING_AND_LABEL_SCOPE}}**. This enables a later calibrated ozone-column experiment; populated-AS7331 firmware and optics remain development work.
- **Use an explicit UV-DNP pilot:** native CAD keeps the complete circuit; initial **BOM/CPL omit only U6**, with **C14/C23/R27 fitted**. Pilot stencil removes exactly **16 U6 apertures**; full-design paste is archived separately. This pilot produces no UV/lux/ozone data.
- **Improve solar attachment J1/J2:** **1.0 × 2.0 mm open unplated GND notches**, both-face upper-bank lands, and separate lower positive pads with **0.70 mm holes / 1.40 mm lands**. Panels stay parallel. Notch bypasses and the shared lower +SOLAR feed replace the old supports.
- **Add solar assembly models:** photo-scaled **94 × 75 mm** curved panels, straight negative roots, ground solder fillets and formed **0.50 mm positive wires**. Physical terminal thickness, bend limits and strength remain unmeasured.
- **Reinforce suspension H1/H2:** **2.0 mm plated holes / 3.2 mm grounded rings**, original centers, no paste, triangular string bridle. Check wear and corner loading physically.
- **Enlarge programming lands J3/J4:** **0.88 mm front / 1.20 × 0.88 mm rear**, rear offset 0.12 mm inward. **0.50 mm drills, 1 mm pitch and hole centers stay fixed.** These are PTH contacts, not castellated edge connectors. Local PB5/RX clearances and J3.2 thermal orientation are updated; solder temporary wires from the rear.
- **Improve IMU assembly U7:** retain all twelve copper lands and placement; use **90% linear paste / 81% area**, clear the central underside and use explicit GND returns on pads 3/5/6/7/8. The old LTR390-adjacent corridor no longer describes the final UV layout.
- **Clean ground and edge routing:** consolidate GND zones, make J20.5 solid GND, move near-edge +SOLAR/VSTOR/PA9 runs inward and delete the **0.0113 mm duplicate VSTOR segment**. Retain the **0.20 mm ordinary routed-edge minimum** and reviewed local thermals.
- **Green mask, no silkscreen:** board remains **23.36 × 57.30 mm, two layers, 0.40 mm, 1 oz copper and ENIG**. Remove all native silkscreen; retain selective green-mask openings, tent ordinary vias, and put solar polarity marks in copper. This supersedes the earlier bare-board interpretation.
- **Lower charge ceiling and balance the existing capacitor:** R1 **8.25 MΩ → 7.50 MΩ**, nominal ceiling **5.363 V → 5.041 V**. Add **U8 TLV8801, R24/R25 4.75 MΩ, R26 22 Ω, C22 100 nF** on the rear. C5 stays: **1 positive / 2 negative / 3 SC_MID**. Feedback is **before R26**; inspect the VSTOR ADC reroute and D3.1/J4.1 0.25 mm thermals. C5 is hand-fitted after reflow/cleaning. Cold/stability and solar-input limits still need measurement.
- **Correct identities and antenna models:** AE1/AE2 are straight enamelled wire, **82 mm at 915 MHz / 48 mm GNSS**, measured from the feed; holes, feeds and D1/D3 positions stay fixed. Correct TMP117 grade, PESD5V0U1BB diodes, 1 MΩ resistor selections, C5 terminals and U1 thermal-pad numbering; freeze project-local libraries. R4 becomes **RC0402FR-073M65L C477700**, U2 **RAK3172-8-SM-NI C5452091**, retaining their geometry/nets.
- **Make rules and ERC intent explicit:** enable copper/edge/annular checks with **0.10 mm process floor / 0.15 mm general target / 0.20 mm edge minimum** and named local constraints. Remove the old U6 corridor rule and grounded-INT exception. Retain only **U5 ALERT and U7 SA0** ERC exclusions; AS7331 READY is explicitly NC.

Assembly files retain the reviewed supplier CPL conventions **U1 90°, U2 90°, U4 270°, U7 0°, U8 90°; U3 180°, U5 0°**. These are not instructions to rotate footprints in KiCad. U4's black circle is its pressure port; use the separate pin-1 marker. U6 has no pilot placement row; later population needs its own supplier-model review.

Use **`stratolink_v1_1_uv_dnp`** on these U6-absent pilots. It suppresses optical transactions, marks UV/lux/acoustic data unavailable, leaves PB3/PB4 quiet and retains v1.1 power metadata. Do not use it after fitting AS7331. The earlier LTR390 v1.1 binary stays unchanged.

Final scope: **{{FINAL_FOOTPRINT_COUNT}} footprints**, **{{FINAL_FULL_ASSEMBLY_COUNT}} full-design / {{FINAL_PILOT_ASSEMBLY_COUNT}} pilot assembly references**, **{{FINAL_PILOT_PART_GROUPS}} pilot part groups**, **{{FINAL_EXCLUSION_COUNT}} exclusions**. Relative to the flown board, retained J1/J2 placement changes remain; this UV update additionally moves **U6/C14** and makes the separately reviewed **C21** bypass-capacitor adjustment described above. Other retained origins/layers/rotations remain fixed. No second radio, GNSS module replacement, capacitor replacement or solar-input limiter is included.

Final package and supplier evidence: **{{FINAL_JLC_EVIDENCE_LINK}}**. Native/connectivity/stencil proof: **{{FINAL_INDEPENDENT_REVIEW_LINK}}**. Planned order is **five fabricated boards / three assembled**. Cart status/link: **{{FINAL_CART_STATUS}} / {{FINAL_CART_LINK}}**; CAM status **{{FINAL_CAM_STATUS}}**. Checkout/payment is not authorized. Review and measure the pilots before the larger batch.

References: [canonical notes](../../hardware/pcb/README.md), [fabrication](../../hardware/pcb/FABRICATION.md), [AS7331 circuit](as7331/README.md), [UV primary review](as7331/review/requirements.md), [power](power/README.md), [U7/identities](identities/README.md), [headers](headers/README.md), [solar](../v1_1_solar_attachments_20261012/qualification/README.md), [suspension](../v1_1_suspension_20261012/README.md), [supplier rotations](jlc/supplier-rotation-profile.json).
