Stratolink-hq/Stratolink/analysis/v1_1_release_20261012/as7331/docs-draft/TODO.md

# Stratolink v1.1 and v2 checklist

Updated 2026-10-13. **DRAFT for the AS7331 update; not yet promoted.** Final canonical status: **{{FINAL_PROMOTION_STATUS}}**. The canonical project remains `hardware/pcb` on `alpha/hardware-v1.1`. Plan **five PCBs / three assembled pilots**, then physical qualification before roughly fifteen payloads. A reviewed cart draft is authorized; checkout/payment is not. Cart status: **{{FINAL_CART_STATUS}}**.

The design keeps the 0.4 mm ENIG board with green solder mask, no silkscreen and tented ordinary vias, one radio, precision temperature, existing GNSS/pressure/IMU and flat capacitor. **AS7331 is selected for U6; the initial pilot omits only U6 and fits C14/C23/R27.** Both antennas are straight enameled wire. Science is intended for measured daytime solar surplus; night means hibernation without radio/GNSS operation. Hardware does not physically isolate every GNSS supply, so real night current remains a measurement item.

## Earlier v1.1 design work retained

Checked design tasks do not prove a manufactured pilot works. Final combined verification of the AS7331 revision remains in the next section.

- [x] **Correct TMP117 pin map and routing.** U5 is TMP117AIYBGR C2871893; A1 SDA, A2 SCL, B1 3.3 V, B2/C1 GND, C2 grounded unused ALERT. Address 0x48. [Identity review](../../analysis/v1_1_release_20261012/identities/README.md).
- [x] **Remove microphone MK1/R20/C13 and the acoustic opening.** Preserve the shared supply path; PB3/PB4 remain quiet in v1.1 firmware. [Implementation](../../analysis/v1_1_microphone_20261012/README.md).
- [x] **Add solar notches and 3D assembly models.** Two 1.0 × 2.0 mm open unplated GND notches and lower positive PTH connections; parallel panels, modeled film/fillets/wires. Real terminal thickness and strength remain unmeasured. [Solar review](../../analysis/v1_1_solar_attachments_20261012/qualification/README.md).
- [x] **Reinforce suspension corners.** 2.0 mm plated holes with 3.2 mm GND rings, original centers and triangular string bridle. [Mechanics](../../analysis/v1_1_suspension_20261012/README.md).
- [x] **Clean zones, thermals, near-edge routes and tiny VSTOR stub.** Preserve wire-antenna feeds. [Ground](../../analysis/v1_1_ground_20261012/README.md), [edges](../../analysis/v1_1_edges_20261012/README.md), [historical antenna/finish work](../../analysis/v1_1_bare_finish_20261012/README.md).
- [ ] **Apply the corrected finish: green solder mask, no silkscreen.** Remove full-board openings and native silk, retain selective soldering apertures, add copper solar polarity marks, and tent ordinary vias. Verify native mask checks and actual Gerbers before promotion.
- [x] **Enlarge J3/J4 rear programming lands.** 1.20 × 0.88 mm rear lands offset 0.12 mm inward; original hole centers, 1 mm pitch and 0.50 mm drills retained. Ordinary PTH contacts, not castellations. The previously reviewed JLC edge process required at least 0.6 mm thickness. [Header review](../../analysis/v1_1_release_20261012/headers/README.md).
- [x] **Improve U7 assembly.** Retain copper lands, 81% paste area, clear central underside and explicit GND routes with zone contact disabled on grounded lands. Specific STEVAL artwork was not retrieved; no exact evaluation-board equivalence is claimed. [Review](../../analysis/v1_1_release_20261012/identities/README.md).
- [x] **Reconcile identities, libraries and fabrication rules.** Correct shipped AI temperature grade, diode identities, 1 MΩ resistors, C5 polarity and U1 thermal-pad numbering. Freeze local footprints; enable edge/clearance/annular checks. [Identity review](../../analysis/v1_1_release_20261012/identities/README.md).
- [x] **Add charge-ceiling and active capacitor balancing circuit.** R1 7.50 MΩ, U8 TLV8801, R24/R25 4.75 MΩ, R26 22 Ω, C22 100 nF; C5 midpoint and feedback before R26. D3.1/J4.1 thermal overrides are 0.25 mm gap/bridge. Cold/stability qualification remains physical work. [Power review](../../analysis/v1_1_release_20261012/power/README.md).
- [x] **Resolve R4/U2 orderables.** R4 RC0402FR-073M65L C477700; U2 RAK3172-8-SM-NI C5452091. Retain lands and nets. [R4](../../analysis/v1_1_release_20261012/radio_sourcing/r4-equivalent.md), [U2](../../analysis/v1_1_release_20261012/radio_sourcing/README.md).
- [x] **Review retained supplier IC rotations.** U1/U2/U8 90°, U4 270°, U7 0°; U3 180°, U5 0°. These are CPL corrections only. U4's pressure port is not its pin-1 marker. [Evidence](../../analysis/v1_1_release_20261012/jlc/supplier-rotation-profile.json).

## Approved AS7331 revision and final release preparation

- [x] **Choose the UV circuit and pilot population.** AS7331-AQFM C20482877, address 0x74; U6 omitted only for the initial pilot. Populate C14/C23 100 nF and R27 MCU0805MD3304BP500 C4313228, 3.3 MΩ ±0.1% ±25 ppm/K. The full design remains ready for separately qualified U6 population. [Decision and circuit](../../analysis/v1_1_release_20261012/as7331/README.md).
- [ ] **Finish and promote the AS7331 layout.** U6/C14 move to **{{FINAL_UV_LOCATION}}**; add C23/R27 and reroute required local connections. Final routing/label changes: **{{FINAL_UV_ROUTING_AND_LABEL_SCOPE}}**. Retained-component moves must match the exact reviewed scope. Refill ground zones and review GNSS return/RF proximity, reference-node surface leakage, local bypasses and future optical access. Status: **{{FINAL_PROMOTION_STATUS}}**.
- [ ] **Complete final native and independent checks.** Remove the obsolete old-U6 corridor rule and grounded-INT ERC exception; retain only U5 ALERT / U7 SA0 exclusions. Verify the 16-pin symbol/footprint, source/library agreement, all retained nets and physical islands, local clearances, paste and assembly envelopes. Final DRC/ERC: **{{FINAL_DRC_RESULT}} / {{FINAL_ERC_RESULT}}**. Evidence: **{{FINAL_INDEPENDENT_REVIEW_LINK}}**.
- [x] **Provide an explicit U6-absent firmware target.** `stratolink_v1_1_uv_dnp` performs no optical I²C or waits, reports invalid UV/lux and inherits quiet microphone pins and v1.1 power metadata. Legacy v1.1 binary remains identical in before/after builds. This is not a populated-AS7331 driver or new qualification of all existing flight code. [Firmware verification](../../analysis/v1_1_release_20261012/as7331/firmware/README.md).
- [ ] **Generate and verify matching full-design/pilot evidence.** Identity-bound profile omits only U6 from BOM/CPL and its 16 stencil apertures; C14/C23/R27 stay fitted. Prove every retained field/aperture and source/output hash, including the paste inside the upload ZIP. Archive full-design paste separately. Counts: **{{FINAL_FULL_ASSEMBLY_COUNT}} full / {{FINAL_PILOT_ASSEMBLY_COUNT}} pilot references**, **{{FINAL_PILOT_PART_GROUPS}} groups**, **{{FINAL_EXCLUSION_COUNT}} exclusions**. [Verifier](../../analysis/v1_1_release_20261012/as7331/manufacturing/README.md).
- [ ] **Finish the JLC pilot preview, then add the reviewed draft to cart.** Upload the exact final ZIP/BOM/CPL, select the explicit U6-only DNP population, confirm R27/C23/C14 and all retained parts, and inspect top/bottom placements. Record green-mask/no-silkscreen CAM, thin-board handling, rail/mount clearances and assembly/stencil disposition with automatic change acceptance disabled. Supplier/cart status: **{{FINAL_JLC_SELECTION_STATUS}} / {{FINAL_CART_STATUS}}**. Evidence: **{{FINAL_JLC_EVIDENCE_LINK}}**. No checkout/payment is authorized.

## Physical pilot acceptance

Follow the [pilot acceptance procedure](../../analysis/v1_1_release_20261012/pilot-acceptance.md), recording conditions, measured values and pass/fail evidence. None of these is completed by DRC or a model.

- [ ] **Inspect before power.** Verify green mask, exposed soldering lands, absent silkscreen, handling, fine-pitch joints/shorts, exact identities, orientation and connectivity. Confirm U6 absent and C14/C23/R27 fitted. Hand-fit the flat capacitor after cleaning and check all three terminals.
- [ ] **Establish solar and storage bounds.** Measure cold panel Voc/I–V and BQ25570 input voltage/power. Measure charge plateau, both cells, midpoint startup/stability, cold ESR/leakage and load transients. Resolve charging faults and large steps before accepting the balancing circuit.
- [ ] **Verify dark endurance and sunrise recovery.** Use actual temperature and final assembly without debugger power. Measure residual GNSS current, brownout/reset and data recovery; nominal capacitor energy is not an all-night reserve.
- [ ] **Verify sensors and the pilot firmware.** Prove direct TMP117 ACK/ID/readings at 0x48 against a temperature reference. Confirm pressure, IMU, GNSS and unavailable UV/lux/acoustic reporting. Pressure fallback does not establish TMP117 operation. DNP firmware must issue no optical probes.
- [ ] **Qualify mounts and bridle.** Measure panel terminal thickness/wettable area, wire gauge, string material/diameter, apex height and total mass. Compare flex, rim wear and security with v1 under measured loads and cold/handling cycles; use sacrificial samples for uneven/out-of-plane loading.
- [ ] **Compare installed RF and GNSS behavior.** Record regional wire cut, exit and whole-payload geometry; compare orientation-dependent links, C/N₀, fix recovery and LoRa interference against v1. The new UV circuit warrants a matched full-assembly comparison even on DNP pilots. VNA match alone is insufficient.
- [ ] **Accept the three pilots before a larger batch.** Review failures, rework, measured margins and sustainable component supply before ordering approximately fifteen.

## Deferred v1.1 experiments and supply work

- [ ] **Source and bring up populated AS7331 boards.** Current shortage does not change the chosen complete circuit. Obtain the exact part through a verified route, review its own placement/stencil/MSL process, implement bounded command-mode acquisition and verified power-down, and version raw multiband telemetry. Do not reuse DNP firmware after fitting U6; AS7331 provides no visible ALS.
- [ ] **Characterize the UV experiment.** Measure dark offsets, gain/exposure, saturation, temperature, angular response and sunlight VIS/NIR leakage. Design an appropriate opaque angle-limiting collector and blocking filter as needed, then compare against calibrated spectra. Broad-band ratio alone is not accepted ozone metrology. [Requirements](../../analysis/v1_1_release_20261012/as7331/review/requirements.md).
- [ ] **Find a sustainable flat-capacitor replacement.** Preserve the current 30 × 14 × 3.7 mm rear envelope unless measurements justify a change. Compare price/stock, terminals, mass, tolerance, cold ESR/leakage and dark/recovery performance. Smaller 470 mF and wider HW203F candidates are tradeoffs, not equivalents. Local notes: `analysis/v1_1_layout_20261012/flat_storage/README.md`.
- [ ] **Resolve IMU idle current.** Verify LIS2DH12 SA0 pull-up control (`CTRL_REG0.SDO_PU_DISC`) in the selected firmware. The remaining grounded-strap ERC disposition does not establish minimum sleep current. The old LTR390 interrupt configuration no longer applies to this PCB.
- [ ] **Evaluate GNSS upgrades against measured benefit.** Keep MAX-M10S as baseline. Recheck exact MAX-M11N availability/firmware, pins 16/17 and true power isolation before raw-carrier work. Compare MAX-M10N navigation/coexistence with matched antennas and local radio activity. PPS/reset does not isolate power. Local notes: `analysis/v1_1_layout_20261012/gnss_uv/README.md`.
- [ ] **Qualify one-radio regional, wildlife and Meshtastic operation.** Measure the exact front end, antenna and compatible channel/preset windows. Regional labels do not prove 433 MHz sensitivity, and a wire change cannot bypass internal matching. One receiver cannot listen on all channels simultaneously. Local notes: `analysis/redesign_20261010/radio_mechanics/README.md`.

## v2 investigations

- [ ] **Repack a shorter, possibly thicker board.** Existing modeling adds about 0.50 g at 0.6 mm for the same outline. Equal mass needs about 40.9 mm length at current width under proportional copper scaling; retained envelopes span over 52 mm. Produce an actual fit before claiming parity; compare upper mounts, center of mass and RF. [Materials model](../../analysis/v1_1_solar_attachments_20261012/materials/README.md).
- [ ] **Improve ambient-air temperature measurement.** Test shielding, thermal isolation or a lightweight remote probe against references; separate chip accuracy from solar/conduction/low-pressure error.
- [ ] **Specify an identifiable atmospheric GNSS experiment.** Choose raw satellite observations or a separate coherent payload-to-ground instrument, with appropriate antennas, logging, clocks and references. Accurate position plus LoRa timestamps does not separately identify path temperature, pressure and humidity. Local notes: `analysis/redesign_20261010/metrology/README.md`.
- [ ] **Develop ozone optics from reference data.** Compare broad bands against narrower simultaneous absorption/reference bands or a spectrometer, including out-of-band leakage, pointing, clouds and aerosols. Validate column above the balloon, not local concentration.
- [ ] **Revise RF/power architecture only for measured needs.** A second receiver needs a demonstrated service benefit with acceptable mass/power/cost. Add true GNSS isolation, logging and qualified solar/storage when experiments define requirements.

Historical analysis retains intermediate states. Local working notes may sit outside the scoped release checkpoint; the final manufacturing package must remain reproducible from its own manifest.
