Stratolink-hq/Stratolink/analysis/v1_1_release_20261012/docs-draft/TODO.md

# Stratolink v1.1 and v2 checklist

Updated 2026-10-13. **Canonical pilot state:** integrated native and independent checks pass, the verified CAD is promoted, and the source-derived manufacturing package is generated. Supplier draft review and physical pilot qualification remain pending. The canonical project is `hardware/pcb` on `alpha/hardware-v1.1`. The user authorized a JLC draft for **five PCBs, three assembled**, with physical pilot qualification before the approximately fifteen-payload batch. Checkout/payment is not authorized.

The baseline keeps the 0.4 mm board, no solder mask on either face, one radio, precision temperature measurement, existing GNSS/pressure/UV/IMU parts and the flat on-hand capacitor. Both antennas are straight enameled copper wire. Science operates during measured daytime solar surplus; night means hibernation, with no radio or GNSS operation intended. The present hardware does not physically isolate every GNSS supply, so its actual night current remains a measurement item.

## v1.1 CAD and manufacturing preparation

The checked items describe completed design work, not proof that a manufactured pilot works.

- [x] **Repair the TMP117 ball map and routing.** A1 SDA, A2 SCL, B1 3.3 V, B2 GND, C1 GND for address 0x48, C2 unused ALERT grounded as TI permits. The exact shipped part is **TMP117AIYBGR C2871893**; older N-grade descriptions were wrong. [Pin-map repair](../../analysis/v1_1_implementation_20261012/README.md), [shipped identities](../../analysis/v1_1_release_20261012/identities/README.md).
- [x] **Remove the microphone.** MK1/R20/C13 and their dedicated routing/opening are removed. The `stratolink_v1_1` firmware environment leaves PB3/PB4 quiet and reports acoustic unavailable. [Implementation](../../analysis/v1_1_microphone_20261012/README.md).
- [x] **Add the side solar mounts and assembly models.** Two 1.0 × 2.0 mm open, unplated GND notches have lands on both faces; lower positive PTH pads carry formed return wires. Both panels remain parallel. Native 3D shows photo-scaled 94 × 75 mm panels, fillets and wires. Terminal thickness and joint strength are still unmeasured. [Geometry and models](../../analysis/v1_1_solar_attachments_20261012/qualification/README.md).
- [x] **Reinforce the suspension holes.** Two 2.0 mm plated holes with 3.2 mm GND rings retain the original centers and improve the substrate ligament. The model uses the actual triangular string bridle; it is not a breaking-load measurement. [Mechanics and checks](../../analysis/v1_1_suspension_20261012/README.md).
- [x] **Clean up zones, thermals, edge routes and the duplicate VSTOR stub.** Preserve the existing electrical functions and the proven wire-antenna feed positions. [Ground cleanup](../../analysis/v1_1_ground_20261012/README.md), [edge routes](../../analysis/v1_1_edges_20261012/README.md), [VSTOR and antenna assembly](../../analysis/v1_1_bare_finish_20261012/README.md).
- [x] **Specify no solder mask on either face.** Full-board mask openings expose the copper; vias are untented. Paste apertures remain selective. [Mask coverage](../../analysis/v1_1_bare_finish_20261012/mask/README.md).
- [x] **Promote the enlarged programming-header lands.** Reviewed rear lands are 1.20 × 0.88 mm with 0.12 mm inward offset; front lands, 0.50 mm holes and 1 mm pitch remain. Retain ordinary PTH construction: the sourced JLC edge-plating/castellation process requires at least 0.6 mm thickness. [Candidate and checks](../../analysis/v1_1_release_20261012/headers/README.md).
- [x] **Promote the U7 assembly correction.** Keep existing copper lands, reduce paste to 81% area, and clear top copper beneath the unsupported central body. The reviewed candidate has zero opens and preserves all retained pad connectivity. All grounded lands use explicit trace connections; pads 3/6 join 5/7/8 with zone connection disabled. Specific STEVAL artwork was not retrieved; do not claim exact evaluation-board equivalence. [Source review and candidate](../../analysis/v1_1_release_20261012/identities/README.md).
- [x] **Promote exact part/library identities and explicit fabrication rules.** Reconcile the shipped AI temperature grade, PESD5V0U1BB diodes, four 1 MΩ resistors, capacitor terminal polarity and U1 exposed-pad numbering. Freeze the placed footprints; enable clearance/edge/annular checks with named local constraints. Preserve the 0.15 mm general routing target and 0.20 mm routed-edge minimum. [Identity review](../../analysis/v1_1_release_20261012/identities/README.md), [integration status](../../analysis/v1_1_release_20261012/STATUS.md).
- [x] **Integrate the charge-ceiling and capacitor-balancing change.** The routed author candidate is frozen with R1 7.50 MΩ, TLV8801, two 4.75 MΩ resistors, 22 Ω isolation and 100 nF bypass. Preserve the five additions, midpoint connection and feedback before the resistor. The imported D3.1/J4.1 thermal overrides are limited to 0.25 mm gap/bridge and retain integrated J4 geometry; combined connectivity and clearances pass. The tolerance screen is not a cold qualification. [Power analysis](../../analysis/v1_1_release_20261012/power/README.md).
- [x] **Finish combined native checks and independent connectivity/geometry checks.** Final PCB `490af47d…` has zero opens/parity/library mismatches and four visible silk warnings. Filtered ERC is zero with exactly three documented inherited grounded-pin exclusions. All 232 retained pad islands/copper/drills are preserved, 13 pads are added, and all 233 schematic pin records match expected topology. The cleanup/refill comparison preserves authored geometry and filled polygons. The canonical PCB and native 3D viewer are reopened with unchanged hashes; supplier preview remains a separate check.
- [x] **Generate one matching manufacturing package.** Canonical-source Gerbers, drills, BOM and CPL are generated with 56 matching assembly references, 30 part groups and 10 exclusions. Retained placements match the shipped-order convention; the [package manifest](../gerbers/v1.1-pilot/manifest.json) records hashes. Exclude manual antenna/solar/header/capacitor/pogo assemblies and mounting hardware from automated population. [Export method](../../analysis/v1_1_release_20261012/manufacturing/README.md).
- [ ] **Complete JLC draft review.** The final ZIP is uploaded with five boards/three assembled, 0.4 mm ENIG, untented vias, and manual CAM/placement confirmation configured. Finish no-mask CAM acceptance, two-sided assembly, factory-rail/mount clearance, part allocation and placement review with automatic acceptance disabled. Review every selected part and the final placement preview. Final BOM/CPL imports into the actual three-board assembly flow: 56 detected, 53 confirmed, three shortages. R4 needs 20 with stock 0; U2 needs 3 with stock 1; U6 needs 3 with stock 0. R6 is confirmed with its 20-piece feeder allowance available. Resolve these three shortages without silent substitutions, then finish placement and CAM review. Checkout/payment remains outside this draft task.

## Physical pilot acceptance

Use the [pilot acceptance procedure](../../analysis/v1_1_release_20261012/pilot-acceptance.md) to record values, conditions and pass/fail evidence. None of these tests is completed by a CAD model or DRC result.

- [ ] **Inspect before power.** Check no-mask finish, thin-board handling, solder joints, fine-pitch shorts, correct orderables/orientation and unpowered connectivity. Hand-fit the flat capacitor after reflow and cleaning, with its outer polarity and center connection checked.
- [ ] **Establish safe solar and storage limits.** Measure actual cold panel Voc/I–V and BQ25570 input voltage/power; its recommended input limits remain unresolved. Measure charge plateau, both capacitor cells, midpoint stability, startup, leakage, cold ESR and radio-load transients. Review charging faults and large-load step behavior before accepting the balancing circuit.
- [ ] **Verify dark endurance and sunrise recovery.** Use debugger-free tests, actual temperature and full assembly. Measure residual GNSS current, reset/brownout behavior and stored-data recovery. Do not infer an all-night reserve from nominal capacitor energy.
- [ ] **Verify sensors and the matching firmware.** Demonstrate TMP117 ACK at 0x48, device ID and independent readings, then compare against a reference over cold starts and measurement temperatures. Confirm pressure, UV, IMU, GNSS and unavailable acoustic reporting. Pressure-sensor fallback is not evidence that TMP117 works.
- [ ] **Qualify the solar joints and bridle.** Record panel terminal thickness/wettable area, wire gauge, string material/diameter, bridle apex height and total mass. Compare flex, wear and joint security with v1 under measured loads and cold/handling cycles; use sacrificial samples for uneven or out-of-plane loading.
- [ ] **Compare installed RF and GNSS performance.** Record the exact regional wire cut, solder exit and payload geometry. Compare orientation-dependent links, GNSS C/N₀/fix recovery and local-transmit interference with v1 using the same settings. A VNA match alone is insufficient.
- [ ] **Accept the three pilots before the larger batch.** Record failures, rework and measured margins. Order approximately fifteen only after reviewing those results and a sustainable component supply plan.

## Deferred v1.1 experiments and supply work

- [ ] **Find a sustainable flat-capacitor replacement.** Preserve the current 30 × 14 × 3.7 mm rear envelope unless a measured improvement justifies change. Compare actual price/stock, terminal geometry, mass, capacitance tolerance, cold ESR/leakage and dark/recovery performance. Smaller 470 mF and wider HW203F candidates are tradeoffs, not equivalent replacements. [Storage review](../../analysis/v1_1_layout_20261012/flat_storage/README.md).
- [ ] **Resolve inherited IMU idle-current details.** Confirm LIS2DH12 SA0 pull-up handling (`CTRL_REG0.SDO_PU_DISC`) and the unused LTR390 interrupt configuration in the selected firmware. Hardware ERC exclusions document inherited connections; they do not prove the lowest sleep current.
- [ ] **Evaluate GNSS upgrades only against measured benefits.** Keep MAX-M10S as baseline. Recheck availability and exact firmware of MAX-M11N before a raw-carrier experiment; review pins 16/17 and actual power isolation. Compare MAX-M10N navigation/coexistence only under matched antennas and local LoRa activity. PPS access or reset alone does not provide supply isolation. [GNSS review](../../analysis/v1_1_layout_20261012/gnss_uv/README.md).
- [ ] **Prototype an AS7331 UV reference separately.** Measure UVA/UVB/UVC dark offsets, saturation, temperature and angular response against calibrated spectra. A broad-band ratio alone is not an accepted ozone retrieval. [UV review](../../analysis/v1_1_layout_20261012/gnss_uv/README.md).
- [ ] **Qualify one-radio regional, wildlife and Meshtastic operation.** Measure the exact module front end, antenna and compatible channel/preset windows. Distinguish EU868/IN865 from 915/923 MHz choices. A wire change cannot bypass internal matching; one receiver cannot listen on all frequencies simultaneously. [Radio review](../../analysis/redesign_20261010/radio_mechanics/README.md).

## v2 investigations

- [ ] **Repack a shorter, potentially thicker board.** The same outline at 0.6 mm adds approximately 0.50 g in the existing model. Equal mass would require about 40.9 mm length at current width under proportional copper scaling, while retained component envelopes span over 52 mm. Produce an actual fit before claiming parity; compare upper panel mounts, center of mass and RF effects. [Materials model](../../analysis/v1_1_solar_attachments_20261012/materials/README.md).
- [ ] **Improve ambient-air temperature measurement.** Evaluate radiation shielding, thermal isolation and a remote lightweight probe against independent references. Separate chip accuracy from solar/conduction/low-pressure response errors.
- [ ] **Design an identifiable atmospheric GNSS experiment.** Select raw satellite observations or a separate coherent payload-to-ground instrument; specify antenna, logging, clocks and independent atmospheric references. Accurate position and LoRa packet timestamps alone do not resolve separate path temperature, pressure and humidity. [Metrology study](../../analysis/redesign_20261010/metrology/README.md).
- [ ] **Develop ozone optics after reference measurements.** Compare broad bands with simultaneous narrower absorption/reference bands or a spectrometer, including out-of-band leakage and pointing/cloud/aerosol effects. Validate column above the balloon; do not relabel it local concentration.
- [ ] **Change RF and power architecture only from measured need.** A second receiver needs demonstrated wildlife/service benefit and accepted mass/power/cost. Integrate true GNSS isolation, logging and a qualified storage/solar solution when experiments establish their requirements.

Historical analysis remains available under `analysis/`. Intermediate mask choices, old component labels and earlier DRC counts do not describe the final pilot release.
