Stratolink-hq/Stratolink/analysis/v1_1_release_20261012/as7331/cad/schematic.pdf

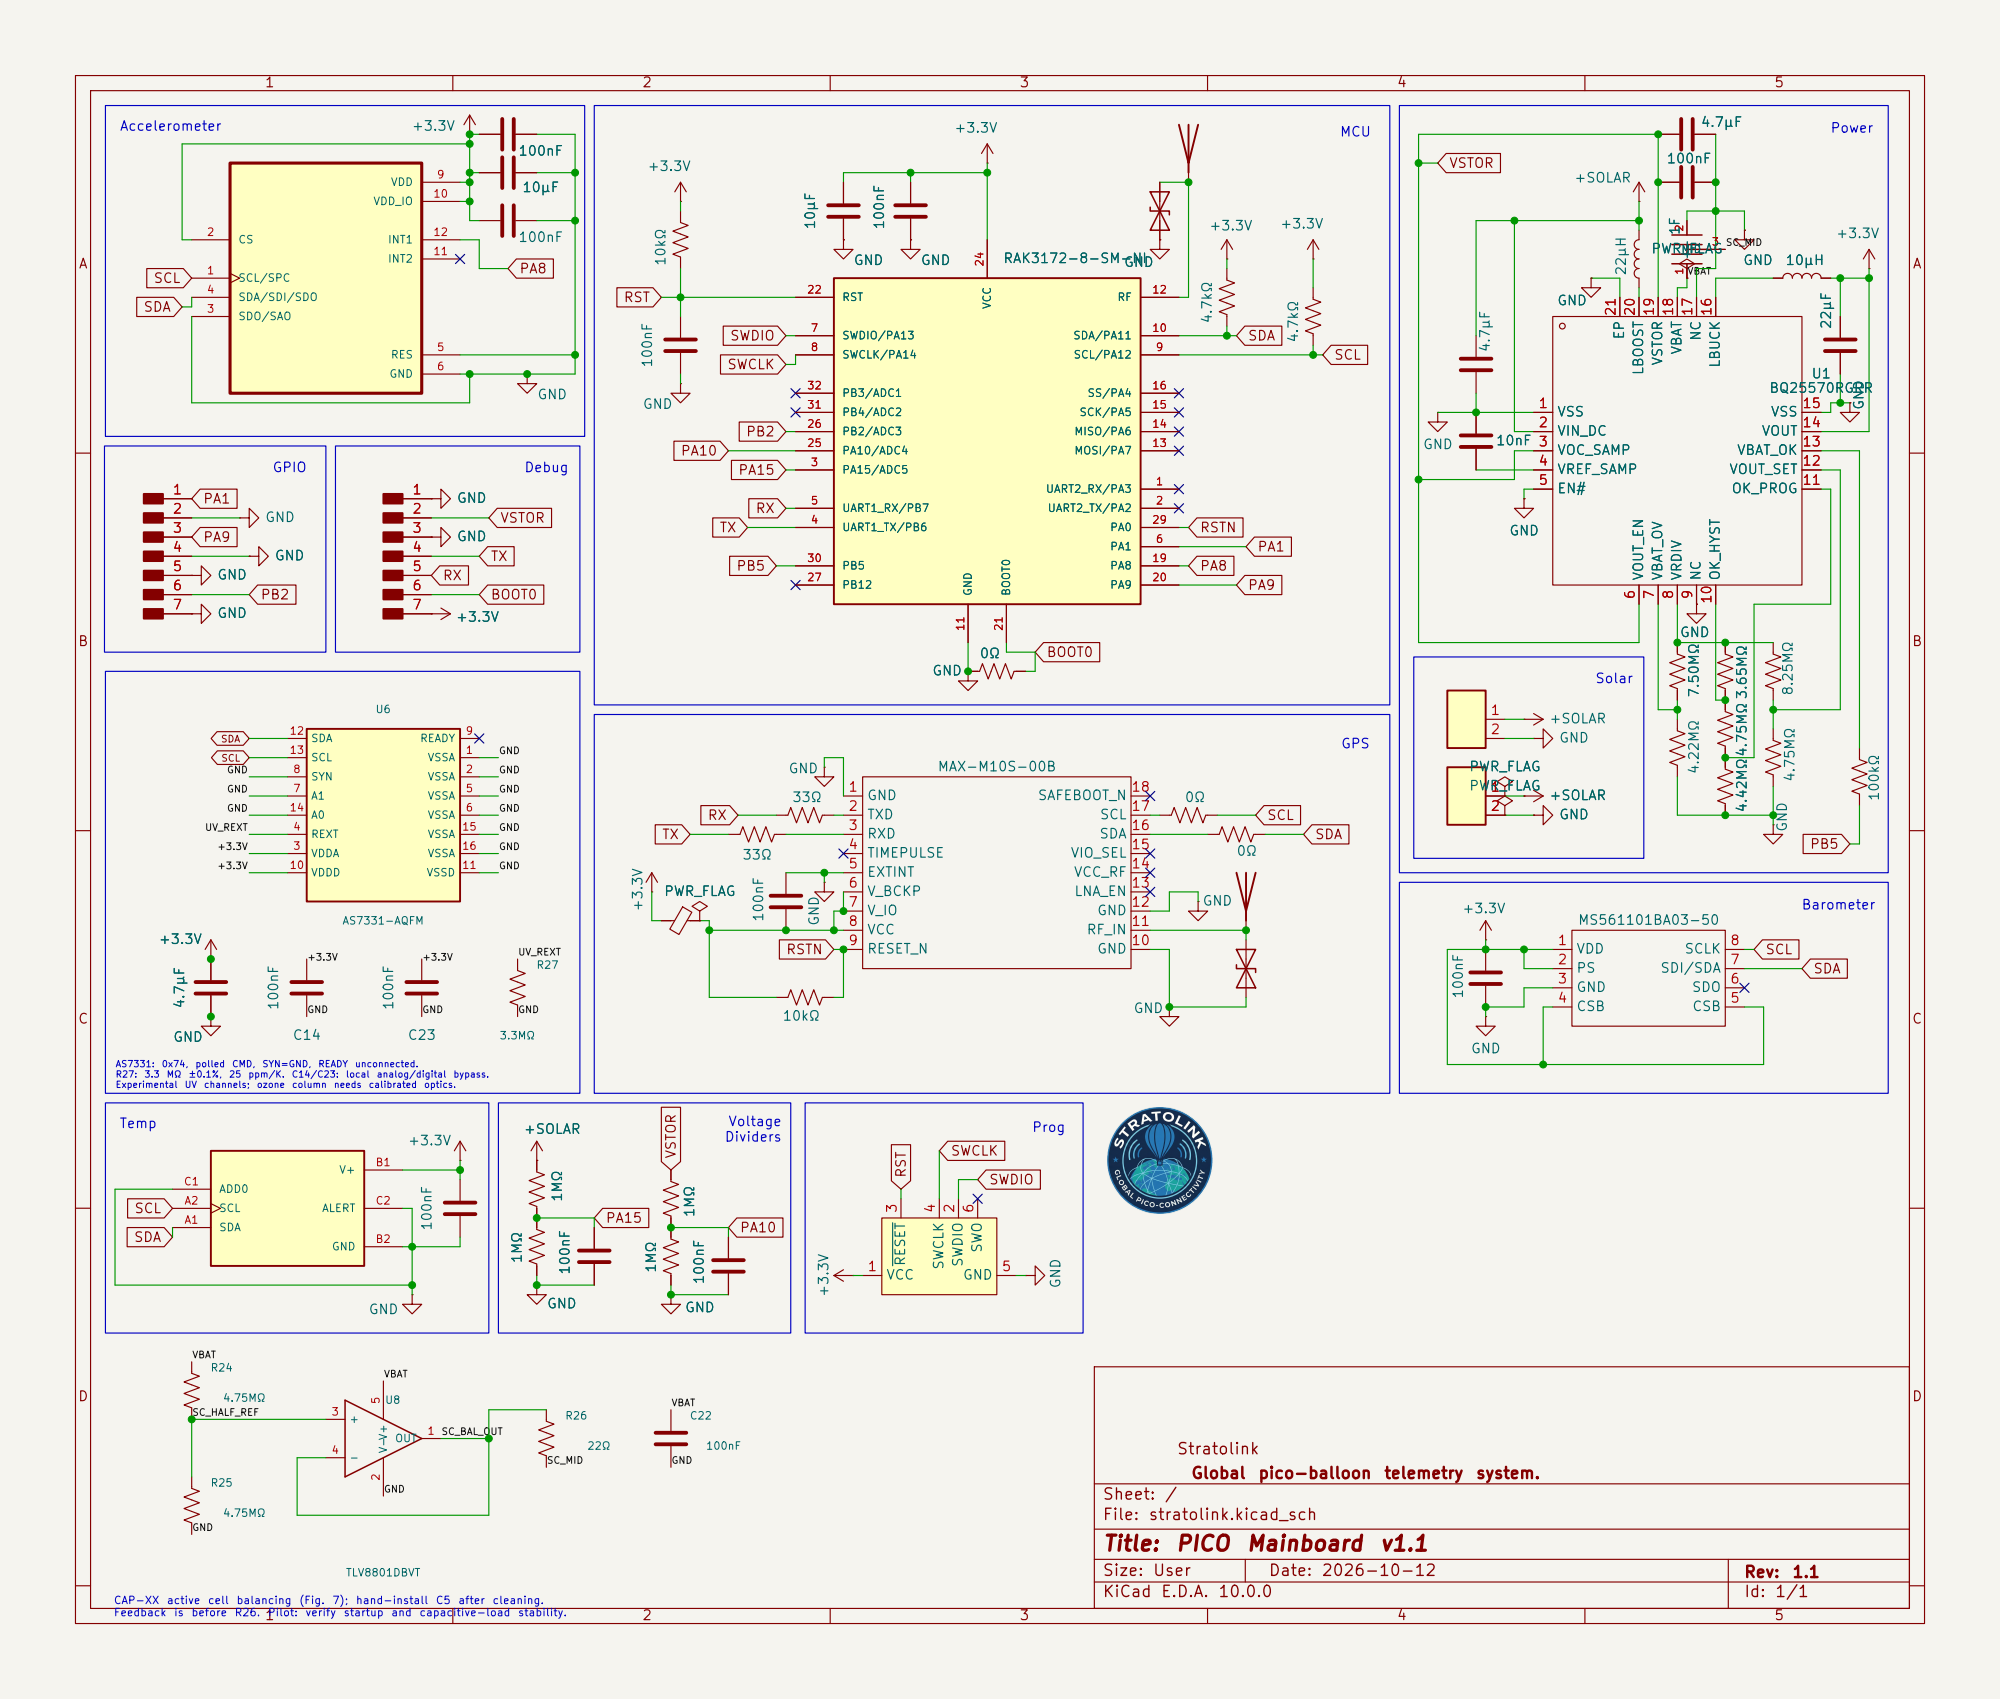
[picture p141: page 1]

9 OK_HYST 10 OK_PROG 11 VOUT_SET 12 VBAT_OK 13 VOUT 14 VSS 15 LBUCK 16 NC 17 VBAT 18 VSTOR 19 LBOOST 20 EP 21 U1 BQ25570RGRR +3.3V PWR_FLAG 4.42MΩ4.22MΩ 3.65MΩ 4.75MΩ 100kΩ

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

Global pico-balloon telemetry system. Stratolink +3.3V

Size: User | Rev: 1.1
