Stratolink-hq/Stratolink/analysis/v1_1_peer_review_20261014/fabrication/candidate/before-after.pdf

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

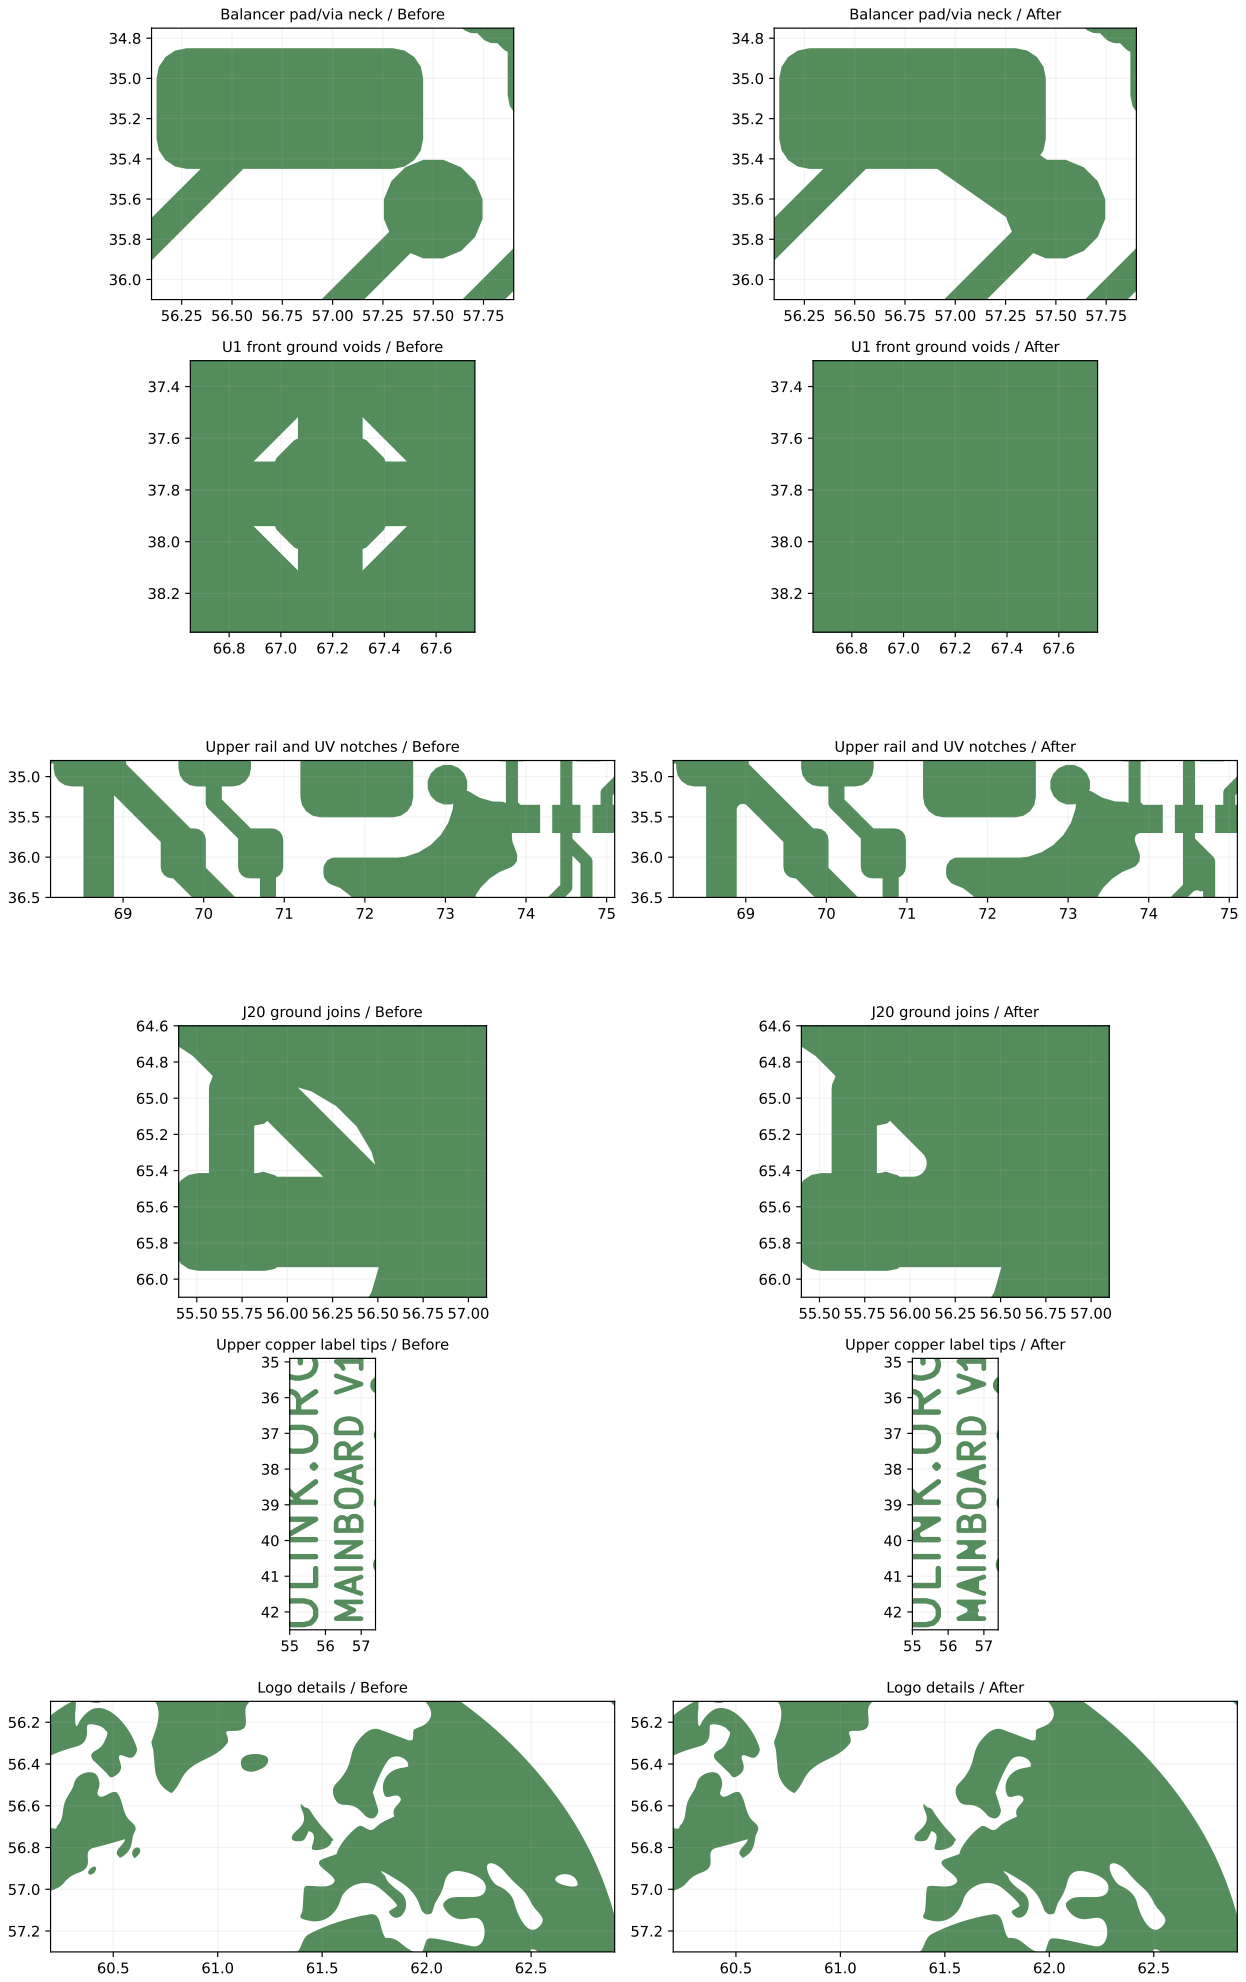
[picture p142: page 1]
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
