Stratolink-hq/Stratolink/hardware/pcb/stratolink.kicad_pcb

## KiCad design hardware/pcb/stratolink.kicad_pcb (2026-11-08)

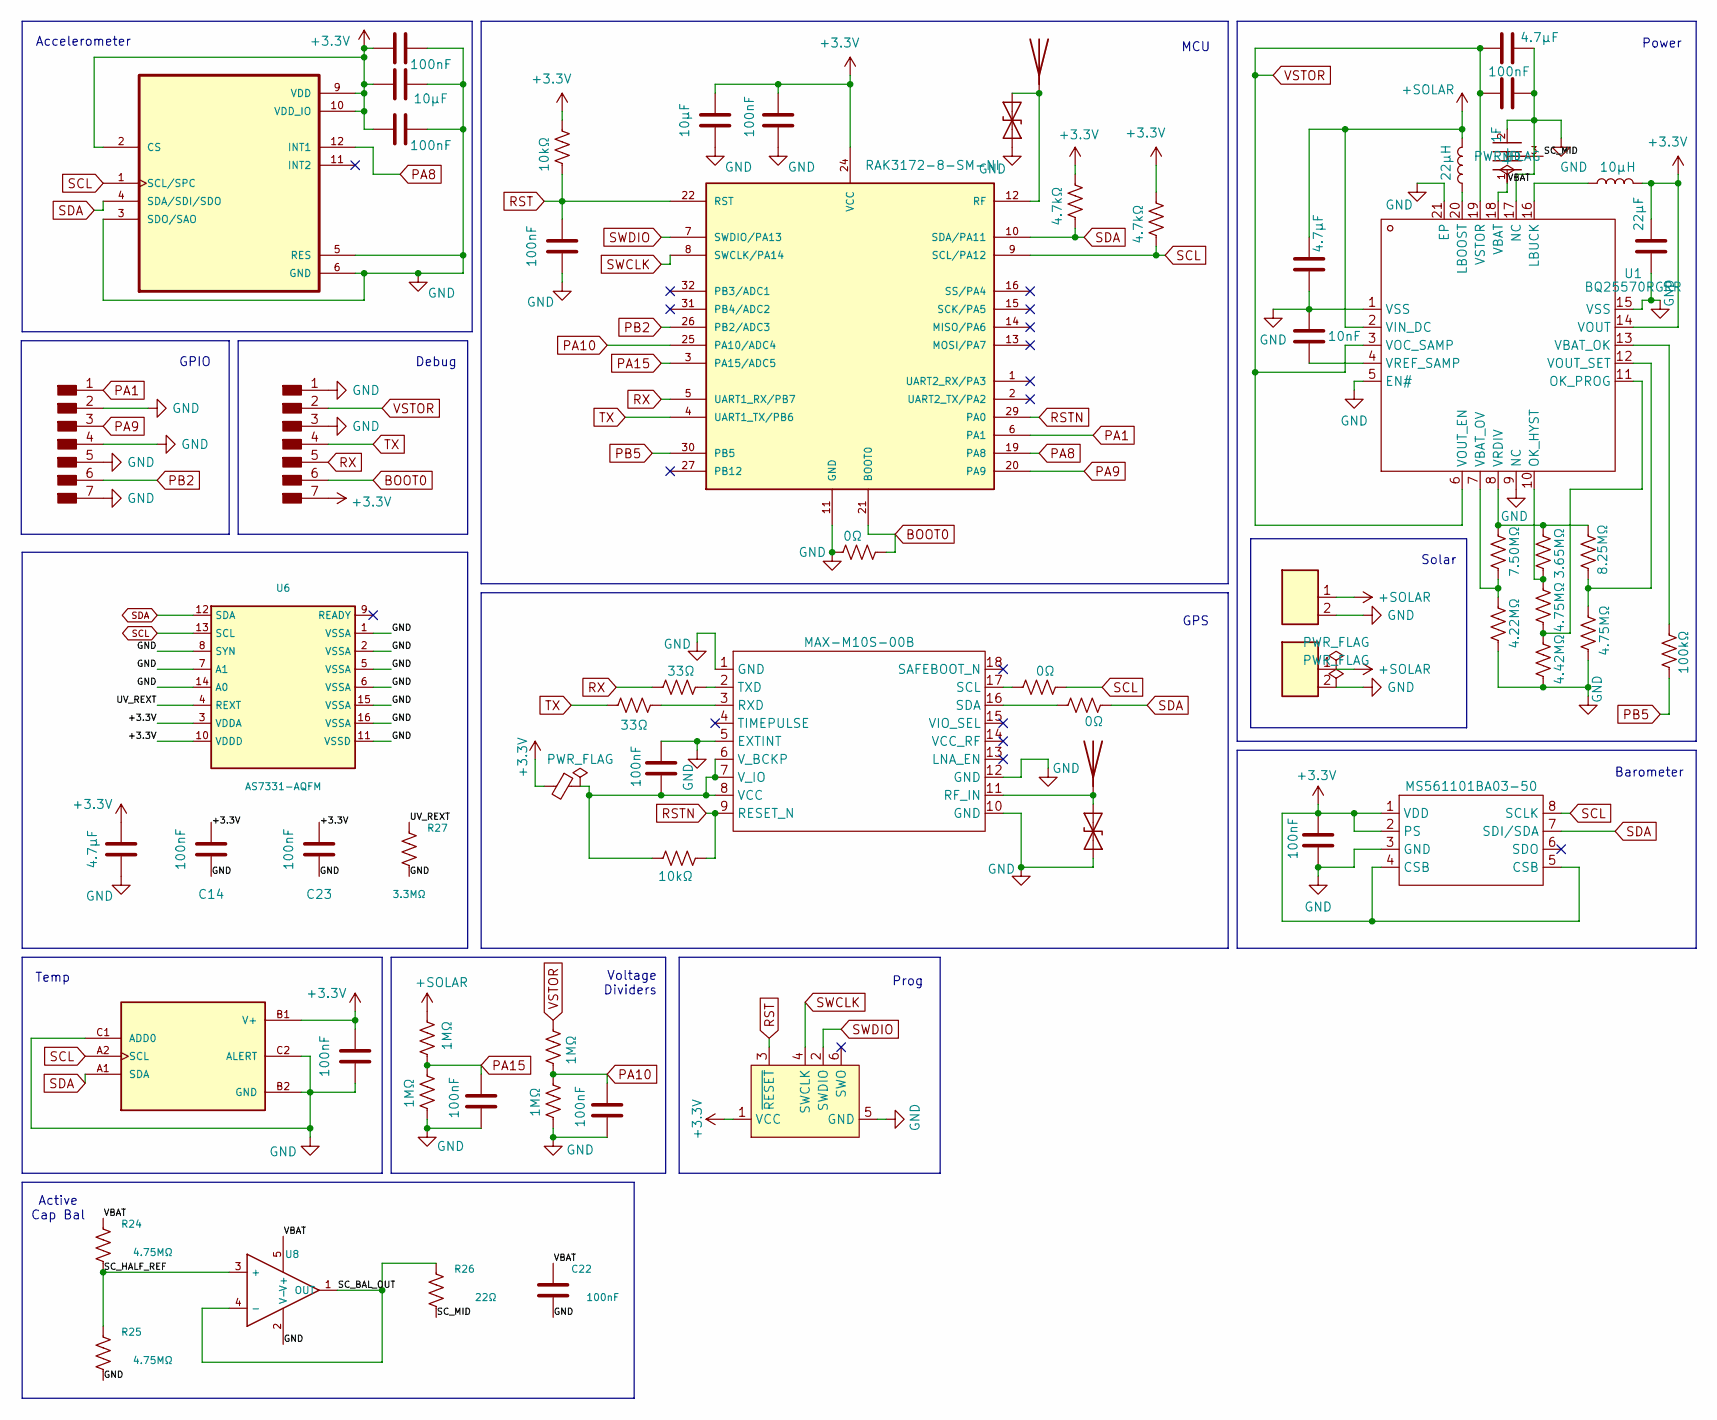
[picture p143: schematic stratolink.kicad_sch, PICO Mainboard v1.1]

Parts:
AE1: Enameled Cu wire 82mm (915MHz reference); Stratolink_LoRa_Wire_PTH_D1p0
AE2: Enameled Cu wire 48mm (GNSS L1); Stratolink_GNSS_Wire_PTH_D1p0
C1: 10nF; Stratolink_v1p1_C1_C_0402_1005Metric; Manufacturer_Part_Number GRM1555C1E103JE01D; LCSC C3855387
C2: 4.7μF; Stratolink_v1p1_C2_C_0603_1608Metric; Manufacturer_Part_Number CL10A475KP8NNNC; LCSC C1705
C3: 4.7μF; Stratolink_v1p1_C3_C_0603_1608Metric; Manufacturer_Part_Number CL10A475KP8NNNC; LCSC C1705
C4: 100nF; Stratolink_v1p1_C4_C_0402_1005Metric; Manufacturer_Part_Number CL05B104KO5NNNC; LCSC C1525
C5: 1F; Stratolink_v1p1_C5_DMF4B5R5G105M3DTA0; Manufacturer_Part_Number DMF4B5R5G105M3DTA0
C6: 22µF; Stratolink_v1p1_C6_C_0805_2012Metric; Manufacturer_Part_Number CL21A226MAYNNNE; LCSC C602037
C7: 100nF; Stratolink_v1p1_C7_C_0402_1005Metric; Manufacturer_Part_Number CL05B104KO5NNNC; LCSC C1525
C8: 10μF; Stratolink_v1p1_C8_C_0603_1608Metric; Manufacturer_Part_Number CL10A106KP8NNNC; LCSC C19702
C9: 100nF; Stratolink_v1p1_C9_C_0402_1005Metric; Manufacturer_Part_Number CL05B104KO5NNNC; LCSC C1525
C10: 100nF; Stratolink_v1p1_C10_C_0402_1005Metric; Manufacturer_Part_Number CL05B104KO5NNNC; LCSC C1525
C11: 100nF; Stratolink_v1p1_C11_C_0402_1005Metric; Manufacturer_Part_Number CL05B104KO5NNNC; LCSC C1525
C12: 100nF; Stratolink_v1p1_C12_C_0402_1005Metric; Manufacturer_Part_Number CL05B104KO5NNNC; LCSC C1525
C14: 100nF; Stratolink_v1p1_C14_C_0402_1005Metric; Manufacturer_Part_Number CL05B104KO5NNNC; LCSC C1525
C15: 100nF; Stratolink_v1p1_C15_C_0402_1005Metric; Manufacturer_Part_Number CL05B104KO5NNNC; LCSC C1525
C16: 4.7μF; Stratolink_v1p1_C16_C_0603_1608Metric; Manufacturer_Part_Number CL10A475KP8NNNC; LCSC C1705
C17: 100nF; Stratolink_v1p1_C17_C_0402_1005Metric; Manufacturer_Part_Number CL05B104KO5NNNC; LCSC C1525
C19: 100nF; Stratolink_v1p1_C19_C_0402_1005Metric; Manufacturer_Part_Number CL05B104KO5NNNC; LCSC C1525
C20: 100nF; Stratolink_v1p1_C20_C_0402_1005Metric; Manufacturer_Part_Number CL05B104KO5NNNC; LCSC C1525
C21: 10μF; Stratolink_v1p1_C21_C_0603_1608Metric; Manufacturer_Part_Number CL10A106KP8NNNC; LCSC C19702
C22: 100nF; Stratolink_v1p1_C22_C_0402_1005Metric; MPN CL05B104KO5NNNC; LCSC Part # C1525
C23: 100nF; Stratolink_v1p1_C23_C_0402_1005Metric; Manufacturer_Part_Number CL05B104KO5NNNC; LCSC C1525
D1: PESD5V0U1BB; Stratolink_v1p1_D1_D_SOD-523; Manufacturer_Part_Number PESD5V0U1BB; LCSC C5272735
D3: PESD5V0U1BB; Stratolink_v1p1_D3_D_SOD-523; Manufacturer_Part_Number PESD5V0U1BB; LCSC C5272735
FB1: BLM15AG601SN1D; Stratolink_v1p1_FB1_C_0402_1005Metric; Manufacturer_Part_Number BLM15AG601SN1D; LCSC C76884
J1: Solar panel direct solder; Solar_Notch_Right_1p0x2p0
J2: Solar panel direct solder; Solar_Notch_Left_1p0x2p0
J3: Programming_1x07_P1.00mm_D0.50mm; Stratolink_Programming_Left_1x07_P1p00_D0p50_BackTack1p20x0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
J4: Programming_1x07_P1.00mm_D0.50mm; Stratolink_v1p1_J4_Stratolink_Programming_Right_1x07_P1p00_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
J20: Conn_ARM_SWD_TagConnect_TC2030-NL; Stratolink_v1p1_J20_Tag-Connect_TC2030-IDC-NL_2x03_P1.27mm_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
L1: 22µH; Stratolink_v1p1_L1_IND_LPS4018-223MRC; Manufacturer_Part_Number LPS4018-223MRC; LCSC C5278935
L2: 10µH; INDC1608X90N; Manufacturer_Part_Number PWCWAQ1608F-100KTT; LCSC C436784
R1: 7.50MΩ; Stratolink_v1p1_R1_R_0402_1005Metric; Manufacturer_Part_Number 0402WGF7504TCE; LCSC C423135
R2: 4.22MΩ; Stratolink_v1p1_R2_R_0402_1005Metric; Manufacturer_Part_Number CRCW04024M22FKED; LCSC C2091474
R3: 4.75MΩ; Stratolink_v1p1_R3_R_0402_1005Metric; Manufacturer_Part_Number FRC0402F4754TS; LCSC C2998153
R4: 3.65MΩ; Stratolink_v1p1_R4_R_0402_1005Metric; Manufacturer_Part_Number RC0402FR-073M65L; LCSC C477700
R5: 4.42MΩ; Stratolink_v1p1_R5_R_0402_1005Metric; Manufacturer_Part_Number GR0402F4M42TAG00; LCSC C49654874
R6: 8.25MΩ; Stratolink_v1p1_R6_R_0402_1005Metric; Manufacturer_Part_Number 0402WGF8254TCE; LCSC C423131
R7: 4.75MΩ; Stratolink_v1p1_R7_R_0402_1005Metric; Manufacturer_Part_Number FRC0402F4754TS; LCSC C2998153
R8: 100kΩ; Stratolink_v1p1_R8_R_0402_1005Metric; Manufacturer_Part_Number RC0402FR-07100KL; LCSC C60491
R9: 0Ω; Stratolink_v1p1_R9_R_0402_1005Metric; Manufacturer_Part_Number RC0402FR-070RL; LCSC C106231
R10: 10kΩ; Stratolink_v1p1_R10_R_0402_1005Metric; Manufacturer_Part_Number RC0402FR-0710KL; LCSC C60490
R11: 4.7kΩ; Stratolink_v1p1_R11_R_0402_1005Metric; Manufacturer_Part_Number RC0402FR-074K7L; LCSC C105871
R12: 4.7kΩ; Stratolink_v1p1_R12_R_0402_1005Metric; Manufacturer_Part_Number RC0402FR-074K7L; LCSC C105871
R13: 0Ω; Stratolink_v1p1_R13_R_0402_1005Metric; Manufacturer_Part_Number RC0402FR-070RL; LCSC C106231
R14: 0Ω; Stratolink_v1p1_R14_R_0402_1005Metric; Manufacturer_Part_Number RC0402FR-070RL; LCSC C106231
R15: 33Ω; Stratolink_v1p1_R15_R_0402_1005Metric; Manufacturer_Part_Number RC0402FR-0733RL; LCSC C138002
R16: 33Ω; Stratolink_v1p1_R16_R_0402_1005Metric; Manufacturer_Part_Number RC0402FR-0733RL; LCSC C138002
R18: 10kΩ; Stratolink_v1p1_R18_R_0402_1005Metric; Manufacturer_Part_Number RC0402FR-0710KL; LCSC C60490
R19: 1MΩ; Stratolink_v1p1_R19_R_0402_1005Metric; Manufacturer_Part_Number RC0402FR-071ML; LCSC C138033
R21: 1MΩ; Stratolink_v1p1_R21_R_0402_1005Metric; Manufacturer_Part_Number RC0402FR-071ML; LCSC C138033
R22: 1MΩ; Stratolink_v1p1_R22_R_0402_1005Metric; Manufacturer_Part_Number RC0402FR-071ML; LCSC C138033
R23: 1MΩ; Stratolink_v1p1_R23_R_0402_1005Metric; Manufacturer_Part_Number RC0402FR-071ML; LCSC C138033
R24: 4.75MΩ; Stratolink_v1p1_R24_R_0402_1005Metric; MPN FRC0402F4754TS; LCSC Part # C2998153
R25: 4.75MΩ; Stratolink_v1p1_R25_R_0402_1005Metric; MPN FRC0402F4754TS; LCSC Part # C2998153
R26: 22Ω; Stratolink_v1p1_R26_R_0402_1005Metric; MPN 0402WGF220JTCE; LCSC Part # C25092
R27: 3.3MΩ; Stratolink_v1p1_R27_R_0805_2012Metric; MPN MCU0805MD3304BP500; LCSC Part # C4313228
U1: BQ25570RGRR; Stratolink_v1p1_U1_QFN50P350X350X100-21N; Manufacturer Part BQ25570RGRR; LCSC Part Name 适用于能量收集器供电应用的微功率升压充电器与降压转换器
U2: RAK3172-8-SM-NI; Stratolink_v1p1_U2_RAK3172; Manufacturer_Part_Number RAK3172-8-SM-NI; LCSC C5452091
U3: MAX-M10S-00B; Stratolink_v1p1_U3_XCVR_MAX-M10S-00B; Manufacturer Part MAX-M10S-00B; LCSC Part Name MAX-M10S-00B
U4: MS561101BA03-50; Stratolink_v1p1_U4_SON125P500X300X100-8N; Manufacturer Part MS561101BA03-50; LCSC Part Name MS561101BA03-50
U5: TMP117AIYBGR; Stratolink_v1p1_U5_BGA6N40P3X2_148X95X53; PARTREV D; LCSC C2871893
U6: AS7331-AQFM; Stratolink_v1p1_U6_AS7331_OLGA16; Manufacturer_Part_Number AS7331-AQFM; LCSC C20482877
U7: LIS2DH12TR; Stratolink_v1p1_U7_PQFN50P200X200100-12N; Manufacturer_Part_Number LIS2DH12TR; LCSC C110926
U8: TLV8801DBVT; Stratolink_v1p1_U8_SOT-23-5; MPN TLV8801DBVT; LCSC Part # C544879

Connections:
+3.3V: C6.2, C7.2, C8.2, C11.2, C12.2, C14.2, C16.2, C19.2, C20.2, C21.2, C23.2, FB1.2, J4.7, J20.1 (VCC), L2.2, R10.1, R11.1, R12.1, U1.14 (VOUT), U2.24 (VCC), U4.1 (VDD), U4.2 (PS), U4.4 (CSB), U4.5 (CSB), U5.B1 (V+), U6.3 (VDDA), U6.10 (VDDD), U7.2 (CS), U7.9 (VDD), U7.10 (VDD_IO)
+SOLAR: C2.1, J1.1, J2.1, L1.2, R19.1, U1.2 (VIN_DC)
/SC_BAL_OUT: R26.1, U8.1 (OUT), U8.4 (-)
/SC_HALF_REF: R24.2, R25.1, U8.3 (+)
/SC_MID: C5.3 (MID), R26.2
/UV_REXT: R27.1, U6.4 (REXT)
/VBAT: C5.1 (+), C22.1, R24.1, U1.18 (VBAT), U8.5 (V+)
BOOT0: J4.6, R9.2, U2.21 (BOOT0)
GND: C1.1, C2.2, C3.2, C4.2, C5.2 (-), C6.1, C7.1, C8.1, C9.1, C10.2, C11.1, C12.1, C14.1, C15.1, C16.1, C17.1, C19.1, C20.1, C21.1, C22.2, C23.1, D1.1 (A1), D3.1 (A1), J1.2, J2.2, J3.2, J3.4, J3.5, J3.7, J4.1, J4.3, J20.5 (GND), R2.2, R5.2, R7.2, R9.1, R21.2, R23.2, R25.2, R27.2, U1.1 (VSS), U1.5 (EN#), U1.9 (NC), U1.15 (VSS), U1.17 (NC), U1.21 (EP), U2.11 (GND), U2.17 (GND), U2.18 (GND), U2.23 (GND), U2.28 (GND), U3.1 (GND), U3.5 (EXTINT), U3.10 (GND), U3.12 (GND), U4.3 (GND), U5.B2 (GND), U5.C1 (ADD0), U5.C2 (ALERT), U6.1 (VSSA), U6.2 (VSSA), U6.5 (VSSA), U6.6 (VSSA), U6.7 (A1), U6.8 (SYN), U6.11 (VSSD), U6.14 (A0), U6.15 (VSSA), U6.16 (VSSA), U7.3 (SDO/SAO), U7.5 (RES), U7.6 (GND), U7.7 (GND), U7.8 (GND), U8.2 (V-); also elsewhere on the board
unnamed: AE1.1 (A_1), D1.2 (A2), U2.12 (RF)
unnamed: AE2.1 (A_1), D3.2 (A2), U3.11 (RF_IN)
unnamed: L1.1, U1.20 (LBOOST)
unnamed: L2.1, U1.16 (LBUCK)
unnamed: R3.1, R4.2, U1.10 (OK_HYST)
unnamed: R3.2, R5.1, U1.11 (OK_PROG)
unnamed: R8.1, U1.13 (VBAT_OK)
unnamed: R1.2, R2.1, U1.7 (VBAT_OV)
unnamed: R6.2, R7.1, U1.12 (VOUT_SET)
unnamed: R1.1, R4.1, R6.1, U1.8 (VRDIV)
unnamed: C1.2, U1.4 (VREF_SAMP)
unnamed: R16.2, U3.3 (RXD)
unnamed: R13.1, U3.17 (SCL)
unnamed: R14.1, U3.16 (SDA)
unnamed: R15.2, U3.2 (TXD)
unnamed: C10.1, FB1.1, R18.1, U3.6 (V_BCKP), U3.7 (V_IO), U3.8 (VCC)
PA1: J3.1, U2.6 (PA1)
PA8: U2.19 (PA8), U7.12 (INT1)
PA9: J3.3, U2.20 (PA9)
PA10: C17.2, R22.2, R23.1, U2.25 (PA10/ADC4)
PA15: C15.2, R19.2, R21.1, U2.3 (PA15/ADC5)
PB2: J3.6, U2.26 (PB2/ADC3)
PB5: R8.2, U2.30 (PB5)
RST: C9.2, J20.3 (~RESET), R10.2, U2.22 (RST)
RSTN: R18.2, U2.29 (PA0), U3.9 (RESET_N)
RX: J4.5, R15.1, U2.5 (UART1_RX/PB7)
SCL: R12.2, R13.2, U2.9 (SCL/PA12), U4.8 (SCLK), U5.A2 (SCL), U6.13 (SCL), U7.1 (SCL/SPC)
SDA: R11.2, R14.2, U2.10 (SDA/PA11), U4.7 (SDI/SDA), U5.A1 (SDA), U6.12 (SDA), U7.4 (SDA/SDI/SDO)
SWCLK: J20.4 (SWCLK), U2.8 (SWCLK/PA14)
SWDIO: J20.2 (SWDIO), U2.7 (SWDIO/PA13)
TX: J4.4, R16.1, U2.4 (UART1_TX/PB6)
VSTOR: C3.1, C4.1, J4.2, R22.1, U1.3 (VOC_SAMP), U1.6 (VOUT_EN), U1.19 (VSTOR)

Notes on the sheet:
GPS
Active Cap Bal
Prog
Solar
MCU
Debug
Power
Barometer
GPIO
Temp
Voltage Dividers
Accelerometer

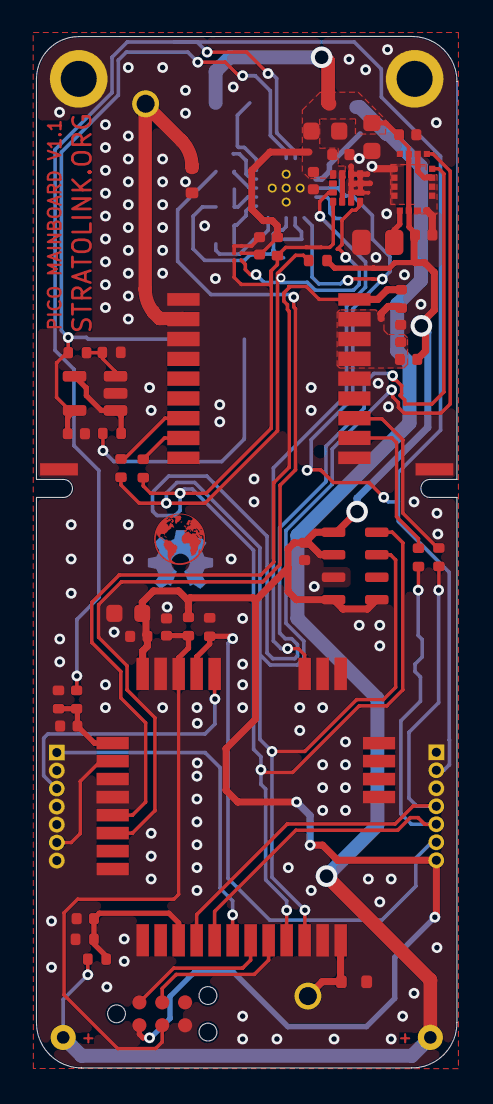
[picture p144: board stratolink.kicad_pcb from above]

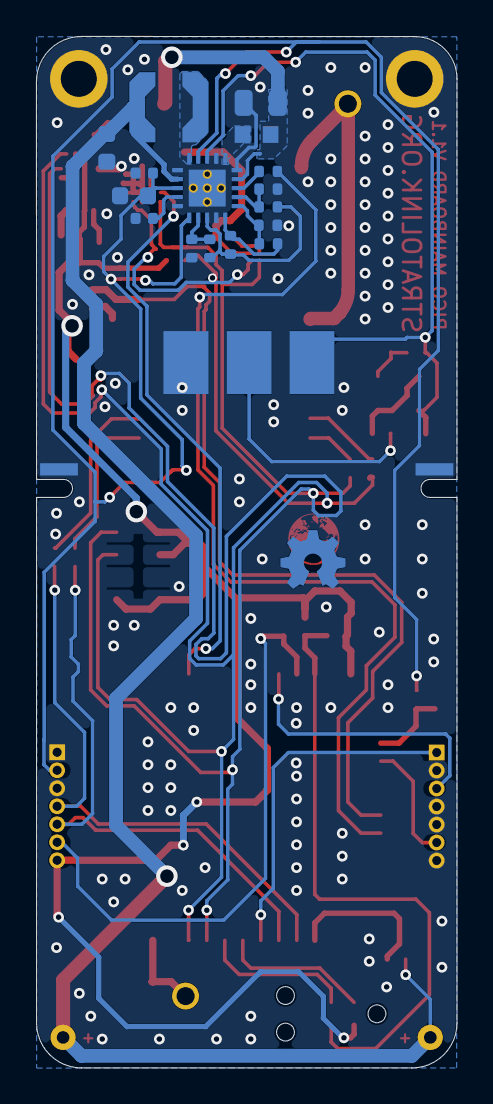
[picture p145: board stratolink.kicad_pcb from below]

Board: 2 copper layers, 23.4 x 57.3 mm, 68 parts (17 on the bottom side), 41 nets.

Other parts of the board:
H1, H2: Suspension 2.0 mm PTH; Suspension_PTH_D2p0_OD3p2

Their connections:
GND: H1.1, H2.1; also elsewhere on the board
