Stratolink-hq/Stratolink/(commit log)

2026-10-12 hardware: start v1.1 with corrected TMP117 symbol and routing
    Use hardware/pcb as the canonical working project. Preserve component placement, correct the DSBGA ball map and local copper, add the v1.1/v2 checklist and canonical-path verification records. PCB saved in KiCad 10 format.
2026-10-12 hardware: add v1.1 side solar solder mounts
2026-10-12 hardware: visualize solar panels and leads in KiCad
2026-10-12 Refine solar notches and scale assembly from ZachTek photo
2026-10-12 Improve suspension corners with plated holes and reviewed load models
2026-10-13 Refine v1.1 ground zones and local pad connections
2026-10-13 Use bare board finish and correct wire antenna assemblies
2026-10-13 Complete AS7331 v1.1 layout and green-mask pilot package
    Replace the UV circuit with the reviewed AS7331 design, restore selective
    green solder mask without silkscreen, and retain a U6-only DNP pilot
    assembly and stencil variant. Add the quiet UV-DNP firmware target.
    Record independent electrical, geometry, mask and population checks,
    and the saved JLC cart for five PCBs with three assembled pilots.
    Factory CAM and physical qualification remain pending; no order placed.
2026-10-14 Move GNSS feed clear of switching copper and restore ground reference
2026-10-14 Define top GNSS placement and assembled reception comparison
2026-10-14 Restore upward GNSS antenna and route feed around boost switching copper
2026-10-14 Record reproducible copper cleanup and top antenna power and assembly checks
2026-10-14 Publish independent top GNSS review and update hardware assembly guidance
2026-10-16 Package v1.1 KiCad project and parts libraries for download
2026-10-16 Record rerouted assembly orientation draft for fresh supplier review
2026-10-16 Verify footprints and models from fresh KiCad download bundles
2026-10-16 Rebuild pilot manufacturing and KiCad downloads from engineer review
2026-10-16 Document final reroute checks, local repairs and assembly review
2026-10-16 Document AS7331 external sourcing costs and assembly requirements
2026-10-16 Preserve final schematic cleanup with reviewed v1.1 geometry and rules
2026-10-16 Export final v1.1 UV population variants and refresh KiCad downloads
2026-10-16 Record UV assembly supplement sent with completed sourcing review
2026-10-21 Show the flight path by default on the dashboard
    Unifying the fleet and detail path switches (#129) made the shared switch
    default off, so new visitors no longer saw a balloon's reconstructed track.
    Default it on; saved preferences are unchanged.
2026-10-21 Add illustrated v1 payload assembly guide (#134)
2026-10-21 Fade the homepage story out just under the logo
    Story text scrolled up beneath the fixed header, where the logo's
    difference blend mixed the two into a smear. Add a top layer to the story
    window's mask, intersected with the cloud fade: text is transparent just
    below the logo (65% of the header height, where the centred logo ends)
    and fully visible 36px further down.
    The JS fallback used to drop the whole mask once the clouds left the
    frame, which would also drop this fade; it now pushes the cloud fade out
    of frame instead.
2026-10-21 Only fade the homepage story where it passes under the header
    The fade under the logo also hid text on desktop, where the story column
    sits clear of the logo and nav. main.js now checks on layout whether the
    column overlaps the logo, nav or menu button, and marks the story window
    when it doesn't; there the top fade is off. Phones (both orientations) and
    widths below 1024px keep it.
2026-10-23 Scrub mobile charts with press-and-drag
    Holding a finger on a telemetry chart for 200 ms turns it into the hover
    cursor until it lifts; a quick swipe still scrolls the drawer. Charts no
    longer start a text selection, copy callout, or tap flash on long-press.
2026-10-23 Rebuild the homepage sky at 2560 × 1440 from the original photograph
    The sky plate was 1672 × 941 and heavily compressed, so phones (which
    scale it ~2.8×) showed block artefacts in the clear sky. A new script,
    scripts/prepare-launch-sky.py, keeps the inpainted plate's colour and
    gradient everywhere and lays the original photograph's own grain over
    the clear sky, with matched synthetic grain where the city, clouds and
    balloon hide it. Colour is unchanged (same mean on a phone, same
    Safari bar tint); the file grows from 44 to 70 KB.
2026-10-23 Use a 1200 × 630 link-preview image cut from the original photograph
    Link previews (og:image, twitter:image) pointed at source.jpg: the full
    2560 × 1440 frame, compressed to 73 KB, which services then cropped
    themselves. Add social-card.jpg, the standard 1200 × 630 size, cut from
    the original photograph with the README banner's colour grade and the
    site wordmark (96 KB). The homepage, dashboard and blog index heads are
    updated by hand; docs pages pick it up from social-metadata.mjs.
2026-10-23 Loop the balloon in link previews: GIF og:image and MP4 og:video
    The site card now animates: the balloon rises out of frame, then the next
    rises from behind the clouds into place (8.9 s, one balloon at a time).
    og:image/twitter:image point at the 1.2 MB GIF, whose first frame is the
    still card, so apps that don't animate look unchanged; og:video points at
    the 290 KB MP4, which iMessage autoplays muted and looped. Blog posts keep
    their own photographs and get no video.
2026-10-23 Drag along telemetry charts to scrub the flight live
    Dragging a chart now drives the shared scrub time as it moves, so the
    time slider, chart markers and map balloon follow the pointer instead of
    jumping on release. The picked time is interpolated between plotted
    samples, so the balloon glides along its path.
    On touch there is no hold: a sideways drag scrubs at once while vertical
    swipes still scroll (touch-action: pan-y), and a tap jumps to that time.
    Once a scrub starts the chart claims the touch, since otherwise iOS hands
    a finger that rests before lifting to its long-press handling and the
    page never sees the touch end.
2026-10-23 Blog post: minimal flight figure, GPS fixes and the reconstructed path
    The opening figure now shows only what it is for: the distinct GPS fixes, and a
    toggle that draws the reconstructed path through them. Drops the metrics row,
    wind arrows, hover readout, packet timeline strip, slider and play button.
2026-10-23 Blog post: flight figure animates the path in instead of toggling
    No buttons: the GPS fixes are drawn from the start and the reconstructed path
    draws itself through them in flight time (4.5 s), each time the figure scrolls
    into view; reduced motion shows it complete. Card height fitted to the figure.
2026-10-23 Blog post: flight figure loops and is cropped to the flight
    The path draws in, holds for two seconds and starts again while the figure is on
    screen (paused off screen and in background tabs; complete under reduced
    motion). The map is cropped to 23–53°N, removing the empty band below the track.
2026-10-23 Keep the flight path and projection live between forecast runs
    The detail map drew the reconstructed path from the stored forecast, which is
    rebuilt only a few times a day, so every fix reported since the last run showed
    as an unconnected dot: the red line froze at the fix the forecast was built
    from, and the balloon marker glided along a projection it had already flown
    past. Append the newer fixes to the reconstructed track (the drawn line, the
    scrub target and the marker all follow it), and restart the projected path and
    its ensemble members from the newest fix, dropping the stretch already flown.
2026-10-23 Show the projected path by default
    The forecast is the dashboard's reason to exist for a flying balloon, so the
    layer should not have to be found in the settings menu first. A viewer who had
    switched it off keeps that choice through the saved preference.
2026-10-23 Count the fixes since the last forecast run in the flight's total distance
    The "total dist" vital summed only the stored forecast's reconstructed line,
    which ends at the fix the last run started from, so it sat at 22 km while
    stratolink-1 had flown 140 km past it. Continue the line through the fixes
    reported since, as the map already does.
2026-10-23 Show one chart marker that follows a scrub drag
    While dragging a chart, the hover cursor (snapped to the nearest plotted
    sample) and the scrub marker (on the packet at or before the scrub time)
    were drawn at different places, so the old position lingered beside the
    new one. The scrub marker now sits at the scrub time itself, riding the
    drawn line, and the hover cursor stands down while a drag is active, so
    a single marker tracks the pointer.
2026-10-23 Dashboard: load a balloon zoomed to its recent position
    Open a balloon page at zoom 7 on desktop (6 on mobile), centered on the
    last fix, instead of the near-whole-globe zoom of 1.5 / 0.8. A tightly
    clustered fleet may now fit in to the same zoom (was capped at 5); a
    spread-out fleet still frames every balloon.
2026-10-23 Dashboard menu: metric / imperial units toggle
    A Units group in the settings menu, saved in localStorage like the theme.
    Altitude, distance and temperature readouts on the fleet cards, the balloon
    detail panel (including trend-chart labels) and the legend's gateway ranges
    follow it; stored data, series and thresholds stay metric.
2026-10-23 Re-anchor the forecast on every new GPS fix from the last run's cubes
    Two-tier forecast pipeline. The scheduled ingest (4x/day, unchanged NOAA
    cadence) now builds every cube through now + HORIZON_H + 6 h and publishes
    each device's cube set to Blob under cubes/{device}/ (~2.5 MB). A new
    forecast-recompute workflow, fired by the TTN webhook via repository_dispatch
    "new-fix" for every stored GPS fix of a flying device, pulls that set onto a
    runner and re-runs only the compute from the newest fix (no Python, no GRIB).
    It skips when the device is not flying, the stored forecast already starts
    from the newest fix, or the cube set is missing or does not cover the fix.
    The webhook trigger is off t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
2026-10-23 Type the stored summary and keep the trailing debounce timer referenced
2026-10-23 Version the cube sets and skip recomputes the cubes cannot serve
    Review findings. An in-place overwrite of cubes/{device}/ let a run that
    built fewer members (an ensemble step killed at its timeout) sit beside the
    previous run's extra members, which the compute would list from disk as one
    mixed, "complete" ensemble. Each run now uploads a versioned set
    cubes/{device}/{set}/ and writes the manifest last, naming its files; the
    recompute downloads only those. The previous set is kept for a recompute in
    flight, older ones deleted.
    Three more skip rules: a set older than the cubes the stored forecast came
    from (a scheduled run stores before it uploads), a newest fix more than 6 h
    past the fix th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
2026-10-23 Add a force input to the recompute workflow
    Rebuild from the current cube set even when the stored forecast already
    starts from the newest fix (an operator rerun, like the ingest's force).
2026-10-23 Dashboard: live marker follows the current time along the forecast
    The live balloon marker sat at the last packet, or for a stale-GPS forecast at
    the moment the forecast was computed, and never moved with the clock. When GPS
    is dark (the forecast says so, or the last fix is over an hour old), live now
    carries the real clock along the forecast, ticking each minute, and parks at
    the forecast's end. A forecast older than the latest fix is no longer followed,
    so the marker can't snap back to a superseded estimate.
2026-10-24 Tighten dashboard panel spacing and hide scrollbars (#143)
2026-10-24 Homescreen: estimated positions for flying balloons, flying-time scrubber (#146)
    On the fleet homescreen a GPS-dark flying balloon is now drawn where its
    forecast puts it, not at its last fix: the shared live-estimate rule (now
    liveEstimateT in lib/telemetry/forecastTrack, also used by the detail view)
    carries the clock along the stored forecast, and scrubbing past the last fix
    follows the same line. A grey dashed leg joins the last fix to the marker;
    the forecast beyond "now" stays on the balloon's own page.
    The fleet scrubber covers only flying time: each balloon from its detected
    launch to its last packet (or estimated now), with the months between
    flights cut out and marked by a short b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
2026-10-24 Keep missing balloon camera centered on saved position
2026-10-24 Give the charted reading a tile row under the trend chart
    Temperature was the default trend chart but had no tile, so once
    another reading was selected nothing on the panel said temperature
    existed, and the only way back was an unlabelled ×. Add a Flight
    path reading row (Temperature, Pressure, Speed, Heading) that toggles
    the trend slot like the other rows do. The lit tile is always the
    charted series, Temperature is lit on load, and the × goes away.
    Pressure moves off the altitude header into its tile. Speed and
    heading reuse the existing flight series (km/h, degrees).
2026-10-24 Blog post: wind arrows back on the spread figure, over a wider wind field
    The background wind field now covers 128°W–42°E and 5.5–70.5°N (was 128°W–7°E,
    13–58°N), so the arrows reach as far as the balloons in the spread figure (and the
    comparison and meeting maps lose their cut-off edge). Same 2.5° lattice: the old
    area is byte-identical. 245 KB → 426 KB. The script can take the old winds.json
    in place of the recon cube for the window and float pressure.
2026-10-24 Blog post: tube, resolution and forecast figures loop without controls
    The last three figures lose their sliders, play buttons, readouts and hover text
    and play on the shared loop like the rest (the tube at five slices a second). The
    tube draws the flight path in red like the opening figure; the forecast keeps its
    spread chart, with a "forecast stops" label on the 2,000 km line. Removes the
    helpers nothing uses any more (player, slider, keyboard, readout and track-split
    code) and the heading's play button.
2026-10-24 Blog post: "How much jitter?" appendix section
    The eight-day gap rerun at 125 heading / speed / height spread settings (8,000
    balloons each way). New figure: a 5×5 heading × speed grid at ±8 hPa, shaded by
    how well each setting makes the two fixes agree and labeled with how far its line
    sits from today's; selecting a cell maps its paths and line against today's. Text:
    the line holds up across reasonable settings, the corridor width follows the speed
    spread, and the match score leans toward less heading jitter, with the caveat that
    it comes from one gap. Data from scripts/blog/wind_path_jitter_data.py.
2026-10-24 Blog post: forecast members in teal (GEFS) and violet (AIGEFS)
    Replaces the default-looking blue/orange pair. The two stay apart under simulated
    deutan, protan and tritan vision (OKLab ΔE 11–21) and the violet stays clear of the
    red forecast-ends marker.
2026-10-27 Show legacy regional-id telemetry in the public view
    Uplinks stored before the radio-identity webhook kept the raw TTN device id
    (e.g. stratolink-3-eu), so community_telemetry's devices join dropped them and
    140 stratolink-3 fixes over Spain on 2026-05-28 never reached the map. Resolve
    those rows through staff radio identities; owner integrations are excluded.
2026-10-27 Blog index: image-led cards and a wider Stratolink 1 image
    Recent entries and the All articles cards now share one layout: image,
    category, title, then date and read time. The Recent images stretch so the
    column ends level with the featured post. In the grid, titles reserve two
    lines and excerpts stop at three, so every card keeps the same spacing.
    The Stratolink 1 post image is re-rendered from SLIDER GeoColor as a
    900 x 562 km frame at 2400 x 1500, near the imagery's native 0.5 km, instead
    of an upscaled screenshot of the figure. post_image.py draws the track from
    the public flight.json, so the launch area stays masked.
2026-10-28 Flight figures: load the background video outright so iOS shows it
    WebKit on iOS (Safari and Chrome) stopped after the video's metadata and never
    finished the seek to the last frame, so the map stayed blank grey under the track.
2026-10-28 Frozen-GPS tail: carry the path to the last ping; dashboard skips repeats (#161)
    After the last real fix, a frozen GPS keeps re-sending that position while the
    balloon is still alive and drifting. The pipeline drops those repeats, so the
    reconstruction ended at the last fix, and the dashboard then appended the
    repeats back on as "newer fixes": the path and marker parked on the frozen
    position until the last ping (stratolink-3: 17:46 -> 18:55 UTC at Malaga).
    Compute
    - appendFrozenTail (pathReconstruction.ts): integrate the float-level wind
    from the last fix to the last ping (10-min midpoint steps, last one partial)
    and append it to reconstructed_path/track; observed.frozen_tail records t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
2026-10-28 Spain flight figure: receivers, the frozen tail and clearer labels
    - Receivers: the gateways that report a location (about a third) as triangles, with
    lines to the ones that heard each packet.
    - Window: 5:00 a.m. CEST May 28 to the last ping at 8:55 p.m. May 29. After the last
    fix the line follows the reconstruction's frozen tail along the winds; the map is
    re-cropped around Spain and the videos re-rendered.
    - Labels: only where it was first and last heard stay up; the rest show while their
    stretch plays. figure.js can give a label an end time and place it clear of the
    track and receiver lines, off the labels it shares the screen with. Place names keep
    out of the bottom strip.
    C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
2026-10-28 Flight figures: sharper imagery, per-screen video sizes, lazy loading
    - Stratolink 3: 1600 px backgrounds sharpened by day with GOES-18's 0.5 km red band
    (CONUS C02), plus 1080 px versions; figure.js loads the narrowest width that covers
    the map in screen pixels (flight.json video.widths).
    - Spain: GeoColour sharpened by day with MTG's 500 m VIS0.6 (HRFI) from EUMETView.
    - Videos load only when their figure nears view, not with the page.
    - Stratolink 3's California path follows the dashboard's current reconstruction, which
    now follows the winds while the GPS was stuck; label and caption updated.
    - stratolink3.py fetches scans in worker processes over keep-alive connections, with
    retr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
2026-10-28 Path post: refresh the flight figure from the current reconstruction
    The first figure of "Drawing the path between packets" was built on Oct 24,
    before frozen-GPS repeats were dropped and split fixes repaired (#159) and
    before the path ran on to the last packet (#161). Its flight.json now holds
    the reconstruction's fixes (38; the stray split fix over Spain is gone) and
    the dashboard's current line, which runs from the Málaga fix to the last
    packet at 18:55 UTC. The eight-day gap, which every other figure and number
    in the post describes, is unchanged (within 2 km).
    The figure script keeps the track's last point when it thins the track, so
    the path reaches the last packet.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
2026-11-08 Fix v1.1 assembly clearances beside radio and GNSS modules
2026-11-08 Export verified replacement pilot manufacturing and KiCad bundles
2026-11-08 Substitute available R1 resistor with matching electrical ratings
