Stratolink-hq/Stratolink/(notices)

Notices in the files:
web/ASSETS.md:
- `public/assets/docs/ttn-uplink-formatter.js`: current Stratolink decoder, MIT license retained in the file. It includes no credentials.
